Jordan-HT/Capstone/README.md

# Capstone
A capstone (senior) project for my BSEE at OIT
More updates to come
