Jordan-HT/Capstone/Documentation/PDN/Board Power Requirements.xlsx

Sheet: FPGA Requirements
Rail | Voltage (V) | Current (A) | Accuracy (%) | Accuracy (V) | Category | Description | Sequence | Notes
VCCINT | 1.000 | 8.800 | ±3 | 0.97-1.03 | Core | Internal supply voltage | 1
VCCAUX | 1.800 | 1.850 | ±5 | 1.71-1.89 | Core | Auxiliary supply voltage | 2
VCCBRAM | 1.000 | 0.165 | ±3 | 0.97-1.03 | Core | Supply voltage for BRAM | 1
VCCBATT | 1.445 | 1.5e-07 | +30 -20 | 1.00-1.89 | Core | Key memory battery backup supply | - | Connect to GND or VCCAUX for prototype
VMGTAVCC | 1.000 | 1.900 | +8 -3 | 0.97-1.08 | GTX | Analog supply voltage for the GTX transceiver | 1 | Each voltage supply requires the filter circuit described in UG476
VMGTAVTT | 1.200 | 1.000 | ±2.5 | 1.17-1.23 | GTX | Analog supply voltage for the GTX terminations | 2 | Each voltage supply requires the filter circuit described in UG476
VMGTVCCAUX | 1.800 | 0.100 | ±2.5 | 1.75-1.85 | GTX | Auxiliary analog QPLL voltage supply | 2 | Each voltage supply requires the filter circuit described in UG476
VMGTAVTTRCAL | 1.200 | 0.100 | ±2.5 | 1.17-1.23 | GTX | Analog supply voltage for the resistor calibration circuit | 2 | Each voltage supply requires the filter circuit described in UG476
VCCADC | 1.800 | 0.050 | ±5 | 1.71-1.89 | XADC | XADC supply relative to GNDADC | 2
VREFP | 1.250 | 0.010 | N/A | 1.20-1.30 | XADC | Externally supplied reference voltage (+) | 2 | Determines accuracy of the XADC system; make as accurate as possible
IO_XXX[P/N]_XX_VREF_nn | N/A | N/A | N/A | N/A | I/O | Externally supplied reference voltage for [nn] bank | - | Use internal VREF to free up these pins as normal I/O
VCCAUX_IO | 1.800 | 0.500 | ±5 | 1.71-1.89 | I/O | Auxiliary supply voltage for singled ended I/O on HP banks | 2 | Connect to VCCAUX unless fast DDR3 is needed. If so, re-spec to 2.0V
VCCO_32/33/34 | 1.800 | 2.250 | ±5 | 1.71-1.89 | I/O | Supply voltage for HP banks 32, 33, & 34 | 2
VCCO_12/13/15/16 | 1.800 | 1.000 | ±5 | 1.71-1.89 | I/O | Supply voltage for HR banks 12, 13, 15 & 16 | 2
VCCO_14 | 3.300 | 2.650 | ±5 | 3.14-3.47 | I/O | Supply voltage for HR bank 14 | 3 | Chosen as a 3.3V bank for GPIO and FLASH
VCCO_0 | 3.300 | 0.100 | ±5 | 3.14-3.47 | I/O | Supply voltage for bank 0 (configuration bank & JTAG) | 3
VCC_QSFP | 3.300 | 0.650 | ±5 | 3.14-3.47 | SFP | Supply voltage for QSFP+ modules | 3
VCC_FLASH_CORE | 3.300 | 0.200 | ±5 | 3.14-3.47 | MEM | Supply voltage for config memory core | 3 | Over worst-case when using S25FL128SAGMFBR00
VCC_FLASH_IO_(OPT) | 1.800 | 0.100 | ±5 | 1.71-1.89 | MEM | Supply voltage for config memory I/O | 2
VCC_CONN | 3.300 | 2.000 | ±5 | 3.14-3.47 | CONN | Supply voltage for connected devices | 3
VCC_CONN_IO | 1.800 | 1.200 | ±5 | 1.71-1.89 | CONN | Supply voltage for connected devices (Digital I/O) | 2

Sheet: Rail Specs
Rail name | Rail voltage (V) | Voltage accuracy requirement (%) | Rail current requirement (A) | TI Suggested Current (A) | Target max current (A) | Sequence | Notes | Implementation | Total max power (W): | 45.0175
3V3_STBY | 3.300 | ±5 | 0.500 | N/A | 0.650 | 0 | Always on | TPS74801DRCR from input rail (5V0). Set PG as master EN and gate with prog switch (https://www.mouser.com/ProductDetail/Texas-Instruments/TPS74801DRCR?qs=MiEMpo83RV6vgm8Iaojmyg%3D%3D)
3V3 | 3.300 | ±5 | 5.600 | 1.500 + CONN | 6.000 | 3 |  | TPS62870QWRXSRQ1 from input rail (5V0). Use SN74AUP1G58DRLR for EN gate (PWR_FAIL) (https://www.mouser.com/ProductDetail/Texas-Instruments/TPS62870QWRXSRQ1?qs=vvQtp7zwQdOlB9azhvOVww%3D%3D)
1V8 | 1.800 | ±2.5 | 7.050 | 3.200 + CONN | 8.000 | 2 |  | TPS62871QWRXSRQ1 from input rail (5V0) (https://www.mouser.com/ProductDetail/Texas-Instruments/TPS62871QWRXSRQ1?qs=rQFj71Wb1eWRjSwVt%2FOCTA%3D%3D)
1V25_REF | 1.250 | - | 0.010 | N/A | 0.100 | 2 or 3 | High accuracy req | REF35125(QDBVR) from 1V8 (https://www.mouser.com/ProductDetail/Texas-Instruments/REF35125QDBVR?qs=IPgv5n7u5QYKyzLKZBY3kg%3D%3D)
1V2 | 1.200 | ±2.5 | 1.100 | 0.750 | 1.500 | 2 |  | TPS628502DRLR from from input rail (5V0) (https://www.mouser.com/ProductDetail/Texas-Instruments/TPS628502DRLR?qs=Wj%2FVkw3K%252BMAYwjUrVjg5sw%3D%3D)
1V0 | 1.000 | ±3 | 10.865 | 9.500 | 12.000 | 1 |  | TPS62872QWRXSRQ1 from input rail (5V0) (https://www.mouser.com/ProductDetail/Texas-Instruments/TPS62872QWRXSRQ1?qs=rQFj71Wb1eXuKsnQxp828g%3D%3D)
