Jordan-HT/Capstone/Documentation/FPGA/Bank_Plan_Kintex7160T_2FFG676I.png

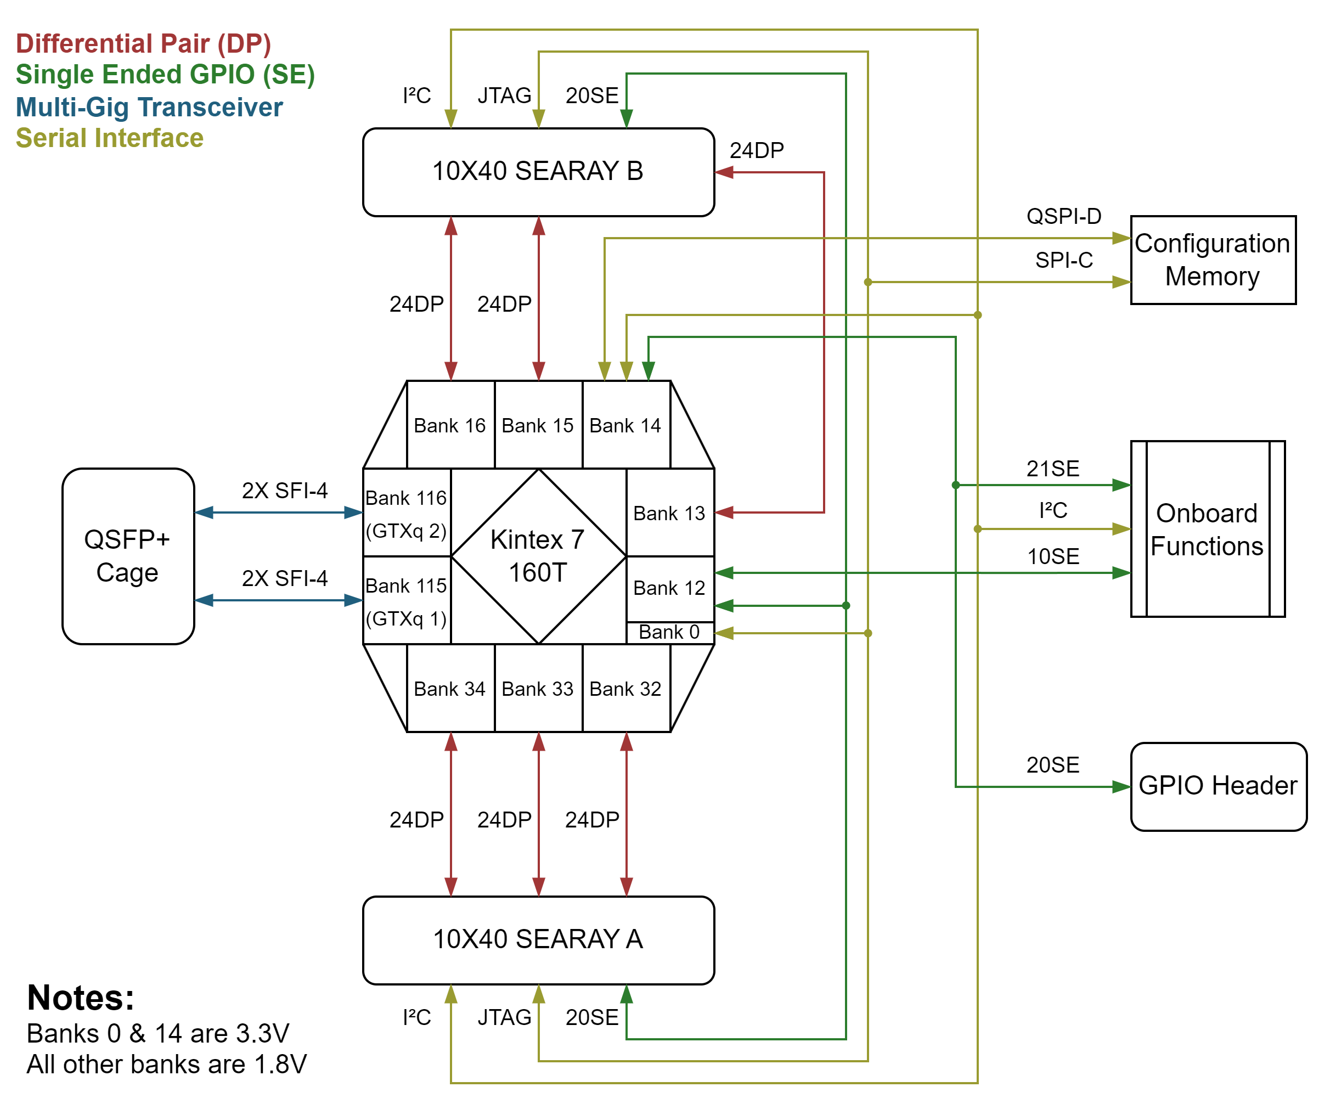
Documentation/FPGA/Bank_Plan_Kintex7160T_2FFG676I.png
