Jordan-HT/Capstone/Documentation/FPGA/Kintex7_160T_FFG676_Banks.png

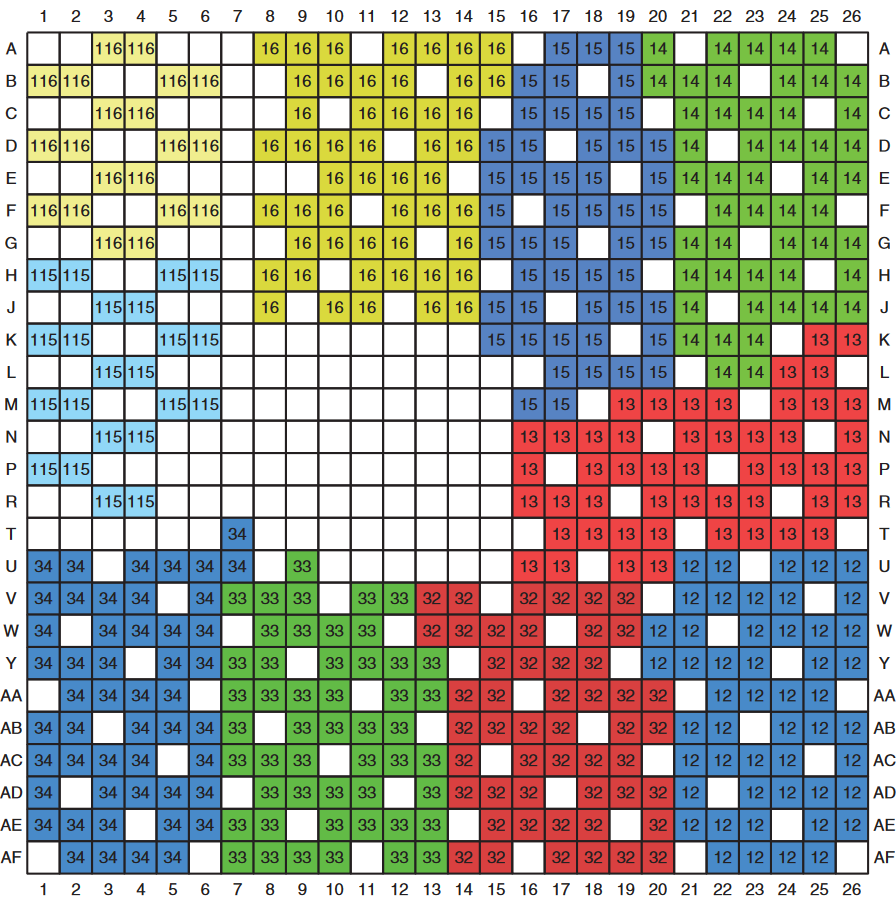
Documentation/FPGA/Kintex7_160T_FFG676_Banks.png
