Jordan-HT/Capstone/Altium/Capstone_Mainboard_B/Project Outputs for Capstone_Mainboard_B/Capstone_Mainboard_B_BOM.xlsx

Comment | Description | Designator | Footprint | Quantity | Manufacturer | Manufacturer Part Number | Manufacturer2 | Manufacturer2 Part Number
MT25QL128 | FLASH - NOR Memory IC 128Mbit SPI (Q)SPI 133 MHz 8-SO In ACA-SPI-004-K01 socket | A1, A2 | LOTES_ACA-SPI-004-K01 | 2 | Micron Technology Inc | MT25QL128ABA1ESE | LOTES | ACA-SPI-004-K01
0.1u | 0.1µF 16V X7R SMD ceramic capacitor in 0402 size | C1, C2, C4, C5, C6, C7, C8, C9, C10, C13, C15, C19, C20, C21, C22, C23, C24, C26, C28, C30, C32, C34, C36, C38, C41, C42, C50, C51, C59, C60, C70, C71, C90, C94, C100, C119, C120, C121, C122, C123, C124 | C_0402_Generic | 41 | Murata Electronics | GRM155R71C104KA88D
1u | 1µF 10V X7R SMD ceramic capacitor in 0402 size | C3, C11, C91, C95, C101 | C_0402_Generic | 5 | Murata Electronics | GRM155Z71A105KE01D
10u | 10µF 10V X5R SMD ceramic capacitor in 0402 size | C12, C16, C40, C43, C49, C52, C58, C61, C79, C85, C87, C88, C92, C93, C97 | C_0402_Generic | 15 | YAGEO | CC0402MRX5R6BB106
4.7u | 4.7µF 10V X5R SMD ceramic capacitor in 0402 size | C14, C69, C72, C78, C102, C103, C104, C110, C111, C112 | C_0402_Generic | 10 | Murata Electronics | GRM155R61A475MEAAJ
330u | 330µF 10V Aluminum polymer capacitor, KEMET EK | C17, C18, C80 | KEMET_EK_Radial | 3 | KEMET | A759EK337M1AAAE018
22u | 22µF 6.3V X5R SMD ceramic capacitor in 0603 size | C25, C27, C29, C31, C33, C35, C37, C39, C84, C86, C96, C98 | C_0603_Generic | 12 | Murata Electronics | GRM188R60J226MEA0D
270u | 270µF 2V 9mOhm SMD tantalum capacitor in EIA-3528-21size | C44, C45 | C_TANT_EIA-3528-21_A | 2 | Panasonic | 2TPSF270M9G
680p | 680pF 50V C0G/NP0 SMD ceramic capacitor in 0402 size | C46 | C_0402_Generic | 1 | Murata Electronics | GCM1555C1H681FA16D
10p | 10pF 50V C0G/NP0 SMD ceramic capacitor in 0402 size | C47, C48, C56, C57, C67, C68, C76, C77, C83 | C_0402_Generic | 9 | Murata Electronics | GRM1555C1H100JA01D
150u | 150µF 6.3V 25mOhm SMD tantalum capacitor in EIA-3528-21size | C53, C54 | C_TANT_EIA-3528-21_B | 2 | Vishay Polytech | T55B157M6R3C0025
2700p | 2700pF 50V X7R SMD ceramic capacitor in 0402 size | C55, C66 | C_0402_Generic | 2 | Murata Electronics | GCM155R71H272KA37D
47u | 47µF 6.3V X5R SMD ceramic capacitor in 0603 size | C62, C63, C64, C65, C73, C74, C89, C99, C113, C114, C115, C116, C117, C118 | C_0603_Generic | 14 | Murata Electronics | GRM188R60J476ME15D
6800p | 6800pF 25V X7R SMD ceramic capacitor in 0402 size | C75, C81, C82 | C_0402_Generic | 3 | Murata Electronics | GRM155R71E682KA01D
100u | 100µF 6.3V X5R SMD ceramic capacitor in 0805 size | C105, C106, C109 | C_0805_Generic | 3 | Murata Electronics | GRM21BR60J107ME15L
330u | 330µF 2.5V 15mOhm SMD tantalum capacitor in EIA-3528-21size | C107, C108 | C_TANT_EIA-3528-21_B | 2 | KEMET | T520B337M2R5ATE015
V30K45 | Schottky Diode 45V 30A FLATPAK, Vishay | D1 | Vishay_FlatPAK_5x6 | 1 | Vishay General Semiconductor | V30K45-M3/H
APB3025SEKCGKC-F01 | LED 1210 Green/Orange dual 2.1Vf 160deg 60/300 mcd@20mA | D2, D3, D4 | KINGBRIGHT_1210_DUAL | 3 | Kingbright | APB3025SEKCGKC-F01
USB4145-03-0230-C | USB 2.0 TYPE-C RECPT VERT XL TABS SMT | J1 | USB4145-03-0230-C | 1 | GCT | USB4145-03-0230-C
796638-3 | 3 Position Terminal Block Header, Male Pins, Shrouded NOTE: Mating wire-to-pin socket is 796635-3 | J2 | TE_796638-3 | 1 | TE Connectivity | 796638-3 | TE Connectivity | 796635-3
PH2-20-UA | THT Header 20 (2x10) position 0.1" | J3 | ADAM_TECH_PH2-20-UA | 1 | Adam Tech | PH2-20-UA
QSFP+ Cage/Conn | Amphenol 38 Position QSFP+ receptacle and cage | J4, J5 | AMPHENOL_U95T151100A | 2 | Amphenol ICC | U95-T151-100A | Amphenol ICC | FS1-Z38-20Z6-60
ASP-134486-01 | 400 Position Connector Array, Female Sockets Surface Mount Gold | J6, J7 | SAMTEC_ASP-134486-01 | 2 | Samtec | ASP-134486-01
TC-XILINX6_6PIN | 6-pin (legless) Xilinx JTAG Tag-Connect site | J8, J9, J10 | TAG-CONNECT_NO-LEGS_6PIN | 3 | NONE | NONE | Tag-Connect | TC2030-IDC-NL
U.FL | U.FL (UMCC) Connector, SMD, 50Ohm | J11, J12 | TE_IPEX | 2 | TE Connectivity | CONUFL001-SMD-T
1u | 1µH Shielded 3.3A 40mOhm 1008 Inductor | L1, L2, L3, L4, L5, L6 | Murata_Ind_1008 | 6 | Murata Electronics | DFE252012F-1R0M=P2
0.15u | Inductor 150nH 3.3mOhm 25.4A AEC-Q200, TDK | L7, L8, L9, L10 | TDK_CLT32 | 4 | EPCOS/TDK | CLT32-17N
M2.5 Mounting Hole | M.2 Mounting hole | MH1, MH2, MH3, MH4, MH5, MH6, MH7, MH8, MH9, MH10 | M2.5_MOUNTING_HOLE | 10 | NONE | NONE
4K7 | 4.7KOhm 1% 1/10W SMD resistor in 0402 size | R1, R2, R3, R37, R38, R39, R40, R41, R42, R43, R44, R45, R46, R47, R48, R49, R50, R51, R52, R53, R54, R55, R56, R57, R58, R59, R60, R61, R111, R117, R118, R122, R123, R124, R125, R126, R134, R135 | R_0402_Generic | 38 | Panasonic | ERJ-2RKF4701X
27R | 27Ohm 1% 1/10W SMD resistor in 0402 size | R4, R5, R127, R128, R129, R130 | R_0402_Generic | 6 | Panasonic | ERJ-2RKF27R0X
1K15 | 1.15KOhm 1% 1/10W SMD resistor in 0402 size | R6, R19, R96, R105, R136, R137, R138, R139 | R_0402_Generic | 8 | Panasonic | ERJ-2RKF1151X
10K | 10KOhm 1% 1/10W SMD resistor in 0402 size | R7, R8, R9, R10, R11, R12, R13, R14, R20, R84, R90, R97, R102, R107, R113 | R_0402_Generic | 15 | Panasonic | ERJ-2RKF1002X
3K57 | 3.57KOhm 1% 1/10W SMD resistor in 0402 size | R15, R104, R109, R114, R115, R116 | R_0402_Generic | 6 | Panasonic | ERJ-2RKF3571X
6K2 | 6.2KOhm 1% 1/10W SMD resistor in 0402 size | R16, R81, R110 | R_0402_Generic | 3 | Panasonic | ERJ-2RKF6201X
5K11 | 5.11KOhm 1% 1/10W SMD resistor in 0402 size | R17, R18, R83 | R_0402_Generic | 3 | Panasonic | ERJ-2RKF5111X
47K | 47KOhm 1% 1/10W SMD resistor in 0402 size | R21, R23, R24, R80, R82, R86, R87, R92, R93, R94, R99, R100, R106 | R_0402_Generic | 13 | Panasonic | ERJ-2RKF4702X
0 | Jumper 0Ohm SMD resistor in 0402 size | R22, R62, R63, R64, R65, R66, R67, R68, R69, R70, R71, R72, R73, R74, R75, R76, R77, R78, R79, R131, R132, R133 | R_0402_Generic | 22 | Panasonic | ERJ-2GE0R00X
1K | 1KOhm 1% 1/10W SMD resistor in 0402 size | R25, R26, R27, R28, R29, R30, R31, R32, R33, R34, R35, R36, R85, R88, R89, R91, R98, R103, R108 | R_0402_Generic | 19 | Panasonic | ERJ-2RKF1001X
261R | 261Ohm 1% 1/10W SMD resistor in 0402 size | R95, R101, R112 | R_0402_Generic | 3 | Panasonic | ERJ-2RKF2610X
49R9 | 49.9Ohm 0.5% 1/16W SMD resistor in 0402 size | R119, R120 | R_0402_Generic | 2 | Panasonic | ERJ-2RKD49R9X
100R | 100Ohm 0.5% 1/16W SMD resistor in 0402 size | R121 | R_0402_Generic | 1 | Panasonic | ERJ-2RHD1000X
KSC353J_LFG | Tactile Switch SPST-NO (MOM) SMD back actuator | SW1 | C&K_KSC_6.20 | 1 | C&K | KSC353J LFG
KSC401J_50SH_LFS | Tactile Switch SPST-NO (MOM) SMD red long actuator | SW2 | C&K_KSC_6.20 | 1 | C&K | KSC401J 50SH LFS
TDA04H0SB1R | Dip Switch SPST 4 Position 25mA 24VDC | SW3 | C&K_TDA_GULL_04POS | 1 | C&K | TDA04H0SB1R
THJP0612AST1 | ThermaWick Thermal Jumper 0612 | TJ1, TJ2 | ThermaWick_0612 | 2 | Vishay Dale | THJP0612AST1
RP2040_RUN Test Point | SMD Test point 3mm circle | TP1 | TP_3MM | 1 | NONE | NONE
3V3AUX Test Point | SMD Test point 3mm circle | TP2 | TP_3MM | 1 | NONE | NONE
SWCLK Test Point | SMD Test point 3mm circle | TP3 | TP_3MM | 1 | NONE | NONE
SWDIO Test Point | SMD Test point 3mm circle | TP4 | TP_3MM | 1 | NONE | NONE
SWDGND Test Point | SMD Test point 3mm circle | TP5 | TP_3MM | 1 | NONE | NONE
EXT I2C GND Test Point | SMD Test point 3mm circle | TP6 | TP_3MM | 1 | NONE | NONE
EXT I2C SDA Test Point | SMD Test point 3mm circle | TP7 | TP_3MM | 1 | NONE | NONE
EXT I2C SCL Test Point | SMD Test point 3mm circle | TP8 | TP_3MM | 1 | NONE | NONE
FPGA B14 L6N/VREF Test Point | SMD Test point 3mm circle | TP9 | TP_3MM | 1 | NONE | NONE
FPGA B14 L7P Test Point | SMD Test point 3mm circle | TP10 | TP_3MM | 1 | NONE | NONE
FPGA nRESET Test Point | SMD Test point 3mm circle | TP11 | TP_3MM | 1 | NONE | NONE
FPGA DOUT Test Point | SMD Test point 3mm circle | TP12 | TP_3MM | 1 | NONE | NONE
RP2040 | ARM Cortex-M0+ - Microcontroller IC 32-Bit Dual-Core 133MHz External Program Memory 56-QFN (7x7) | U1 | RP2040/SC0914 QFN-56 | 1 | Raspberry Pi | SC0914(7)
NSP4201MR6T1G | 4CH 6V Break 12V Clamp TVS Diode USB | U2 | ONSEMI_6-TSOP | 1 | onsemi | NSP4201MR6T1G
PCA9548A | 8-channel I 2 C-bus switch, 24-HVQFN | U3 | HVQFN24_NXP | 1 | NXP | PCA9548ABS,118
M24128-BFMH6TG | EEPROM 128Kbit I2C 1MHz 450 ns | U4 | STM_DFN5 | 1 | STMicroelectronics | M24128-BFMH6TG
TMP1075N | Temperature Sensor Digital, Local -40°C ~ 125°C 12 b SOT-563 | U5, U6, U7 | TI_SOT-563 | 3 | Texas Instruments | TMP1075NDRLR
TPS62873Q | Switching Voltage Regulators Automotive 2.7-V to 6-V input, 15-A, stackable, synchronous buck converter 16-VQFN-FCRLF -40 to 125C | U8, U9, U10, U11 | TPS6287x-Q1 | 4 | Texas Instruments | TPS62873QWRXSRQ1
TPS74801DRCR | LDO 1.5A 10-VSON | U12 | TI_10VSON_DRC0010J_ADDVIA | 1 | Texas Instruments | TPS74801DRCR
AP7176BFN-7 | LDO 0.8-3.12V 3A 10-UFDFN Diodes Incorporated | U13, U14, U15 | DIODES_INC_U-DFN3030-10 | 3 | Diodes Incorporated | AP7176BFN-7
XC7K160T-2 | Kintex-7 FPGA, 400 User I/Os, 8 GTX, 676-Ball BGA, Speed Grade 2, Industrial Grade, Pb-Free | U16 | FFG676_(XC7K160T-2FFG676I) | 1 | AMD/Xilinx | XC7K160T-2FFG676I
DSC1123CI2-156.2500T | MEMS OSC XO 156.2500MHZ LVDS SMD | U17 | Microchip_DSC1123CI2 | 1 | Microchip Technology | DSC1123CI2-156.2500T
DSC1123CI2-200.0000 | MEMS OSC XO 200.0000MHZ LVDS SMD | U18 | Microchip_DSC1123CI2 | 1 | Microchip Technology | DSC1123CI2-200.0000
514CCC000107BAG | I2C Programmable oscillator differential/single-ended 0.1-125 MHz | U19 | Si514_Size-B | 1 | Skyworks Solutions | 514CCC000107BAG
ECS-1612MV-120 | 12 MHz XO (Standard) CMOS Oscillator 1.6V ~ 3.63V Standby (Power Down) 4-SMD, No Lead | X1 | ECS 4-SMD (1.6X1.2) | 1 | ECS Inc | ECS-1612MV-120-CN-TR
