Jordan-HT/Capstone/Documentation/PDN/Kintex-7_Worst_Case_Est.xlsm

Sheet: Summary
 |  |  | Xilinx Power Estimator (XPE) - 2019.1.2 |  |  |  |  |  |  |  |  |  |  |  |  |  |  |  |  |  |  |  |  |  |  |  |  | 1 |  | Pkgs | 1 | CLKROW | CLKCOL | LUT | FF | BRAM | MMCM | PLL | DSP | GT | PCIE |  | 3.3 Pins | Pins | Banks | ThetaJA | ThetaJB
 |  | Spartan®-7, Artix®-7, Kintex®-7, Virtex®-7, Zynq®-7000 |  |  |  |  |  |  |  |  |  |  | Release: 14-Aug-2019 |  |  |  |  |  |  |  |  |  |  |  |  |  |  |  |  | FBG484 | 17 | 5 | 70 | 101400 | 202800 | 325 | 8 | 8 | 600 | 8 | 1 | 0 | 250 | 400 | 17 | 11.7 | 4
 |  |  |  |  |  |  |  |  |  |  |  |  |  |  |  |  |  |  |  |  |  |  |  |  |  |  |  |  |  | FBG676 | 2 | 1 |  | 70016 |  |  |  |  |  | 0
 |  |  |  |  |  |  |  |  |  |  |  |  |  |  |  |  |  |  |  |  |  |  |  |  |  |  |  |  |  | FFG676 |  | 1
Project |  |  |  |  |  |  |  |  |  |  |  |  |  |  |  |  |  |  |  |  |  |  |  |  |  |  |  |  |  | FBV484 |  |  |  |  |  |  |  |  |  | 0
Settings |  |  |  |  | Summary |  |  |  |  |  |  |  |  |  |  |  |  |  |  |  |  |  |  |  |  |  |  |  |  | FBV676
Device |  |  |  |  | Total On-Chip Power |  |  | 28.885 W |  |  | 10.18937876% | Transceiver…… |  | 2.943W |  |  |  |  |  |  |  |  |  |  |  |  |  |  |  | FFV676
Family | Kintex-7 |  |  |  |  |  |  |  |  |  | 54.49917071% | I/O……………… |  | 15.742W
Device | XC7K160T |  |  |  | Junction Temperature |  |  | 99.6 °C |  |  | 31.61437363% | Core Dynamic.. |  | 9.132W
Package | FFG676 |  |  |  | Thermal Margin |  |  | 0.4°C | 0.2W |  | 3.697076908% | Device Static….. |  | 1.068W |  |  |  |  |  |  |  |  |  |  |  |  |  | 10 | 27.92 | 0.11
Speed Grade | -2 |  |  |  | Effective ΘJA |  |  | 2.2 °C/W |  | Power supplied to off-chip devices… |  |  |  | 0.000W |  |  |  |  |  |  |  |  |  |  |  |  |  | 25 | 27.95 | 0.13
Temp Grade | Industrial |  |  |  |  |  |  |  |  |  |  |  |  |  |  |  |  |  |  |  |  |  |  |  |  |  |  | 40 | 27.99 | 0.18
Process | Typical |  |  |  | On-Chip Power |  |  |  |  |  | Power Supply |  |  |  |  |  |  |  |  |  |  |  |  |  |  |  |  | 55 | 28.08 | 0.26
Voltage ID Used | No |  |  |  | Resource |  |  | Power |  |  | Source |  | Voltage | Total (A) | Static | Active |  |  |  |  |  |  |  |  |  |  |  | 70 | 28.24 | 0.42 |  |  |  |  |  | static | 0
Characterization | Production |  |  |  |  |  | (Jump to sheet) | (W) | (%) |  | VCCINT |  | 1.000 | 8.771 | 0.805 | 7.965 |  |  |  |  |  |  |  |  |  |  |  | 85 | 28.50 | 0.68 |  |  |  |  |  |  | 1
 |  |  |  |  | Core Dynamic |  |  | 1.458 | 5.047239053 |  | VCCBRAM |  | 1.000 | 0.162 | 0.049 | 0.113 |  |  |  |  |  |  |  |  |  |  |  | 100 | 28.91 | 1.10 |  |  |  |  |  |  | 1
Environment |  |  |  |  |  |  |  | 3.401 | 11.77471862 |  | VCCAUX |  | 1.800 | 1.831 | 0.056 | 1.775 |  |  |  |  |  |  |  |  |  |  |  |  |  |  |  |  |  |  |  |  | 1
Junction Temperature |  |  | 99.6 °C |  |  |  |  | 1.859 | 6.434258056 |  | VCCAUX_IO |  | 2.060 | 0.000 | 0.000 | 0.000 |  |  |  |  |  |  |  |  |  |  |  | 0.97 | 28.30 |  |  |  |  |  |  |  | 1
Ambient Temp | 35.0 °C |  |  |  |  |  |  | 0.882 | 3.052685526 |  | VCCO 3.3V |  | 3.300 | 2.526 | 0.001 | 2.525 |  |  |  |  |  |  |  |  |  |  |  | 0.985 | 28.59 |  |  |  |  |  |  | 0.001 | 1
Effective ΘJA |  |  | 2.2 °C/W |  |  |  |  | 0.743 | 2.572507508 |  | VCCO 2.5V |  | 2.500 | 0.000 | 0.000 | 0.000 |  |  |  |  |  |  |  |  |  |  |  | 1 | 28.89 |  |  |  |  |  |  | 0 | 1
Airflow | 250 LFM |  |  |  |  |  |  | 0.784 | 2.713092859 |  | VCCO 1.8V |  | 1.800 | 3.130 | 0.001 | 3.129 |  |  |  |  |  |  |  |  |  |  |  | 1.015 | 29.19 |  |  |  |  |  |  | 0.001 | 1
Heat Sink | High Profile |  |  |  |  |  |  | 0.006 | 0.01987201133 |  | VCCO 1.5V |  | 1.500 | 0.000 | 0.000 | 0.000 |  |  |  |  |  |  |  |  |  |  |  | 1.03 | 29.51 |  |  |  |  |  |  | 0 | 1
ΘSA | 2.8 °C/W |  |  |  |  |  |  | 0.000 | 0 |  | VCCO 1.35V |  | 1.300 | 0.000 | 0.000 | 0.000 |  |  |  |  |  |  |  |  |  |  |  |  |  |  |  |  |  |  |  | 0 | 1
Board Selection | Small (4"x4") |  |  |  | I/O |  |  | 15.742 | 54.49917071 |  | VCCO 1.2V |  | 1.200 | 0.000 | 0.000 | 0.000 |  |  |  |  |  |  |  |  |  |  |  |  |  |  |  |  |  |  |  | 0 | 1
# of Board Layers | 8 to 11 |  |  |  | Transceiver |  |  | 2.943 | 10.18937876 |  | MGTVCCAUX |  | 1.800 | 0.042 | 0.001 | 0.041 |  |  |  |  |  |  |  |  |  |  |  |  |  |  |  |  |  |  |  |  | 1
ΘJB | 4.0 °C/W |  |  |  |  |  |  | 0.000 | 0 |  | MGTAVCC |  | 1.000 | 1.866 | 0.061 | 1.805 |  |  |  |  |  |  |  |  |  |  |  |  |  |  |  |  |  |  |  |  | 1
Board Temperature | 25.0 °C |  |  |  |  |  |  | 0.000 | 0 |  | MGTAVTT |  | 1.200 | 0.590 | 0.007 | 0.583 |  |  |  |  |  |  |  |  |  |  |  | Temp | 50 | 85 | 100 |  |  |  |  |  | 1
 |  |  |  |  |  |  |  | 0.000 | 0 |  | - |  | 1.850 | 0.000 | 0.000 | 0.000 |  |  |  |  |  |  |  |  |  |  |  | Typical (1.0V) | 28.05 | 28.50 | 28.9145924 |  |  |  |  | 0 | 1
Implementation |  |  |  |  | Device Static | 1.068 |  | 1.068 | 3.697076908 |  | - |  | 1.100 | 0.000 | 0.000 | 0.000 |  |  |  |  |  |  |  |  |  |  |  | Maximum (1.03V) | 28.75 | 29.53 | 30.19191886 |  |  |  |  | 0 | 1
Optimization | Default |  |  | 1 |  |  |  |  |  |  | - |  | 1.100 | 0.000 | 0.000 | 0.000 |  |  |  |  |  |  |  |  |  |  |  |  |  |  |  |  |  |  |  | 0 | 1
 |  |  |  |  |  |  |  |  |  |  | - |  | 1.500 | 0.000 | 0.000 | 0.000 |  |  |  |  |  |  |  |  |  |  |  |  |  |  |  |  |  |  |  |  | 1
Messages |  |  |  |  |  |  |  |  |  |  | - |  | 1.800 | 0.000 | 0.000 | 0.000 |  |  |  |  |  |  |  |  |  |  |  |  |  |  |  |  |  |  |  |  | 1
 |  |  |  |  |  |  |  |  |  |  | - |  | 1.800 | 0.000 | 0.000 | 0.000 |  |  |  |  |  |  |  |  |  |  |  |  |  |  |  |  |  |  |  |  | 1
 |  |  |  |  |  |  |  |  |  |  | VCCADC |  | 1.800 | 0.021 | 0.020 | 0.001 |  |  |  |  |  |  |  |  |  |  |  |  |  |  |  |  |  |  |  | 0.02 | 1
XILINX Power Advantage (check for updates) (http://www.xilinx.com/products/technology/power/index.htm) |  |  |  | File Support Request (WebCase) (https://www.xilinx.com/support.html) |  |  |  |  |  |  | Xilinx Power Estimator User Guide (http://www.xilinx.com/cgi-bin/docs/rdoc?l=en;v=latest;d=ug440-xilinx-power-estimator.pdf)
© Copyright 1994-2019 Xilinx, Inc. All Rights Reserved |  |  |  | Introduction to XPE (video) (http://www.xilinx.com/training/vivado/using-the-xilinx-power-estimator.htm) |  |  |  | Whitepaper - 7 Steps for Worst Case Power Estimation (http://www.xilinx.com/support/documentation/white_papers/wp353.pdf)
Legend |  | User Entry |  |  | Calculated Value |  | Summary Value |  |  | User Override |  | Warning |  | Error
 |  |  |  |  |  |  |  |  |  |  |  |  |  |  |  |  |  |  | JEDEC | 7.5
 |  |  |  |  | Piccq | Iccauxq | Tj | Iccq |  |  |  |  |  |  |  |  |  |  | BoardType | 1 |  | Airflow | Opt | Leakage | 1.068 | 805.3106852 | Utilization
 |  |  |  | 0.04889450342 | 0 | 0.05610904591 | 99.13452462 | 0.8021941101 | Non-int Leakage | 0.1091 |  |  |  |  |  |  |  |  | BoardLyr | 1 |  | N/A | Default | CLOCK | 1.4579025 | 48.89450342
 |  |  | Temp | 99.13452462 | 0 | 0.0562628304 | 99.24375758 | 0.8051067988 | Scaled ICCQ_D | 0.0428 |  |  |  | Max Adj | Typ Adj |  |  |  | Airflow | 1 |  | 0 | Power Optimization | LOGIC | 3.401144968 | 56.27359558
 |  |  | Initial | 97.39240871 | 0 | 0.05627289126 | 99.25089206 | 0.8052973458 | Non-aux Leakage | 0.1207 |  |  | MMF Factor | 1 | 1 |  |  |  | Heatsink | 4 |  | 250 | Powered Off | BRAM | 1.858545 | 0
 |  |  | Max | 125 | 0 | 0.05627354951 | 99.2513588 | 0.8053098127 | Scaled ICCAUXQ_D | 0.1502 |  |  | MMF Aux | 1 | 1 |  |  |  | Pkg size | 729 |  | 500 | Y44:Y45 | DSP | 0.88177275 | 1
 |  |  |  |  | 0 | 0.05627359258 | 99.25138934 | 0.8053106284 | Iccint_c1 | 2.692687131e-05 |  |  | MMF Bram | 1 | 1 |  |  |  | Air | 228.6236854 |  | 750 |  | PLL | 0.743072616 | 0
 |  |  |  |  | 0 | 0.0562735954 | 99.25139133 | 0.8053106817 | Iccint_c2 | 0.0086 |  |  | VID Factor | 1 |  |  |  |  | ThetaSA | 2.800 |  | X46:X47 |  | MMCM | 0.7836809035 | 1
 |  |  |  |  | 0 | 0.05627359558 | 99.25139146 | 0.8053106852 | Iccintq_d | 0.0399 |  |  | Bali Factor | 1 |  |  |  |  | ThetaCS | 0.100 |  |  |  | PHASER | 0 | 0
 |  |  |  |  |  |  |  |  | Iccintq_des | 0.0428 |  |  | Vccint | 5.97433655e-06 | 2.692687131e-05 | 0.00856550694 | 0.8650776558 | 10.18509974 | ThetaJB | 4.000 |  |  |  | PCIE | 0 | 0
 |  |  |  |  |  |  |  |  | Iccaux_c1 | -4.061474262e-06 |  |  | Vccaux | 3.394515455e-07 | -4.061474262e-06 | 0.001063242872 | -0.008234017716 | 17.64789461 | ThetaJA | 6.698 |  |  |  | IO | 15.74216644 | 0
 |  |  |  |  |  |  |  |  | Iccaux_c2 | 0.0011 |  |  | Vccbram | 2.790738785e-07 | -5.712713873e-06 | 4.518674537e-05 | 0.0292292509 | 0.1271399549 | ThetaJX | 6.899 |  |  |  | GTX | 2.943217194 | 0.7452186936
 |  |  |  |  |  |  |  |  | Iccauxq_d | 0.0182 |  |  |  |  |  |  |  |  | eThetaJA | 2.237 |  |  |  |  | 0 | 61.32305353
 |  |  |  |  |  |  |  |  | Iccoq | 0.0010 |  |  |  |  |  |  |  |  | TJA-Top | 3.210 |  |  |  |  |  | 7.20337527
 |  |  |  |  |  |  |  |  | Iccbram_c1 | -5.712713873e-06 |  |  |  |  |  |  |  |  | TJ | 81.988 |  |  |  |  |  | 0
 |  |  |  |  |  |  |  |  | Iccbram_c2 | 4.518674537e-05 |  |  |  |  |  |  |  |  | eThetaJA | 1.631 |  |  |  |  |  | 0
 |  |  |  |  |  |  |  |  | Iccbramq | 0.0039 | 0.002925 | 19.26616833 |  |  |  |  |  |  | Power | 29.749 |  |  |  |  |  | 0
 |  |  |  |  |  |  |  |  | Process | 1.0000 |  |  |  |  |  |  |  |  | Power2 |  |  |  |  |  |  | 0
 |  |  |  |  |  |  |  |  | I-Grade | 0.8651 |  |  |  |  |  |  |  |  | Temp | 125.000 |  |  |  |  |  | 0
 |  |  |  |  |  |  |  |  | Q-Grade | 10.1851 |  |  |  |  |  |  |  |  | Temp | 83.526 |  |  |  |  |  | 0
 |  |  |  |  |  |  |  |  | I-Grade | -0.0082 |  |  |  |  |  |  |  |  | Temp | 124.54 |  |  |  |  |  | 20
 |  |  |  |  |  |  |  |  | Q-Grade | 17.6479
 |  |  |  |  |  |  |  |  | I-Grade | 0.0292 |  |  |  | PowerUp | Int | Aux | I/O | Aux_io | Bram | Avcc | Avtt | GTVccaux
 |  |  |  |  |  |  |  |  | Q-Grade | 0.1271 |  |  |  | Adder | 0.55 | 0.05 | 0.04 | 0.04 | 0.04 | 0.4 | 0.15 | 0.04
 |  |  |  |  |  |  |  |  | Vcc_c1 | 0.0794 |  |  |  | Min | 0 | 0 | 0 | 0 | 0 | 0 | 0 | 0
 |  |  |  |  |  |  |  |  | Vcc_c2 | 2.5327
 |  |  |  |  |  |  |  |  | VccScale | 0.9994
 |  |  |  |  |  |  |  |  | VccAuxScale | 1
 |  |  |  |  |  |  |  |  | VccBramScale | 0.9994
 |  |  |  |  |  |  |  |  | AVccScale | 0.9994
 |  |  |  |  |  |  |  |  | Max bram | 0.02749303918
 |  |  |  |  |  |  |  |  | Max PS | 0
 |  |  |  |  |  |  |  |  | Max Aux | 0.1032130833
 |  |  |  |  |  |  |  |  | Max Int | 0.806708461
 |  |  |  |  |  |  |  |  | Max Ambient | 35.52017995
 |  |  |  |  |  |  |  |  | AuxSpecialFact | 1
 |  |  |  |  |  |  |  |  | Oly | 0

Sheet: Snapshot
 | Power Comparison Snapshots
Settings
Part
Ambient Temperature
Process
Implementation
Summary
Total On-Chip Power
Junction Temperature
Effective ΘJA
On-Chip Power
Clocking
Logic
I/O
BRAM
DSP
Transceiver
PS
Device Static
Supply Summary
VCCINT
VCCBRAM
VCCAUX
VCCAUX_IO
VCCO 3.3V
VCCO 2.5V
VCCO 1.8V
VCCO 1.5V
VCCO 1.35V
VCCO 1.2V
MGTVCCAUX
MGTAVCC
MGTAVTT
MGTZVCCH
MGTZAVCC
MGTZVCCL
VCCPINT
VCCPAUX
VCCPLL
VCCO_DDR
VCCO_MIO0
VCCO_MIO1
VCCADC

Sheet: Graphs
On-Chip Power over Vccint - (Typical, 99C)
On-Chip Power - (Typical, 1V)
On-Chip Power by Function - (Typical, 1V, 99C)

Sheet: IP_Manager
IP Manager |  |  |  |  |  |  |  |  |  | IP Catalog
 |  |  |  |  |  |  |  |  |  | Block Memory
Device |  |  | On-Chip Summary |  |  |  |  |  |  | Distributed Memory
Part | XC7K160TFFG676-2I |  | Junction Temp |  | 99.6 °C |  |  |  |  | Memory Interface
Process | Typical |  | Static Power |  | 1.068 W |  |  |  |  | Transceiver Interface
Effective ΘJA | 2.2 °C/W |  | Total Power |  | 28.885 W
Implementation | Default
IP Modules |  | Power (W) | Clocking* | Logic | I/O* | BRAM | DSP | Transceiver* | Source | Clock | PLL | MMCM | Logic | I/O | Phaser | BRAM | DSP | PCIE | GTP/X/H | GTZ
System |  | 7.599 | 1.458 | 3.401 |  | 1.859 | 0.882 |  | XPE Generated | B10 |  |  | B12 |  |  | B10 | B8
29

Sheet: Clock
Clock Tree Power |  |  |  |  |  |  |  |  |  |  |  |  | 700 | 32 | 30 | 20
Power |  |  |  | Utilization |  |  |  | Clocking Resources User Guide (http://www.xilinx.com/support/documentation/user_guides/ug472_7Series_Clocking.pdf)
VCCINT | 1.000V | 1.458W |  | Global | 1 | 3.125%
5% of total on-chip power 28.885W |  |  |  | Regional | 0 | 0% |  | XPE User Guide (http://www.xilinx.com/cgi-bin/docs/rdoc?l=en;v=latest;d=ug440-xilinx-power-estimator.pdf)
 |  |  |  | I/O | 0 | 0%
 |  |  |  | Other | 0 | - |  | Introduction to XPE (video) (http://www.xilinx.com/training/vivado/using-the-xilinx-power-estimator.htm)
Name |  |  | Frequency (MHz) | Type | Fanout | Clock Buffer Enable | Slice Clock Enable | Power (W) |  | HROW | LEAF | Local | HROW Utilization | LEAF Utilization | Slices
System |  |  | 500.0 | Global | 204050 | 100% | 50% | 1.458 | 0.465 | 10.675 | 287 | 1159.7625 | 10 | 700 | 25350
 |  |  |  | Global |  | 100% | 50% | 0.000 | 0 | 0 | 0 | 0 | 0 | 0 | 0
 |  |  |  | Global |  | 100% | 50% | 0.000 | 0 | 0 | 0 | 0 | 0 | 0 | 0
 |  |  |  | Global |  | 100% | 50% | 0.000 | 0 | 0 | 0 | 0 | 0 | 0 | 0
 |  |  |  | Global |  | 100% | 50% | 0.000 | 0 | 0 | 0 | 0 | 0 | 0 | 0
 |  |  |  | Global |  | 100% | 50% | 0.000 | 0 | 0 | 0 | 0 | 0 | 0 | 0
 |  |  |  | Global |  | 100% | 50% | 0.000 | 0 | 0 | 0 | 0 | 0 | 0 | 0
 |  |  |  | Global |  | 100% | 50% | 0.000 | 0 | 0 | 0 | 0 | 0 | 0 | 0
 |  |  |  | Global |  | 100% | 50% | 0.000 | 0 | 0 | 0 | 0 | 0 | 0 | 0
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
 |  |  |  | Global |  | 100% | 50% | 0.000 | 0 | 0 | 0 | 0 | 0 | 0 | 0
 |  |  |  | Global |  | 100% | 50% | 0.000 | 0 | 0 | 0 | 0 | 0 | 0 | 0
 |  |  |  | Global |  | 100% | 50% | 0.000 | 0 | 0 | 0 | 0 | 0 | 0 | 0
 |  |  |  | Global |  | 100% | 50% | 0.000 | 0 | 0 | 0 | 0 | 0 | 0 | 0
191

Sheet: Logic
Logic Power
Power |  |  |  | Utilization |  |  |  |  | CLB User Guide (http://www.xilinx.com/support/documentation/user_guides/ug474_7Series_CLB.pdf)
VCCINT | 1.000V | 3.401W |  | Registers |  | 202800 | 100%
12% of total on-chip power 28.885W |  |  |  | LUTs |  | 101400 | 100% |  | XPE User Guide (http://www.xilinx.com/cgi-bin/docs/rdoc?l=en;v=latest;d=ug440-xilinx-power-estimator.pdf)
 |  |  |  | Combinatorial |  | 101400 | 100%
 |  |  |  | Shift Registers |  | 0 | 0% |  | Introduction to XPE (video) (http://www.xilinx.com/training/vivado/using-the-xilinx-power-estimator.htm)
 |  |  |  | Distributed RAMs |  | 0
Name |  |  | Clock (MHz) | LUTs as |  |  | Registers | Toggle Rate | Average Fanout | Signal Rate (Mtr/s) | Power (W) | Routing
 |  |  |  | Logic | Shift Registers | Distributed RAMs
System |  |  | 500.0 | 101400 |  | 0 | 202800 | 12.5% | 3.00 | 62.5 | 3.401 | 0.0003987701
 |  |  |  |  |  |  |  | 12.5% | 3.00 | 0.0 | 0.000 | 0.0003987701
 |  |  |  |  |  |  |  | 12.5% | 3.00 | 0.0 | 0.000 | 0.0003987701
 |  |  |  |  |  |  |  | 12.5% | 3.00 | 0.0 | 0.000 | 0.0003987701
 |  |  |  |  |  |  |  | 12.5% | 3.00 | 0.0 | 0.000 | 0.0003987701
 |  |  |  |  |  |  |  | 12.5% | 3.00 | 0.0 | 0.000 | 0.0003987701
 |  |  |  |  |  |  |  | 12.5% | 3.00 | 0.0 | 0.000 | 0.0003987701
 |  |  |  |  |  |  |  | 12.5% | 3.00 | 0.0 | 0.000 | 0.0003987701
 |  |  |  |  |  |  |  | 12.5% | 3.00 | 0.0 | 0.000 | 0.0003987701
 |  |  |  |  |  |  |  | 12.5% | 3.00 | 0.0 | 0.000 | 0.0003987701
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
 |  |  |  |  |  |  |  | 12.5% | 3.00 | 0.0 | 0.000 | 0.0003987701
 |  |  |  |  |  |  |  | 12.5% | 3.00 | 0.0 | 0.000 | 0.0003987701
 |  |  |  |  |  |  |  | 12.5% | 3.00 | 0.0 | 0.000 | 0.0003987701
 |  |  |  |  |  |  |  | 12.5% | 3.00 | 0.0 | 0.000 | 0.0003987701
 |  |  |  |  |  |  |  | 12.5% | 3.00 | 0.0 | 0.000 | 0.0003987701

Sheet: GTX
GTX Transceiver Power |  |  |  |  |  |  |  |  |  |  |  |  |  |  |  |  |  |  |  |  |  |  |  | TRUE | 1 | 10.3125 |  | CPLL VCO range (MHz) | LC VCO range (MHz) |  |  | Raised Voltage |  |  |  |  |  |  |  |  |  |  |  | AV2:AV17
 |  |  |  |  |  |  |  |  |  |  |  |  |  |  |  |  |  |  |  |  |  |  |  |  |  |  |  | 1.2 | 5.93 | 9.8 |  | 0 |  |  |  |  |  |  |  |  |  |  | PCIe |  | 250 | 269
Active Current |  |  |  | Power |  |  |  |  | 2.943W |  | Utilization |  |  |  |  |  |  | Transceivers User Guide (http://www.xilinx.com/support/documentation/user_guides/ug476_7Series_Transceivers.pdf) |  |  |  |  |  |  | Iccq | 9.6 |  | 3.3 | 8 | 12.5 |  |  |  |  |  |  |  |  |  |  |  |  |  |  | 300 | 336
Source |  | Active |  |  |  |  |  |  |  |  | GTX Channels |  | 8 | 100% |  |  |  |  |  |  |  |  |  |  |  |  |  |  |  |  |  |  |  |  |  |  |  |  |  |  |  |  |  |  | 350 | 407
VCCINT | 1.000V | 0.364A |  | Source | Power |  | PCIe | PCS | PMA |  | PCIe Blocks |  | 0 | 0% |  |  |  | XPE User Guide (http://www.xilinx.com/cgi-bin/docs/rdoc?l=en;v=latest;d=ug440-xilinx-power-estimator.pdf) |  |  |  |  |  |  |  |  |  |  |  |  |  |  |  |  |  |  |  |  |  |  |  |  |  |  | 400 | 474
MGTVCCAUX | 1.800V | 0.041A |  | VCCINT | 0.364W |  | 0.000W | 0.364W | 2.579W |  |  |  |  |  |  |  |  |  |  |  |  |  |  |  |  |  |  |  |  |  |  |  |  |  |  |  |  |  |  |  |  |  |  |  | 450 | 543
MGTAVCC | 1.000V | 1.805A |  | MGTVCCAUX | 0.075W |  |  |  |  |  | Power Planes |  | 1 |  |  |  |  | Introduction to XPE (video) (http://www.xilinx.com/training/vivado/using-the-xilinx-power-estimator.htm) |  |  |  |  |  |  |  |  |  |  |  |  |  |  |  |  |  |  |  |  |  |  |  |  |  |  | 500 | 609
MGTAVTT | 1.200V | 0.583A |  | MGTAVCC | 1.805W |  |  |  |  |  |  |  |  |  |  |  |  |  |  |  |  |  |  |  |  |  |  |  |  |  |  |  |  |  |  |  |  |  |  |  |  |  |  |  | 550 | 677
 |  |  |  | MGTAVTT | 0.699W | 10% of total on-chip power 28.885W |  |  |  |  | BSCAN |  |  |  |  |  |  |  |  |  |  |  |  |  |  |  |  |  |  |  |  |  |  |  |  |  |  |  |  |  |  |  |  |  | 600 | 741
 |  |  |  |  |  |  |  |  |  |  |  |  |  |  |  |  |  |  |  |  |  |  |  |  |  |  |  |  |  |  |  |  |  |  |  |  |  |  |  |  |  |  |  |  | 650 | 807
 |  |  |  |  |  |  |  | RX |  |  |  | TX |  |  |  |  |  |  |  |  |  |  |  |  |  |  |  |  |  |  |  |  |  |  |  |  |  |  |  |  |  |  |  |  | 700 | 866
Name |  |  | GTX Channels | Operational Mode | EyeScan | Power Mode | Channels Sharing QPLL | Clock Source | Data Rate (Gb/s) | Data Path | Data Mode | Clock Source | Data Rate (Gb/s) | Data Path | Data Mode | O/P (mV) | OOB Used | Hard PCIe | VCCINT Power (W) | MGTVCCAUX Power (W) | MGTAVCC Power (W) | MGTAVTT Power (W) |  | Operate Mode | Quads | RX VCO LC (MHz) | TX VCO LC (MHz) | RX VCO CPLL (MHz) | TX VCO CPLL (MHz) | RX USERCLK | TX USERCLK | RX Power Mode | TX Voltage Swing Current | AVTT Current (CPLL) | AVTT Current (LC) | AVCC Current (RX) | AVCC Current (TX) | AVCC Current (CPLL) | AVCC Current (LC) | AVCC CLK | AVTT CLK |  |  | PCIe | 750 | 924
 |  |  | 2 | Transceiver | Off | DFE | 4 | QPLL | 10.1350 | 64 | 64b/66b | QPLL | 10.1350 | 64 | 64b/66b | 543 | No |  | 0.091 | 0.019 | 0.451 | 0.175 |  | 3 | 1 | 10135 | 10135 | 5067.5 | 5067.5 | 316.71875 | 316.71875 | 1 | 10.035 | 0 | 7.588257645 | 123.2014 | 60.28599167 | 0 | 16.52049587 | 25.6 | 1.55 | 10.135 | 10.135 | 0 | 800 | 973
 |  |  | 2 | Transceiver | Off | DFE | 4 | QPLL | 10.1350 | 64 | 64b/66b | QPLL | 10.1350 | 64 | 64b/66b | 543 | No |  | 0.091 | 0.019 | 0.451 | 0.175 |  | 3 | 1 | 10135 | 10135 | 5067.5 | 5067.5 | 316.71875 | 316.71875 | 1 | 10.035 | 0 | 7.588257645 | 123.2014 | 60.28599167 | 0 | 16.52049587 | 25.6 | 1.55 | 10.135 | 10.135 | 0 | 850 | 1018
 |  |  | 2 | Transceiver | Off | DFE | 4 | QPLL | 10.1350 | 64 | 64b/66b | QPLL | 10.1350 | 64 | 64b/66b | 543 | No |  | 0.091 | 0.019 | 0.451 | 0.175 |  | 3 | 1 | 10135 | 10135 | 5067.5 | 5067.5 | 316.71875 | 316.71875 | 1 | 10.035 | 0 | 7.588257645 | 123.2014 | 60.28599167 | 0 | 16.52049587 | 25.6 | 1.55 | 10.135 | 10.135 | 0 | 900 | 1056
 |  |  | 2 | Transceiver | Off | DFE | 4 | QPLL | 10.1350 | 64 | 64b/66b | QPLL | 10.1350 | 64 | 64b/66b | 543 | No |  | 0.091 | 0.019 | 0.451 | 0.175 |  | 3 | 1 | 10135 | 10135 | 5067.5 | 5067.5 | 316.71875 | 316.71875 | 1 | 10.035 | 0 | 7.588257645 | 123.2014 | 60.28599167 | 0 | 16.52049587 | 25.6 | 1.55 | 10.135 | 10.135 | 0 | 950 | 1092
 |  |  |  | Transceiver | Off | Low Power | 4 | QPLL | 5.0000 | 32 | 8b/10b | QPLL | 5.0000 | 32 | 8b/10b | 269 | No |  | 0.000 | 0.000 | 0.000 | 0.000 |  | 3 | 0 | 10000 | 10000 | 2500 | 2500 | 125 | 125 | 0 | 5.575 | 0 | 7.579332025 | 53.875 | 43.53733333 | 0 | 16.46694215 | 25.6 | 1.55 | 10 | 10 | 0 | 1000 | 1119
 |  |  |  | Transceiver | Off | Low Power | 4 | QPLL | 5.0000 | 32 | 8b/10b | QPLL | 5.0000 | 32 | 8b/10b | 269 | No |  | 0.000 | 0.000 | 0.000 | 0.000 |  | 3 | 0 | 10000 | 10000 | 2500 | 2500 | 125 | 125 | 0 | 5.575 | 0 | 7.579332025 | 53.875 | 43.53733333 | 0 | 16.46694215 | 25.6 | 1.55 | 10 | 10 | 0
 |  |  |  | Transceiver | Off | Low Power | 4 | QPLL | 5.0000 | 32 | 8b/10b | QPLL | 5.0000 | 32 | 8b/10b | 269 | No |  | 0.000 | 0.000 | 0.000 | 0.000 |  | 3 | 0 | 10000 | 10000 | 2500 | 2500 | 125 | 125 | 0 | 5.575 | 0 | 7.579332025 | 53.875 | 43.53733333 | 0 | 16.46694215 | 25.6 | 1.55 | 10 | 10 | 0
 |  |  |  | Transceiver | Off | Low Power | 4 | QPLL | 5.0000 | 32 | 8b/10b | QPLL | 5.0000 | 32 | 8b/10b | 269 | No |  | 0.000 | 0.000 | 0.000 | 0.000 |  | 3 | 0 | 10000 | 10000 | 2500 | 2500 | 125 | 125 | 0 | 5.575 | 0 | 7.579332025 | 53.875 | 43.53733333 | 0 | 16.46694215 | 25.6 | 1.55 | 10 | 10 | 0
 |  |  |  | Transceiver | Off | Low Power | 4 | QPLL | 5.0000 | 32 | 8b/10b | QPLL | 5.0000 | 32 | 8b/10b | 269 | No |  | 0.000 | 0.000 | 0.000 | 0.000 |  | 3 | 0 | 10000 | 10000 | 2500 | 2500 | 125 | 125 | 0 | 5.575 | 0 | 7.579332025 | 53.875 | 43.53733333 | 0 | 16.46694215 | 25.6 | 1.55 | 10 | 10 | 0
 |  |  |  | Transceiver | Off | Low Power | 4 | QPLL | 5.0000 | 32 | 8b/10b | QPLL | 5.0000 | 32 | 8b/10b | 269 | No |  | 0.000 | 0.000 | 0.000 | 0.000 |  | 3 | 0 | 10000 | 10000 | 2500 | 2500 | 125 | 125 | 0 | 5.575 | 0 | 7.579332025 | 53.875 | 43.53733333 | 0 | 16.46694215 | 25.6 | 1.55 | 10 | 10 | 0
 |  |  |  | Transceiver | Off | Low Power | 4 | QPLL | 5.0000 | 32 | 8b/10b | QPLL | 5.0000 | 32 | 8b/10b | 269 | No |  | 0.000 | 0.000 | 0.000 | 0.000 |  | 3 | 0 | 10000 | 10000 | 2500 | 2500 | 125 | 125 | 0 | 5.575 | 0 | 7.579332025 | 53.875 | 43.53733333 | 0 | 16.46694215 | 25.6 | 1.55 | 10 | 10 | 0
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
88
 |  |  |  |  |  |  |  |  |  |  |  |  |  |  |  |  |  |  |  |  |  |  |  |  | VCO MIN | 1.6
 |  |  |  |  |  |  |  |  |  |  |  |  |  |  |  |  |  |  |  |  |  |  |  |  | VCO MAX | 3.3
 |  |  |  |  |  |  |  |  |  |  |  |  | 0
 |  |  |  |  |  |  |  |  |  |  |  |  | 1
 |  |  |  |  |  |  |  |  |  |  |  |  | 2
 |  |  |  |  |  |  |  |  |  |  |  |  | 3
 |  |  |  |  |  |  |  |  |  |  | Power Planes | 1 | 4
 |  |  |  |  |  |  |  |  |  |  | Used Quad | 2 | 5 |  |  |  |  | FactorCol | 1
 |  |  |  |  |  |  |  |  |  |  | Used Pl | 1 | 6
 |  |  |  |  |  |  |  |  |  |  | Avg Quad | 2 | O111:O112
 |  |  |  |  |  |  |  |  |  |  | Quads |  | 2 | MMF |  | x^4 | x^3 | x^2 | x | c
 |  |  |  |  |  |  |  |  |  |  | AVCCQ | 0.002563933923 | 0.06132305353 | 1.595 |  | 7.55266329e-08 | 5.467265515e-06 | 0.0004180628965 | 0.02142175782 | 0.3702050912 | 0.215 | 4.8939 | 1
 |  |  |  |  |  |  |  |  |  |  | AVTTQ | 0.005066830505 | 0.00720337527 | 1 |  | 1.018212675e-08 | -1.672192001e-08 | 4.392168573e-06 | 0.0008287392698 | 2.499111411 | 2.0991 | -1.5161 | 1.00282
 |  |  |  |  |  |  |  |  |  |  | AUXQ | 1.335917016e-05 | 0.0007452186936 | 1 |  | 6.486095011e-09 | -2.849264878e-07 | -3.2614894e-06 | 0.0006093395067 | -0.004597126203
 |  |  |  |  |  |  |  |  |  |  |  |  | 0.0685264288 | 0.0713084975
 |  |  |  |  |  |  |  |  |  |  | BSCAN_AVTT | 0.35
 |  |  |  |  |  |  |  |  |  |  | BSCAN_AVCC | 0.151
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
