Jordan-HT/Capstone/Documentation/PCB/Material/JLC122551H-2116_Stackup_Plus_Spacings.png

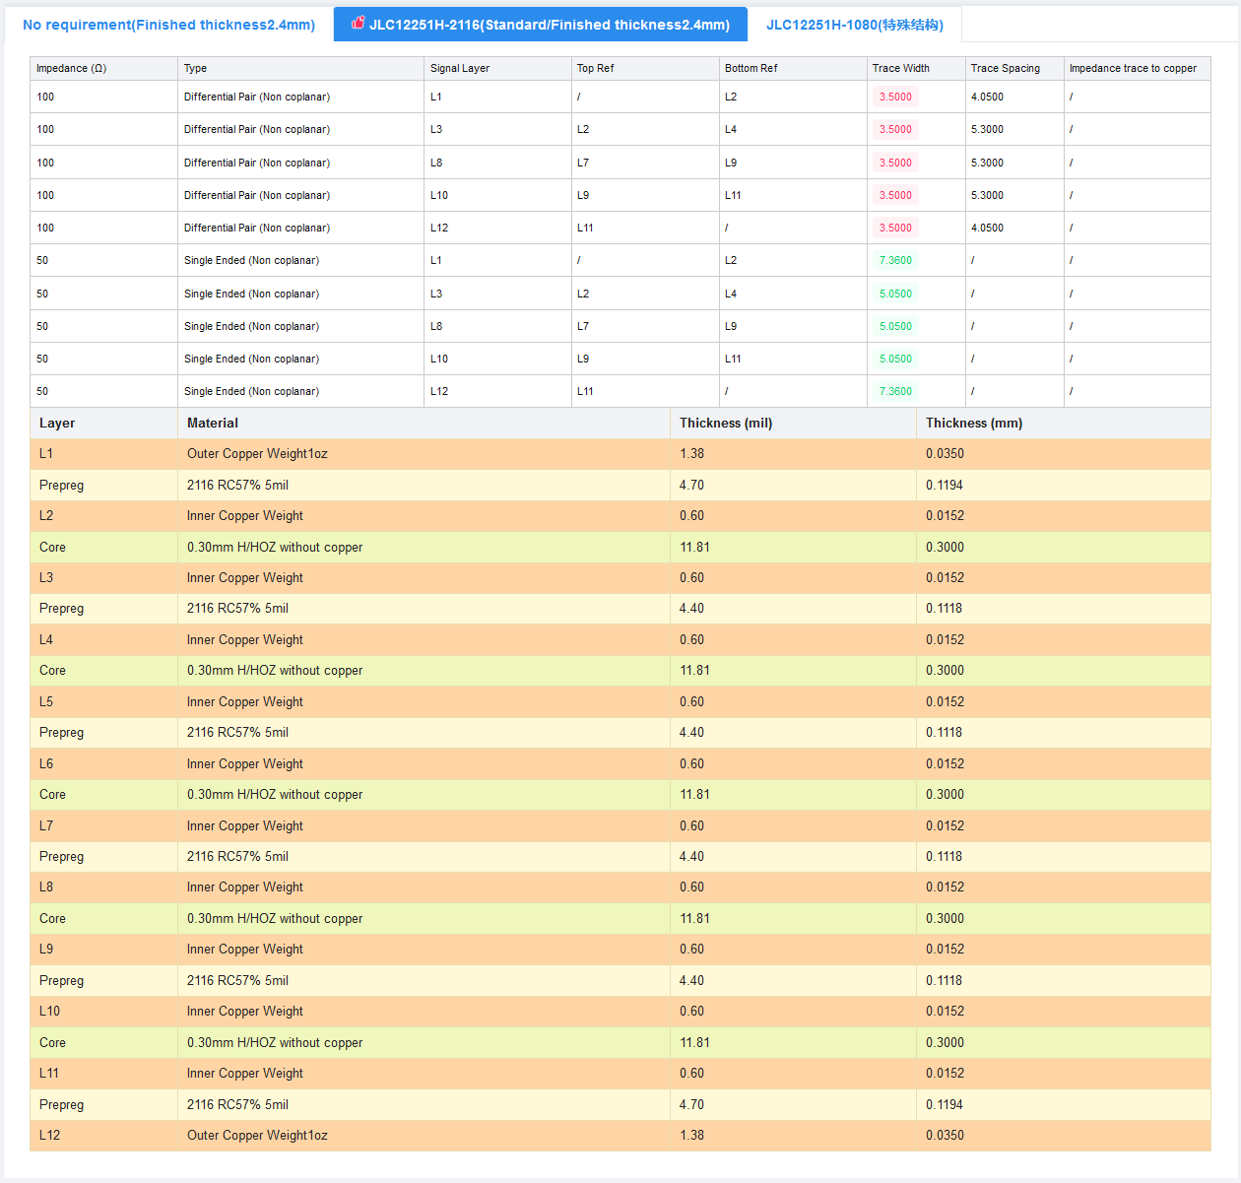
Documentation/PCB/Material/JLC122551H-2116_Stackup_Plus_Spacings.png
