Jordan-HT/Capstone/KiCad/Original_3D_Models/LOTES_ACA-SPI-006-K01_Outline.step

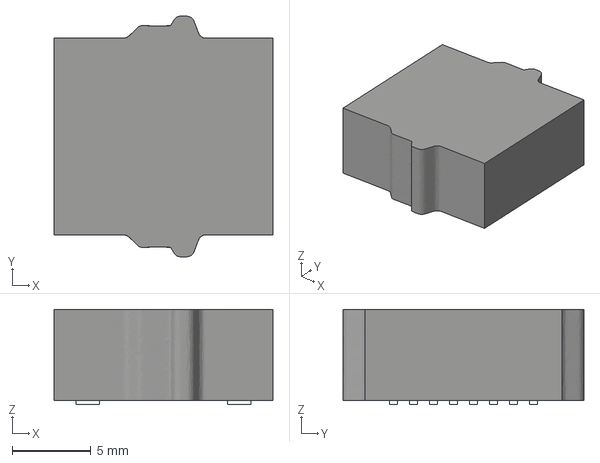
[picture p4: CAD file, 2023-12-19]
KiCad/Original_3D_Models/LOTES_ACA-SPI-006-K01_Outline.step
13.9 x 15.3 x 6.05 mm
