Jordan-HT/Capstone/KiCad/Part Imports/904-27-2-23-2-B-0/904-27-2-23-X-B-0.STEP

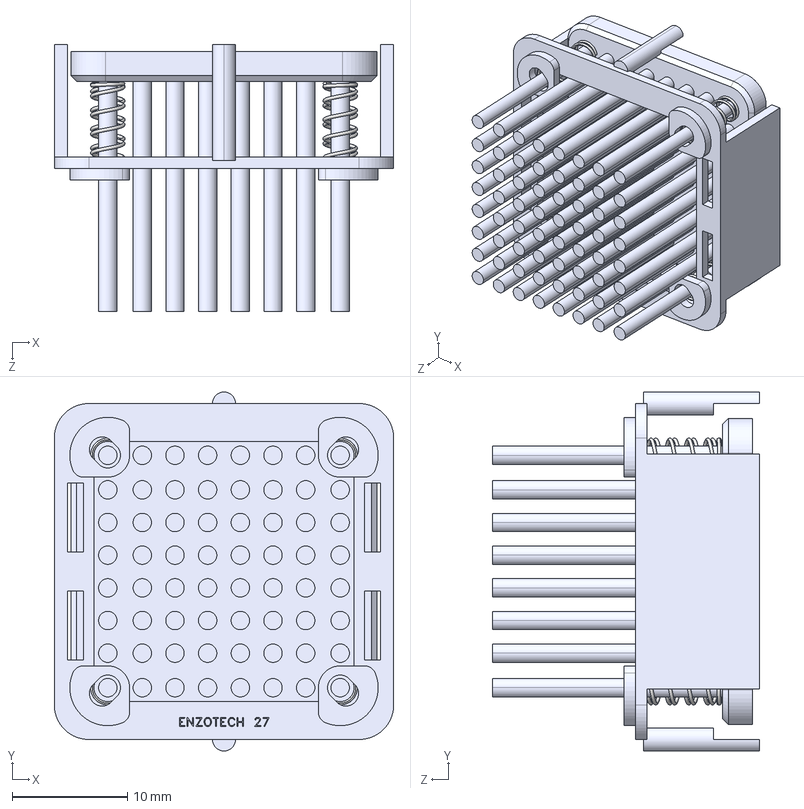
[picture p5: CAD file, 2023-12-28]
KiCad/Part Imports/904-27-2-23-2-B-0/904-27-2-23-X-B-0.STEP
29.5 x 31.2 x 23.2 mm
HS270_ROUND
9xx_spring x 4
27-no lip
