Jordan-HT/Capstone/KiCad/Part Imports/ACM1513-551-2PL-TLHF/acm1513.step

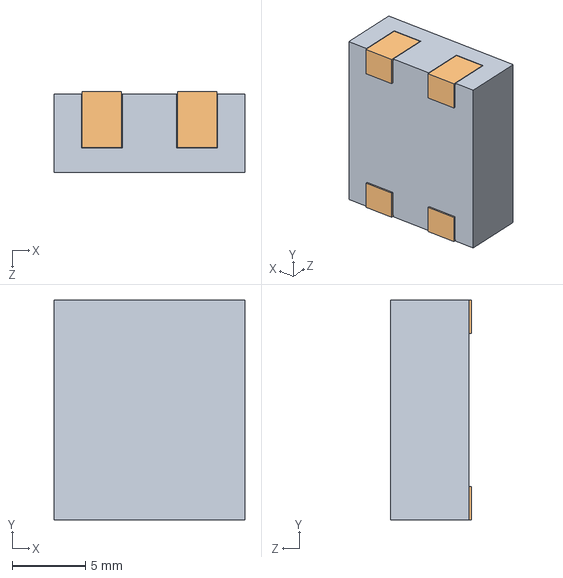
[picture p6: CAD file, 2023-12-19]
KiCad/Part Imports/ACM1513-551-2PL-TLHF/acm1513.step
13.0 x 15.0 x 5.50 mm
ACM1513 コアblock(typ size)
ACM1513 端子block(typ size) x 4
