Jordan-HT/Capstone/KiCad/Part Imports/AOTA-B252010SR47MT/AOTA-B252010SR47MT.stp

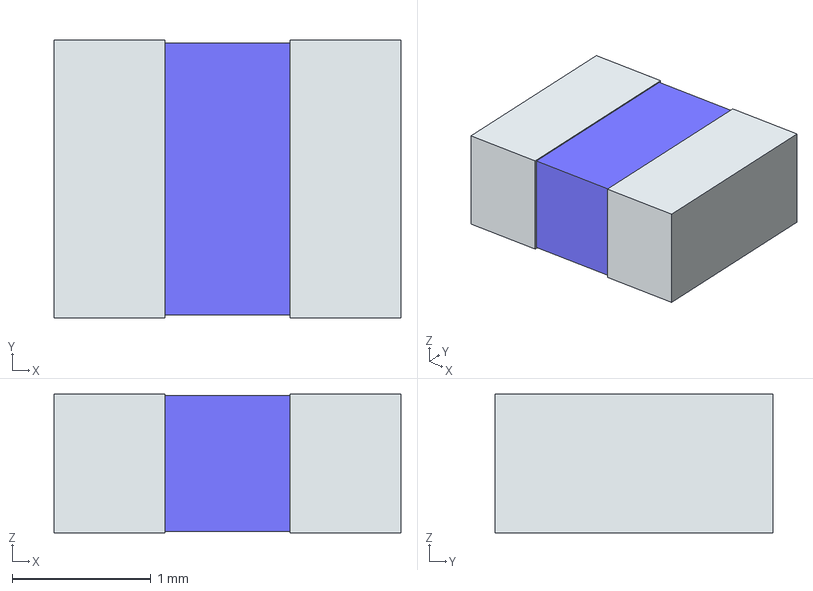
[picture p7: CAD file, 2023-12-19]
KiCad/Part Imports/AOTA-B252010SR47MT/AOTA-B252010SR47MT.stp
2.50 x 2.00 x 1.00 mm
term1
term2
