Jordan-HT/Capstone/KiCad/Part Imports/CLT32-R15/CLT32-R15.stp

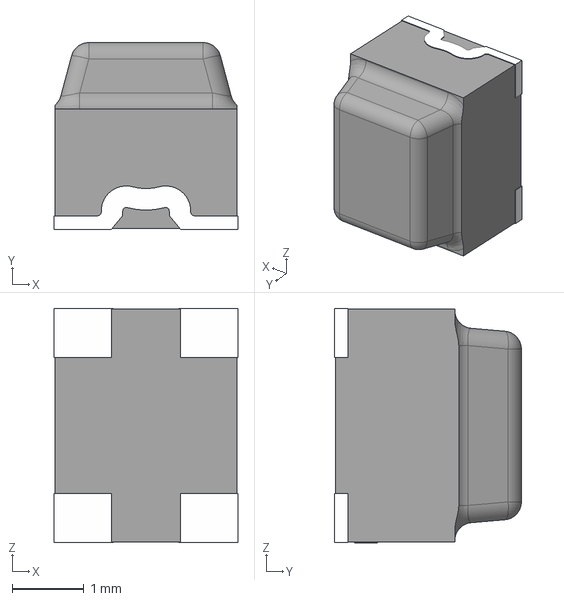
[picture p8: CAD file, 2023-12-19]
KiCad/Part Imports/CLT32-R15/CLT32-R15.stp
2.57 x 2.61 x 3.27 mm
