Jordan-HT/Capstone/KiCad/Part Imports/DS04-254-2-02BK-SMT/CUI_DEVICES_DS04-254-2-02BK-SMT.step

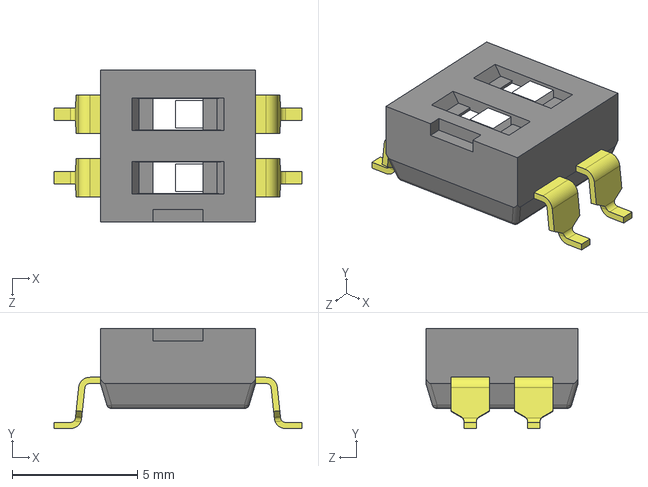
[picture p9: CAD file, 2023-12-19]
KiCad/Part Imports/DS04-254-2-02BK-SMT/CUI_DEVICES_DS04-254-2-02BK-SMT.step
9.90 x 4.00 x 6.08 mm
