Jordan-HT/Capstone/KiCad/Part Imports/DSC1123C/VDFN6_3P2X2P5_MCH.step

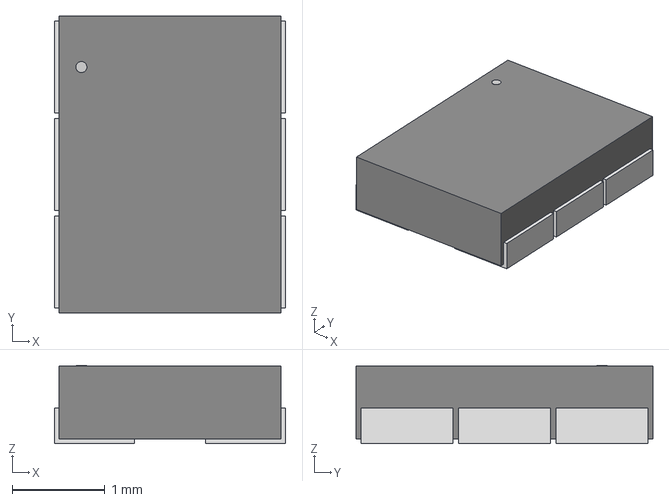
[picture p10: CAD file, 2023-12-28]
KiCad/Part Imports/DSC1123C/VDFN6_3P2X2P5_MCH.step
2.49 x 3.20 x 0.841 mm
