Jordan-HT/Capstone/KiCad/Part Imports/PCA9546ARGV/RGV0016A.stp

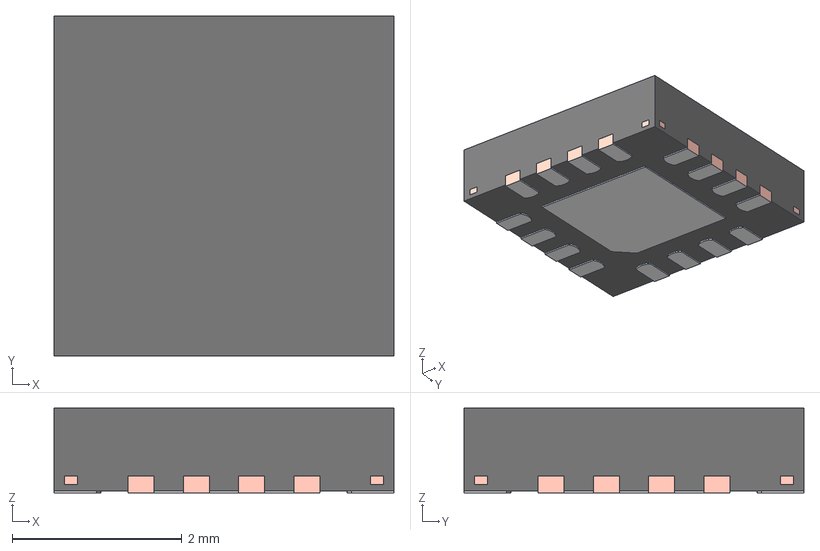
[picture p11: CAD file, 2023-12-28]
KiCad/Part Imports/PCA9546ARGV/RGV0016A.stp
4.00 x 4.00 x 1.00 mm
FRAME
PIN1_AREA
