Jordan-HT/Capstone/KiCad/Part Imports/PCA9548ABS,118/PCA9548ABS,118.stp

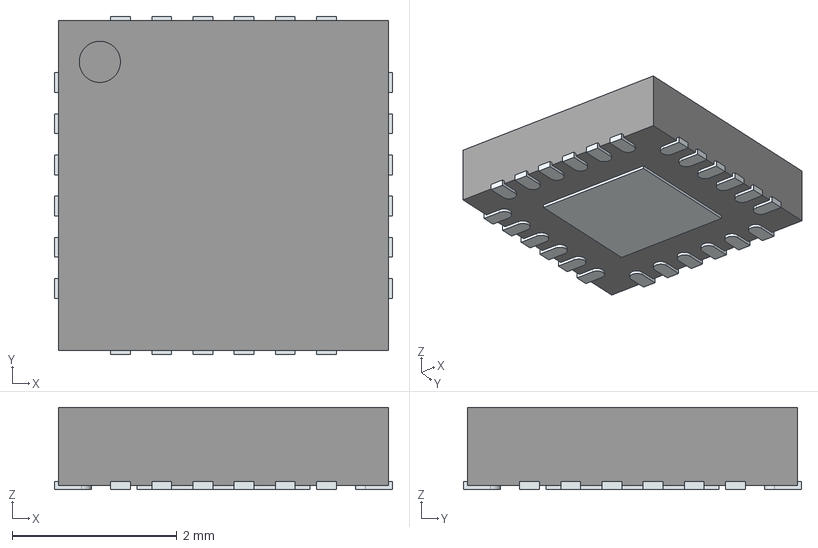
[picture p12: CAD file, 2023-12-28]
KiCad/Part Imports/PCA9548ABS,118/PCA9548ABS,118.stp
4.10 x 4.10 x 1.00 mm
ThermalPin
PinsArrayLR
PinsArrayTB
