Jordan-HT/Capstone/KiCad/Part Imports/PJ-082BH/PJ-082BH.stp

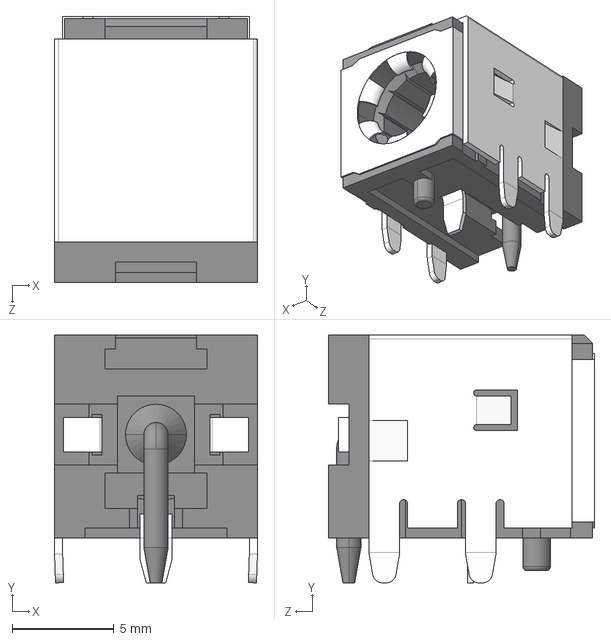
[picture p13: CAD file, 2023-12-19]
KiCad/Part Imports/PJ-082BH/PJ-082BH.stp
10.0 x 12.2 x 13.1 mm
