Jordan-HT/Capstone/KiCad/Part Imports/SN74AUP1G58DRLR/SN74AUP1G58DRLR.stp

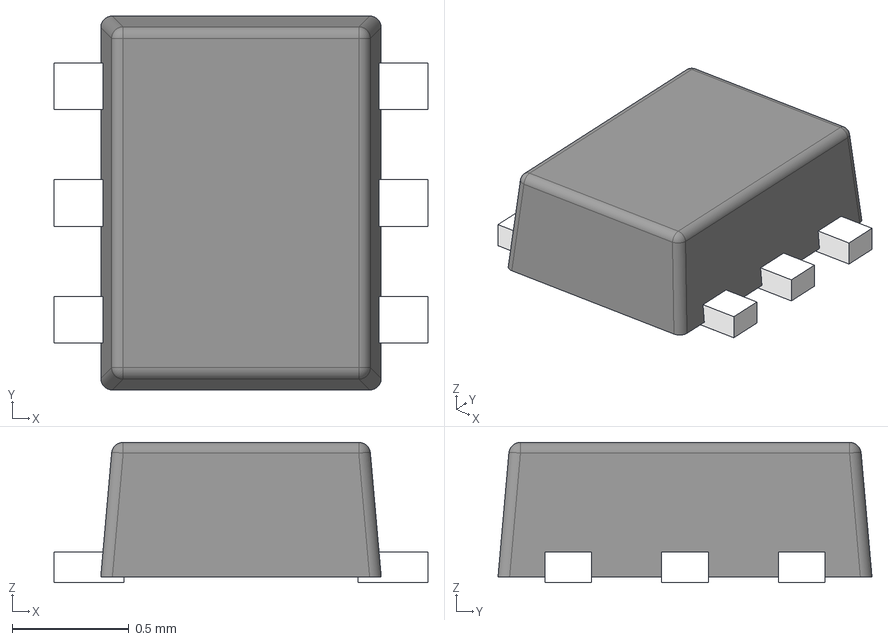
[picture p14: CAD file, 2023-12-19]
KiCad/Part Imports/SN74AUP1G58DRLR/SN74AUP1G58DRLR.stp
1.60 x 1.60 x 0.6 mm
FRAME-DRL0006A
BODY-SOT
PIN1-ID
