Jordan-HT/Capstone/KiCad/Part Imports/SN74LVC1G08DRLR/SN74LVC1G08DRLR.stp

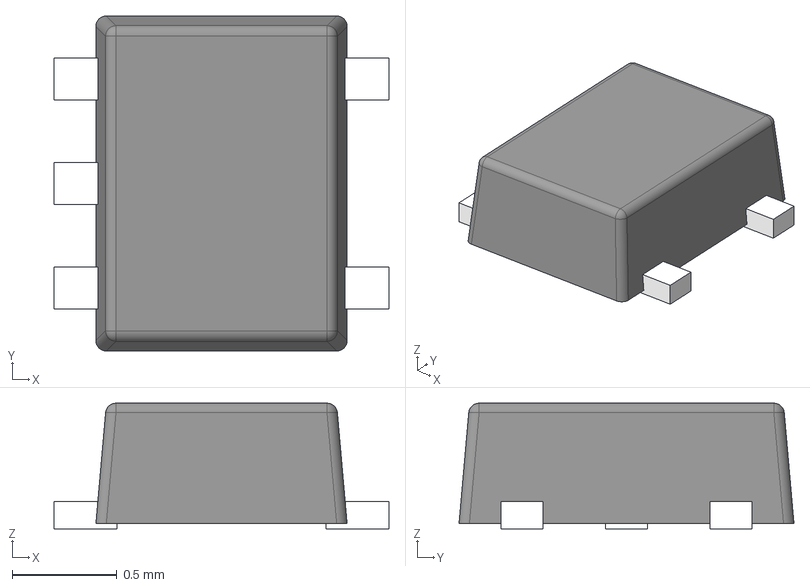
[picture p15: CAD file, 2023-12-19]
KiCad/Part Imports/SN74LVC1G08DRLR/SN74LVC1G08DRLR.stp
1.60 x 1.60 x 0.6 mm
FRAME-DRL0005A
BODY-SOT
PIN1-ID
