Jordan-HT/Capstone/KiCad/Part Imports/TPS62870QWRXSRQ1/RXS0016A.stp

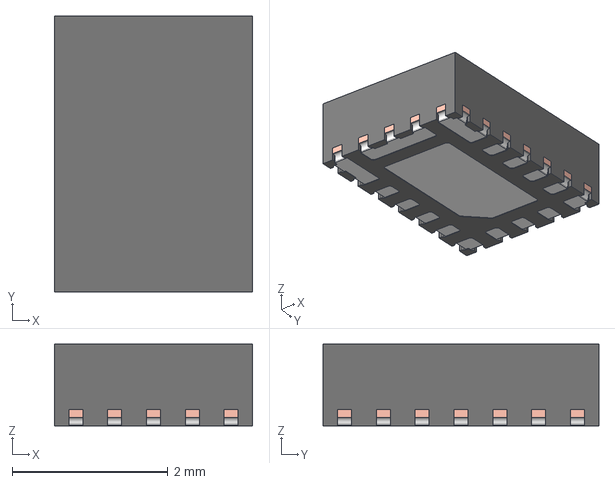
[picture p16: CAD file, 2023-12-19]
KiCad/Part Imports/TPS62870QWRXSRQ1/RXS0016A.stp
2.55 x 3.55 x 1.05 mm
MOLD
FRAME
