Jordan-HT/Capstone/KiCad/Part Imports/U95_T151_100A/U95T151100A.step

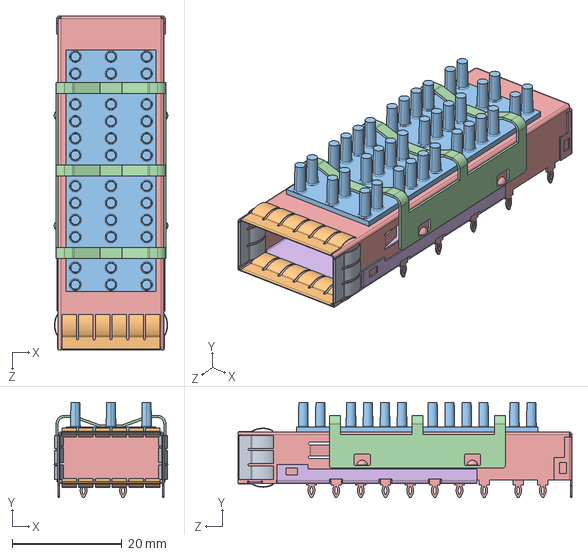
[picture p17: CAD file, 2023-12-24]
KiCad/Part Imports/U95_T151_100A/U95T151100A.step
20.8 x 17.4 x 60.9 mm
