Jordan-HT/Capstone/KiCad/Original_3D_Models/LOTES_ACA-SPI-004-K01_Outline.step

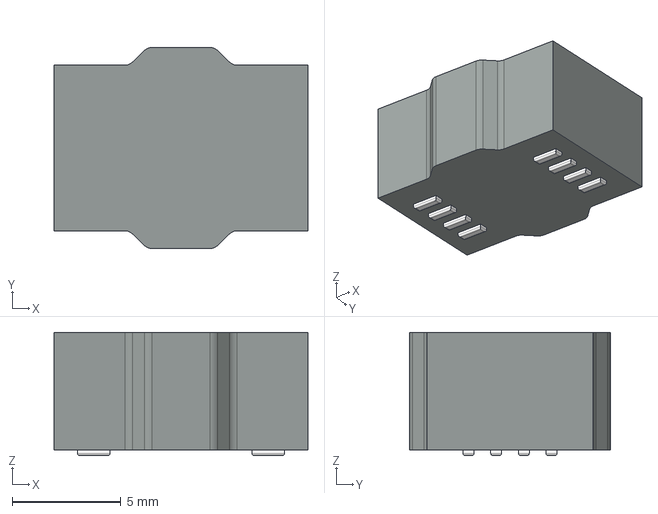
[picture p18: CAD file, 2023-12-19]
KiCad/Original_3D_Models/LOTES_ACA-SPI-004-K01_Outline.step
11.7 x 9.23 x 5.65 mm
