Jordan-HT/Capstone/KiCad/Part Imports/U95_T151_100A/M-FS1-Z38-X0Z6-60-REVT1.STEP

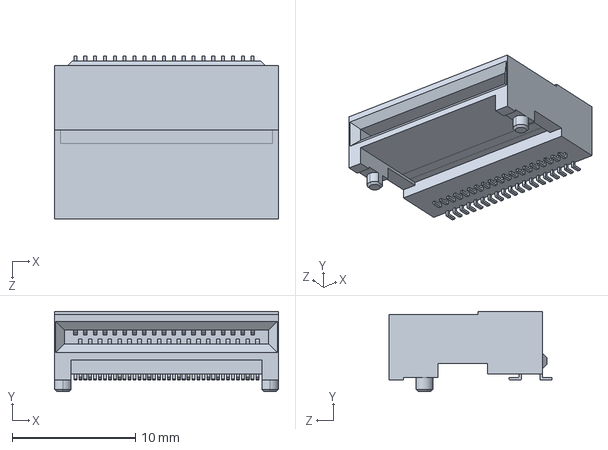
[picture p19: CAD file, 2023-12-24]
KiCad/Part Imports/U95_T151_100A/M-FS1-Z38-X0Z6-60-REVT1.STEP
18.2 x 6.54 x 13.3 mm
