Jordan-HT/Capstone/KiCad/Part Imports/01550900DR/01550900DR.stp

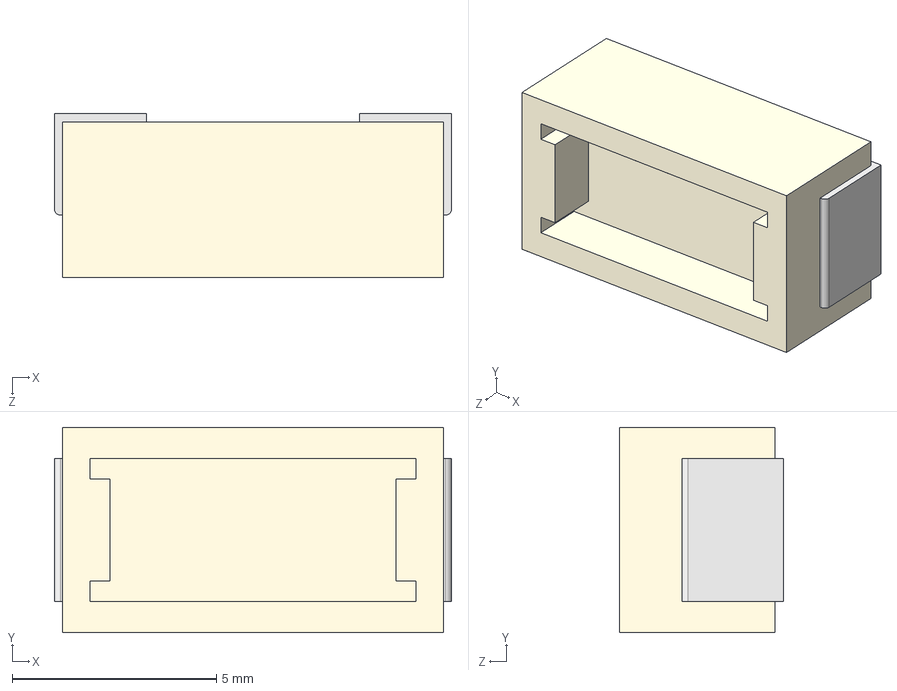
[picture p20: CAD file, 2023-12-19]
KiCad/Part Imports/01550900DR/01550900DR.stp
9.73 x 5.03 x 4.01 mm
