Jordan-HT/Capstone/KiCad/Part Imports/0878321420/878321420.stp

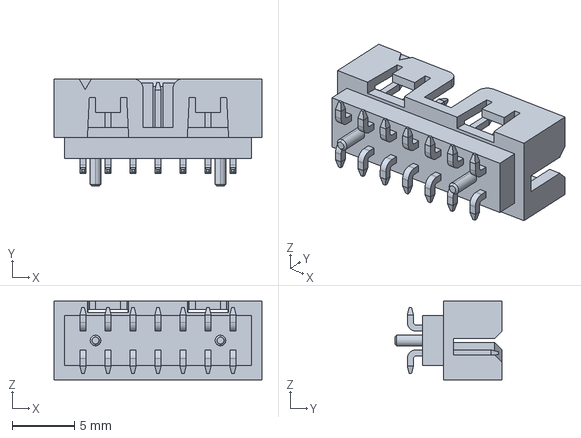
[picture p21: CAD file, 2023-12-28]
KiCad/Part Imports/0878321420/878321420.stp
16.6 x 8.60 x 6.30 mm
