Jordan-HT/Capstone/(list of files, cad)

Other CAD files:
KiCad (OLD)/Part Imports/01550900DR/0452007.MRL.stp
KiCad (OLD)/Part Imports/1935161/1935161.step
KiCad (OLD)/Part Imports/ECS_1612MV_120_CN_TR/ECS-1612MV-120-CN-TR.step
KiCad (OLD)/Part Imports/REF35125QDBVR/REF35125QDBVR.stp
KiCad (OLD)/Part Imports/SC0914_7_/AltiumDesigner/QFN56_7X7_RPI.step
KiCad (OLD)/Part Imports/SC0914_7_/QFN56_7X7_RPI.step
KiCad (OLD)/Part Imports/TMP1075NDRLR/AltiumDesigner/SOT5X3-6_DRL_TEX.step
KiCad (OLD)/Part Imports/TPS628502DRLR/TPS628502DRLR.stp
KiCad (OLD)/Part Imports/TPS74801DRCR/TPS74801DRCR.stp
KiCad/Part Imports/01550900DR/0452007.MRL.stp
KiCad/Part Imports/1935161/1935161.step
KiCad/Part Imports/REF35125QDBVR/REF35125QDBVR.stp
KiCad/Part Imports/TPS628502DRLR/TPS628502DRLR.stp
KiCad/Part Imports/TPS74801DRCR/TPS74801DRCR.stp
