Jordan-HT/Capstone/Misc/FFG676 Footprint Modification/Result.txt

  (pad "A1" smd circle (at -12.5 -12.5) (size 0.53 0.53) (layers "F.Cu" "F.Paste" "F.Mask") (die_length 0.0) (tstamp 2ec909b2-3b6b-4188-b176-8ae982523c82))
  (pad "A2" smd circle (at -11.5 -12.5) (size 0.53 0.53) (layers "F.Cu" "F.Paste" "F.Mask") (die_length 0.0) (tstamp b83fe412-54ee-42d4-a6e1-e731dfe482e7))
  (pad "A3" smd circle (at -10.5 -12.5) (size 0.53 0.53) (layers "F.Cu" "F.Paste" "F.Mask") (die_length 14.74356634) (tstamp a53b739d-04c5-4ba1-936e-1c22884ff16d))
  (pad "A4" smd circle (at -9.5 -12.5) (size 0.53 0.53) (layers "F.Cu" "F.Paste" "F.Mask") (die_length 14.69383099) (tstamp e0e50a03-b7c4-413e-b8c7-9503afbbba9c))
  (pad "A5" smd circle (at -8.5 -12.5) (size 0.53 0.53) (layers "F.Cu" "F.Paste" "F.Mask") (die_length 0.0) (tstamp 162d494a-9cbc-4760-aba8-efabe92e6290))
  (pad "A6" smd circle (at -7.5 -12.5) (size 0.53 0.53) (layers "F.Cu" "F.Paste" "F.Mask") (die_length 0.0) (tstamp 2bf794bf-2169-451c-9e2c-87fc49699390))
  (pad "A7" smd circle (at -6.5 -12.5) (size 0.53 0.53) (layers "F.Cu" "F.Paste" "F.Mask") (die_length 0.0) (tstamp 18bd72e8-35ca-4c53-80e2-b71645fb3319))
  (pad "A8" smd circle (at -5.5 -12.5) (size 0.53 0.53) (layers "F.Cu" "F.Paste" "F.Mask") (die_length 20.77310336) (tstamp 4eed5812-5626-4b96-a54b-84136bc7f899))
  (pad "A9" smd circle (at -4.5 -12.5) (size 0.53 0.53) (layers "F.Cu" "F.Paste" "F.Mask") (die_length 20.2660157) (tstamp 40c441d5-d19d-47c2-bac0-c76846cecd42))
  (pad "A10" smd circle (at -3.5 -12.5) (size 0.53 0.53) (layers "F.Cu" "F.Paste" "F.Mask") (die_length 21.45023423) (tstamp 679ddefe-d243-4279-99ae-a386cb04def3))
  (pad "A11" smd circle (at -2.5 -12.5) (size 0.53 0.53) (layers "F.Cu" "F.Paste" "F.Mask") (die_length 0.0) (tstamp f805c893-a257-482c-b777-90636bf90880))
  (pad "A12" smd circle (at -1.5 -12.5) (size 0.53 0.53) (layers "F.Cu" "F.Paste" "F.Mask") (die_length 25.58937154) (tstamp af8cd8fa-c89d-469e-b39f-dbef5d86723c))
  (pad "A13" smd circle (at -0.5 -12.5) (size 0.53 0.53) (layers "F.Cu" "F.Paste" "F.Mask") (die_length 25.11574497) (tstamp a6f25097-5f26-4d26-81e2-5115f77bc436))
  (pad "A14" smd circle (at 0.5 -12.5) (size 0.53 0.53) (layers "F.Cu" "F.Paste" "F.Mask") (die_length 20.39651396) (tstamp b3865266-42e6-41b9-8ed3-408878eec05c))
  (pad "A15" smd circle (at 1.5 -12.5) (size 0.53 0.53) (layers "F.Cu" "F.Paste" "F.Mask") (die_length 19.99193892) (tstamp b4d76283-9ad7-4589-8773-6f7a626f2cdc))
  (pad "A16" smd circle (at 2.5 -12.5) (size 0.53 0.53) (layers "F.Cu" "F.Paste" "F.Mask") (die_length 0.0) (tstamp 2291a7c3-f3e2-4a7a-9f5c-970db5fcee87))
  (pad "A17" smd circle (at 3.5 -12.5) (size 0.53 0.53) (layers "F.Cu" "F.Paste" "F.Mask") (die_length 19.34887753) (tstamp e0bdbe3c-5783-41d2-bbca-8cfecef4f567))
  (pad "A18" smd circle (at 4.5 -12.5) (size 0.53 0.53) (layers "F.Cu" "F.Paste" "F.Mask") (die_length 20.93584596) (tstamp 06eb6661-a929-4347-8796-987c12d2cc1e))
  (pad "A19" smd circle (at 5.5 -12.5) (size 0.53 0.53) (layers "F.Cu" "F.Paste" "F.Mask") (die_length 20.32578938) (tstamp a285adb3-e8d2-4bf1-a81c-15079a7a9827))
  (pad "A20" smd circle (at 6.5 -12.5) (size 0.53 0.53) (layers "F.Cu" "F.Paste" "F.Mask") (die_length 23.47341364) (tstamp c0121180-23f0-4e50-8f5e-57385585b9f0))
  (pad "A21" smd circle (at 7.5 -12.5) (size 0.53 0.53) (layers "F.Cu" "F.Paste" "F.Mask") (die_length 0.0) (tstamp c63ab9f8-f0c8-4c7d-9620-2a2ab4ad4581))
  (pad "A22" smd circle (at 8.5 -12.5) (size 0.53 0.53) (layers "F.Cu" "F.Paste" "F.Mask") (die_length 25.51651761) (tstamp 382a2dab-b27d-40f9-8ad7-6f25fbadc5b2))
  (pad "A23" smd circle (at 9.5 -12.5) (size 0.53 0.53) (layers "F.Cu" "F.Paste" "F.Mask") (die_length 26.74621281) (tstamp 5cd63ddb-360e-4de6-9862-2ec305c3a072))
  (pad "A24" smd circle (at 10.5 -12.5) (size 0.53 0.53) (layers "F.Cu" "F.Paste" "F.Mask") (die_length 28.64984486) (tstamp ba00a6eb-81aa-46da-b10b-a39ae7cc4da8))
  (pad "A25" smd circle (at 11.5 -12.5) (size 0.53 0.53) (layers "F.Cu" "F.Paste" "F.Mask") (die_length 29.26765833) (tstamp 21adb6aa-6e0f-44b2-91a4-fc0317c5d53b))
  (pad "A26" smd circle (at 12.5 -12.5) (size 0.53 0.53) (layers "F.Cu" "F.Paste" "F.Mask") (die_length 0.0) (tstamp b500dd2e-c905-421e-95aa-2beb93ed5021))
  (pad "AA1" smd circle (at -12.5 7.5) (size 0.53 0.53) (layers "F.Cu" "F.Paste" "F.Mask") (die_length 0.0) (tstamp dde98c24-aee5-4624-98a5-12173a49cd6b))
  (pad "AA2" smd circle (at -11.5 7.5) (size 0.53 0.53) (layers "F.Cu" "F.Paste" "F.Mask") (die_length 20.32259536) (tstamp 49405b05-6188-4fa1-89d4-2e607d1673c8))
  (pad "AA3" smd circle (at -10.5 7.5) (size 0.53 0.53) (layers "F.Cu" "F.Paste" "F.Mask") (die_length 20.93751901) (tstamp 7e40f5a4-463c-4e39-a78f-b1d59719e007))
  (pad "AA4" smd circle (at -9.5 7.5) (size 0.53 0.53) (layers "F.Cu" "F.Paste" "F.Mask") (die_length 19.11906066) (tstamp 7ff7ad0b-cb55-49a4-94a9-330709ef8dda))
  (pad "AA5" smd circle (at -8.5 7.5) (size 0.53 0.53) (layers "F.Cu" "F.Paste" "F.Mask") (die_length 19.3573949) (tstamp 69d22385-338c-40c7-a108-efa736430ef4))
  (pad "AA6" smd circle (at -7.5 7.5) (size 0.53 0.53) (layers "F.Cu" "F.Paste" "F.Mask") (die_length 0.0) (tstamp 1a4fa1d0-1e0a-4b4a-bdc2-b8a809a1d1b9))
  (pad "AA7" smd circle (at -6.5 7.5) (size 0.53 0.53) (layers "F.Cu" "F.Paste" "F.Mask") (die_length 17.44996046) (tstamp 3fa6f62f-68ac-4aa4-929a-6732c9799652))
  (pad "AA8" smd circle (at -5.5 7.5) (size 0.53 0.53) (layers "F.Cu" "F.Paste" "F.Mask") (die_length 17.16493277) (tstamp e68f677a-6903-47fa-8e6c-d551b44d2314))
  (pad "AA9" smd circle (at -4.5 7.5) (size 0.53 0.53) (layers "F.Cu" "F.Paste" "F.Mask") (die_length 17.45634848) (tstamp 902b433e-b4f4-41ab-ba08-ba9e3dff6f3e))
  (pad "AA10" smd circle (at -3.5 7.5) (size 0.53 0.53) (layers "F.Cu" "F.Paste" "F.Mask") (die_length 23.01606133) (tstamp a7d0eb24-90c0-4654-8d2e-c0bbdd0cb2ae))
  (pad "AA11" smd circle (at -2.5 7.5) (size 0.53 0.53) (layers "F.Cu" "F.Paste" "F.Mask") (die_length 0.0) (tstamp a85039d3-e7aa-43e6-8499-435c0588ada7))
  (pad "AA12" smd circle (at -1.5 7.5) (size 0.53 0.53) (layers "F.Cu" "F.Paste" "F.Mask") (die_length 22.73088155) (tstamp dfc8f4ef-4b1b-434e-8827-b7c94f73a7c5))
  (pad "AA13" smd circle (at -0.5 7.5) (size 0.53 0.53) (layers "F.Cu" "F.Paste" "F.Mask") (die_length 22.71384681) (tstamp 84e0e528-d057-43cb-9617-cf94188b7a37))
  (pad "AA14" smd circle (at 0.5 7.5) (size 0.53 0.53) (layers "F.Cu" "F.Paste" "F.Mask") (die_length 15.45552716) (tstamp 0357a569-f253-4604-9312-4d953f77b10f))
  (pad "AA15" smd circle (at 1.5 7.5) (size 0.53 0.53) (layers "F.Cu" "F.Paste" "F.Mask") (die_length 15.3691367) (tstamp f4ec11d7-e1df-4232-b51a-9982298ee08f))
  (pad "AA16" smd circle (at 2.5 7.5) (size 0.53 0.53) (layers "F.Cu" "F.Paste" "F.Mask") (die_length 0.0) (tstamp e1ab4abf-39e3-4449-9f36-cc348301276d))
  (pad "AA17" smd circle (at 3.5 7.5) (size 0.53 0.53) (layers "F.Cu" "F.Paste" "F.Mask") (die_length 16.79959847) (tstamp 312a3e19-b227-4302-82f1-cf5af520e0f6))
  (pad "AA18" smd circle (at 4.5 7.5) (size 0.53 0.53) (layers "F.Cu" "F.Paste" "F.Mask") (die_length 16.78149906) (tstamp 88b8fbea-e61c-4610-8f9b-ccc48b05b251))
  (pad "AA19" smd circle (at 5.5 7.5) (size 0.53 0.53) (layers "F.Cu" "F.Paste" "F.Mask") (die_length 19.41960212) (tstamp c8096848-a19a-44db-a914-e28811e641b5))
  (pad "AA20" smd circle (at 6.5 7.5) (size 0.53 0.53) (layers "F.Cu" "F.Paste" "F.Mask") (die_length 21.4662043) (tstamp a70a802f-b269-4bd7-a3c5-078488ecf797))
  (pad "AA21" smd circle (at 7.5 7.5) (size 0.53 0.53) (layers "F.Cu" "F.Paste" "F.Mask") (die_length 0.0) (tstamp 15b083b9-23fc-4c92-8f68-6ce488b14019))
  (pad "AA22" smd circle (at 8.5 7.5) (size 0.53 0.53) (layers "F.Cu" "F.Paste" "F.Mask") (die_length 12.15497049) (tstamp b6c681a3-8aba-4d42-89d3-386fc3bf4c07))
  (pad "AA23" smd circle (at 9.5 7.5) (size 0.53 0.53) (layers "F.Cu" "F.Paste" "F.Mask") (die_length 17.2894993) (tstamp ce3168c0-d992-479e-8e9f-0a52a8940d9c))
  (pad "AA24" smd circle (at 10.5 7.5) (size 0.53 0.53) (layers "F.Cu" "F.Paste" "F.Mask") (die_length 14.91155625) (tstamp 073f8901-14b6-40b5-bedf-339221232362))
  (pad "AA25" smd circle (at 11.5 7.5) (size 0.53 0.53) (layers "F.Cu" "F.Paste" "F.Mask") (die_length 17.07823812) (tstamp ce0f8f0a-abdf-439c-9875-f266bc6cb9d0))
  (pad "AA26" smd circle (at 12.5 7.5) (size 0.53 0.53) (layers "F.Cu" "F.Paste" "F.Mask") (die_length 0.0) (tstamp e7aed12a-f0dc-410a-8338-312b254e0771))
  (pad "AB1" smd circle (at -12.5 8.5) (size 0.53 0.53) (layers "F.Cu" "F.Paste" "F.Mask") (die_length 23.32922674) (tstamp 13fbd975-9d6e-4bcf-9d3f-596cd40e8d5d))
  (pad "AB2" smd circle (at -11.5 8.5) (size 0.53 0.53) (layers "F.Cu" "F.Paste" "F.Mask") (die_length 22.75795461) (tstamp c27c3bec-e46c-4b60-a3da-a8289d5f393a))
  (pad "AB3" smd circle (at -10.5 8.5) (size 0.53 0.53) (layers "F.Cu" "F.Paste" "F.Mask") (die_length 0.0) (tstamp 4c850946-31fc-4656-b2b3-45cbd8f0bc05))
  (pad "AB4" smd circle (at -9.5 8.5) (size 0.53 0.53) (layers "F.Cu" "F.Paste" "F.Mask") (die_length 19.58508244) (tstamp 5dab4999-d73f-4767-98bf-2b591d464a79))
  (pad "AB5" smd circle (at -8.5 8.5) (size 0.53 0.53) (layers "F.Cu" "F.Paste" "F.Mask") (die_length 19.39100809) (tstamp d57a4f85-fe34-4c25-9a59-9f57bc63ea61))
  (pad "AB6" smd circle (at -7.5 8.5) (size 0.53 0.53) (layers "F.Cu" "F.Paste" "F.Mask") (die_length 18.592961) (tstamp 9bb8e747-842a-4dce-a43a-8331970101fd))
  (pad "AB7" smd circle (at -6.5 8.5) (size 0.53 0.53) (layers "F.Cu" "F.Paste" "F.Mask") (die_length 15.71500274) (tstamp f8a2d120-dc4a-415c-be53-b08429ba0914))
  (pad "AB8" smd circle (at -5.5 8.5) (size 0.53 0.53) (layers "F.Cu" "F.Paste" "F.Mask") (die_length 0.0) (tstamp 5cdce8cb-f63e-4762-bb9f-8177c02497c3))
  (pad "AB9" smd circle (at -4.5 8.5) (size 0.53 0.53) (layers "F.Cu" "F.Paste" "F.Mask") (die_length 17.44387662) (tstamp 47f57d4a-5a88-44ae-8adc-adfea413363c))
  (pad "AB10" smd circle (at -3.5 8.5) (size 0.53 0.53) (layers "F.Cu" "F.Paste" "F.Mask") (die_length 22.74350551) (tstamp 6c3461a4-3841-4716-840d-ef9e95f9ea50))
  (pad "AB11" smd circle (at -2.5 8.5) (size 0.53 0.53) (layers "F.Cu" "F.Paste" "F.Mask") (die_length 22.64160127) (tstamp f7802fa3-e56f-4010-846e-6ce64250c3a9))
  (pad "AB12" smd circle (at -1.5 8.5) (size 0.53 0.53) (layers "F.Cu" "F.Paste" "F.Mask") (die_length 24.37701527) (tstamp 25605122-9c62-4805-b221-71fbdf3ab764))
  (pad "AB13" smd circle (at -0.5 8.5) (size 0.53 0.53) (layers "F.Cu" "F.Paste" "F.Mask") (die_length 0.0) (tstamp 6bc6c485-c31b-466b-aeee-868482690299))
  (pad "AB14" smd circle (at 0.5 8.5) (size 0.53 0.53) (layers "F.Cu" "F.Paste" "F.Mask") (die_length 16.86956257) (tstamp 9a6975c9-ca49-4c19-ba2e-d8b864d538a3))
  (pad "AB15" smd circle (at 1.5 8.5) (size 0.53 0.53) (layers "F.Cu" "F.Paste" "F.Mask") (die_length 19.10871814) (tstamp 128268e7-e4cb-4e35-b232-272c3dd49d78))
  (pad "AB16" smd circle (at 2.5 8.5) (size 0.53 0.53) (layers "F.Cu" "F.Paste" "F.Mask") (die_length 22.28554481) (tstamp e597ee1a-d33d-476a-b3cd-9206e427cd2b))
  (pad "AB17" smd circle (at 3.5 8.5) (size 0.53 0.53) (layers "F.Cu" "F.Paste" "F.Mask") (die_length 18.40223277) (tstamp 22809ed4-22a5-4631-8896-8f12b07b3b6f))
  (pad "AB18" smd circle (at 4.5 8.5) (size 0.53 0.53) (layers "F.Cu" "F.Paste" "F.Mask") (die_length 0.0) (tstamp 11291f18-ad24-4aa0-98e3-c213e39333eb))
  (pad "AB19" smd circle (at 5.5 8.5) (size 0.53 0.53) (layers "F.Cu" "F.Paste" "F.Mask") (die_length 21.13676462) (tstamp 5a1bb1f1-27b3-4dc5-bd76-34b2f95f5480))
  (pad "AB20" smd circle (at 6.5 8.5) (size 0.53 0.53) (layers "F.Cu" "F.Paste" "F.Mask") (die_length 22.73605281) (tstamp 4edd0284-b23f-4232-8a67-855a02dad384))
  (pad "AB21" smd circle (at 7.5 8.5) (size 0.53 0.53) (layers "F.Cu" "F.Paste" "F.Mask") (die_length 12.3448622) (tstamp f86903ae-b6cf-4da5-b322-7eed8324bd76))
  (pad "AB22" smd circle (at 8.5 8.5) (size 0.53 0.53) (layers "F.Cu" "F.Paste" "F.Mask") (die_length 12.83263369) (tstamp 65b2362d-bf81-433a-a5a7-c51d1e479bb6))
  (pad "AB23" smd circle (at 9.5 8.5) (size 0.53 0.53) (layers "F.Cu" "F.Paste" "F.Mask") (die_length 0.0) (tstamp 326ca3f6-c43b-46c8-80d9-deb2c147d6de))
  (pad "AB24" smd circle (at 10.5 8.5) (size 0.53 0.53) (layers "F.Cu" "F.Paste" "F.Mask") (die_length 17.78700493) (tstamp a80e90b1-cc75-40fc-83af-ab462342bdc8))
  (pad "AB25" smd circle (at 11.5 8.5) (size 0.53 0.53) (layers "F.Cu" "F.Paste" "F.Mask") (die_length 18.35249741) (tstamp 1d317911-2495-414c-a97e-b7c863373c29))
  (pad "AB26" smd circle (at 12.5 8.5) (size 0.53 0.53) (layers "F.Cu" "F.Paste" "F.Mask") (die_length 19.4979315) (tstamp e395287e-a210-471d-bc01-4b3269e7a41d))
  (pad "AC1" smd circle (at -12.5 9.5) (size 0.53 0.53) (layers "F.Cu" "F.Paste" "F.Mask") (die_length 23.81121859) (tstamp 6724778b-1580-4f44-bb22-1311dcb8ca81))
  (pad "AC2" smd circle (at -11.5 9.5) (size 0.53 0.53) (layers "F.Cu" "F.Paste" "F.Mask") (die_length 23.00404575) (tstamp 05165840-c52d-4196-8a2b-a8113b9169d8))
  (pad "AC3" smd circle (at -10.5 9.5) (size 0.53 0.53) (layers "F.Cu" "F.Paste" "F.Mask") (die_length 22.09131837) (tstamp dcdebda5-d6b7-4943-8cf7-72a9c57b0f8e))
  (pad "AC4" smd circle (at -9.5 9.5) (size 0.53 0.53) (layers "F.Cu" "F.Paste" "F.Mask") (die_length 21.51320192) (tstamp 023c474f-a6b5-4059-a27e-dda07efe34f0))
  (pad "AC5" smd circle (at -8.5 9.5) (size 0.53 0.53) (layers "F.Cu" "F.Paste" "F.Mask") (die_length 0.0) (tstamp 87feef7e-4554-4781-8281-cddfce3a2283))
  (pad "AC6" smd circle (at -7.5 9.5) (size 0.53 0.53) (layers "F.Cu" "F.Paste" "F.Mask") (die_length 19.44165602) (tstamp 3ed9d28e-f48b-4fcd-ab0d-5a475e961374))
  (pad "AC7" smd circle (at -6.5 9.5) (size 0.53 0.53) (layers "F.Cu" "F.Paste" "F.Mask") (die_length 18.0799416) (tstamp 066db69a-ba8f-43df-bc0e-662f880fb231))
  (pad "AC8" smd circle (at -5.5 9.5) (size 0.53 0.53) (layers "F.Cu" "F.Paste" "F.Mask") (die_length 19.34203322) (tstamp 999d5be7-a748-4089-9263-f973f01d9b4a))
  (pad "AC9" smd circle (at -4.5 9.5) (size 0.53 0.53) (layers "F.Cu" "F.Paste" "F.Mask") (die_length 19.52561295) (tstamp 2cf90fc4-a607-4b57-b284-e122cc1f0b06))
  (pad "AC10" smd circle (at -3.5 9.5) (size 0.53 0.53) (layers "F.Cu" "F.Paste" "F.Mask") (die_length 0.0) (tstamp ffeed9c8-cf63-4ad2-9d55-197c1eade1a8))
  (pad "AC11" smd circle (at -2.5 9.5) (size 0.53 0.53) (layers "F.Cu" "F.Paste" "F.Mask") (die_length 22.88830078) (tstamp 47089dbb-59cd-4733-8c62-371d8737aa25))
  (pad "AC12" smd circle (at -1.5 9.5) (size 0.53 0.53) (layers "F.Cu" "F.Paste" "F.Mask") (die_length 24.41306199) (tstamp 64a29a7a-90dd-4b4d-80be-c2e65b9af298))
  (pad "AC13" smd circle (at -0.5 9.5) (size 0.53 0.53) (layers "F.Cu" "F.Paste" "F.Mask") (die_length 29.65611121) (tstamp c42be99a-6041-4487-8d82-3c659036e9f1))
  (pad "AC14" smd circle (at 0.5 9.5) (size 0.53 0.53) (layers "F.Cu" "F.Paste" "F.Mask") (die_length 17.34212448) (tstamp 5e5a1e0c-8d04-4173-847f-9004a15e43b9))
  (pad "AC15" smd circle (at 1.5 9.5) (size 0.53 0.53) (layers "F.Cu" "F.Paste" "F.Mask") (die_length 0.0) (tstamp fab4dd94-c2e4-4db5-aa01-1056ba729095))
  (pad "AC16" smd circle (at 2.5 9.5) (size 0.53 0.53) (layers "F.Cu" "F.Paste" "F.Mask") (die_length 21.77860924) (tstamp a16b6475-14e1-4d3e-8a3a-f3ef8463efff))
  (pad "AC17" smd circle (at 3.5 9.5) (size 0.53 0.53) (layers "F.Cu" "F.Paste" "F.Mask") (die_length 18.61501491) (tstamp 657375d3-c229-46b3-aa77-a2c26c6c8008))
  (pad "AC18" smd circle (at 4.5 9.5) (size 0.53 0.53) (layers "F.Cu" "F.Paste" "F.Mask") (die_length 22.12979863) (tstamp 086bf96a-2f32-41eb-ad17-c132d2e3c0f0))
  (pad "AC19" smd circle (at 5.5 9.5) (size 0.53 0.53) (layers "F.Cu" "F.Paste" "F.Mask") (die_length 22.8545355) (tstamp d4c15884-bac8-4b40-85d0-513128685601))
  (pad "AC20" smd circle (at 6.5 9.5) (size 0.53 0.53) (layers "F.Cu" "F.Paste" "F.Mask") (die_length 0.0) (tstamp 6318e387-d61a-4bd7-b87e-c1ecc107cfd3))
  (pad "AC21" smd circle (at 7.5 9.5) (size 0.53 0.53) (layers "F.Cu" "F.Paste" "F.Mask") (die_length 12.02333151) (tstamp 5d245cb7-c70d-44f8-acb1-c37def85b88e))
  (pad "AC22" smd circle (at 8.5 9.5) (size 0.53 0.53) (layers "F.Cu" "F.Paste" "F.Mask") (die_length 13.35584352) (tstamp 604d82f6-f74d-4148-a5cc-d970ea6c3ce0))
  (pad "AC23" smd circle (at 9.5 9.5) (size 0.53 0.53) (layers "F.Cu" "F.Paste" "F.Mask") (die_length 15.0036503) (tstamp bc462134-9c06-4e35-8909-5661f9a02009))
  (pad "AC24" smd circle (at 10.5 9.5) (size 0.53 0.53) (layers "F.Cu" "F.Paste" "F.Mask") (die_length 15.5095212) (tstamp c6dd9ae2-cda3-466c-8bfb-e2ec56676427))
  (pad "AC25" smd circle (at 11.5 9.5) (size 0.53 0.53) (layers "F.Cu" "F.Paste" "F.Mask") (die_length 0.0) (tstamp 80f5a94b-0992-4999-82ba-800a19d17e77))
  (pad "AC26" smd circle (at 12.5 9.5) (size 0.53 0.53) (layers "F.Cu" "F.Paste" "F.Mask") (die_length 19.96121555) (tstamp e1c0d5fc-8dbe-4716-98d1-9257ade39f1b))
  (pad "AD1" smd circle (at -12.5 10.5) (size 0.53 0.53) (layers "F.Cu" "F.Paste" "F.Mask") (die_length 25.04638924) (tstamp c4871cdf-4121-4643-8b20-216076011f37))
  (pad "AD2" smd circle (at -11.5 10.5) (size 0.53 0.53) (layers "F.Cu" "F.Paste" "F.Mask") (die_length 0.0) (tstamp aeba33f9-08c0-4092-bc66-235815947365))
  (pad "AD3" smd circle (at -10.5 10.5) (size 0.53 0.53) (layers "F.Cu" "F.Paste" "F.Mask") (die_length 19.80364422) (tstamp 333c5e9e-5384-4059-8e15-0219611f634e))
  (pad "AD4" smd circle (at -9.5 10.5) (size 0.53 0.53) (layers "F.Cu" "F.Paste" "F.Mask") (die_length 20.99668431) (tstamp 956498c9-570f-43b5-b417-654fa7f652ea))
  (pad "AD5" smd circle (at -8.5 10.5) (size 0.53 0.53) (layers "F.Cu" "F.Paste" "F.Mask") (die_length 20.15209588) (tstamp 2a005b6e-e0f1-4a2d-a3e2-5be19f19b086))
  (pad "AD6" smd circle (at -7.5 10.5) (size 0.53 0.53) (layers "F.Cu" "F.Paste" "F.Mask") (die_length 20.55910446) (tstamp 7b9df02e-ab84-4079-87b1-355ae6484096))
  (pad "AD7" smd circle (at -6.5 10.5) (size 0.53 0.53) (layers "F.Cu" "F.Paste" "F.Mask") (die_length 0.0) (tstamp cbcee090-db89-4276-b97c-1e1254dc168a))
  (pad "AD8" smd circle (at -5.5 10.5) (size 0.53 0.53) (layers "F.Cu" "F.Paste" "F.Mask") (die_length 20.16837014) (tstamp c90c811a-2a9e-41b6-9c45-9f26a4fb827d))
  (pad "AD9" smd circle (at -4.5 10.5) (size 0.53 0.53) (layers "F.Cu" "F.Paste" "F.Mask") (die_length 19.35633023) (tstamp 3c1754ab-093d-4aaf-a6d1-2bc85ebe65c6))
  (pad "AD10" smd circle (at -3.5 10.5) (size 0.53 0.53) (layers "F.Cu" "F.Paste" "F.Mask") (die_length 19.07784267) (tstamp f19bb83d-d933-44f5-8476-8c38467961ac))
  (pad "AD11" smd circle (at -2.5 10.5) (size 0.53 0.53) (layers "F.Cu" "F.Paste" "F.Mask") (die_length 21.39502342) (tstamp 794054ba-e3a1-41a9-a6e7-ad751a50dcaf))
  (pad "AD12" smd circle (at -1.5 10.5) (size 0.53 0.53) (layers "F.Cu" "F.Paste" "F.Mask") (die_length 0.0) (tstamp f182f950-519a-4f54-8bc2-b86b9d95f706))
  (pad "AD13" smd circle (at -0.5 10.5) (size 0.53 0.53) (layers "F.Cu" "F.Paste" "F.Mask") (die_length 27.88343372) (tstamp c406a38d-b497-43c4-9088-7c982dfa50ae))
  (pad "AD14" smd circle (at 0.5 10.5) (size 0.53 0.53) (layers "F.Cu" "F.Paste" "F.Mask") (die_length 19.5899495) (tstamp 398887aa-be18-4f45-8b5e-976bcefc03a2))
  (pad "AD15" smd circle (at 1.5 10.5) (size 0.53 0.53) (layers "F.Cu" "F.Paste" "F.Mask") (die_length 23.42808907) (tstamp ecc84dde-2755-4f38-a80c-6714c16a4db2))
  (pad "AD16" smd circle (at 2.5 10.5) (size 0.53 0.53) (layers "F.Cu" "F.Paste" "F.Mask") (die_length 22.94853075) (tstamp 73dd0da1-9001-42b4-a35d-daed88f8a739))
  (pad "AD17" smd circle (at 3.5 10.5) (size 0.53 0.53) (layers "F.Cu" "F.Paste" "F.Mask") (die_length 0.0) (tstamp 9bfd358d-4dde-45dc-a3df-87b394a34b1a))
  (pad "AD18" smd circle (at 4.5 10.5) (size 0.53 0.53) (layers "F.Cu" "F.Paste" "F.Mask") (die_length 21.65206546) (tstamp efdf0629-6d9a-40ee-a893-b030e670db97))
  (pad "AD19" smd circle (at 5.5 10.5) (size 0.53 0.53) (layers "F.Cu" "F.Paste" "F.Mask") (die_length 20.38100018) (tstamp 723c64f5-ab38-47b9-859f-73a6843eed4b))
  (pad "AD20" smd circle (at 6.5 10.5) (size 0.53 0.53) (layers "F.Cu" "F.Paste" "F.Mask") (die_length 23.64421731) (tstamp 36f749da-60c6-401e-a637-234c2058a348))
  (pad "AD21" smd circle (at 7.5 10.5) (size 0.53 0.53) (layers "F.Cu" "F.Paste" "F.Mask") (die_length 14.48378658) (tstamp 0201ca82-2efa-45fa-b98f-4c55f8c32552))
  (pad "AD22" smd circle (at 8.5 10.5) (size 0.53 0.53) (layers "F.Cu" "F.Paste" "F.Mask") (die_length 0.0) (tstamp df5dea35-0a79-400c-805e-9cdf2eb75869))
  (pad "AD23" smd circle (at 9.5 10.5) (size 0.53 0.53) (layers "F.Cu" "F.Paste" "F.Mask") (die_length 15.57066375) (tstamp 7442bfcc-9dfb-4fc4-8158-ee5063d22073))
  (pad "AD24" smd circle (at 10.5 10.5) (size 0.53 0.53) (layers "F.Cu" "F.Paste" "F.Mask") (die_length 16.3699276) (tstamp dbe97a2e-79b6-4c3d-ab4d-5c396fe1d4c1))
  (pad "AD25" smd circle (at 11.5 10.5) (size 0.53 0.53) (layers "F.Cu" "F.Paste" "F.Mask") (die_length 18.11766137) (tstamp b205e3e0-62b5-4a1b-941c-7ff526be5459))
  (pad "AD26" smd circle (at 12.5 10.5) (size 0.53 0.53) (layers "F.Cu" "F.Paste" "F.Mask") (die_length 19.34735657) (tstamp 314cab80-9e71-46ce-9992-5facccf5b814))
  (pad "AE1" smd circle (at -12.5 11.5) (size 0.53 0.53) (layers "F.Cu" "F.Paste" "F.Mask") (die_length 24.86402628) (tstamp 1ca8bf7c-7e6c-4597-8cb3-2b03c4a96e7e))
  (pad "AE2" smd circle (at -11.5 11.5) (size 0.53 0.53) (layers "F.Cu" "F.Paste" "F.Mask") (die_length 26.1781347) (tstamp fb2395c8-0b91-4e0e-a13c-1154fcf533ac))
  (pad "AE3" smd circle (at -10.5 11.5) (size 0.53 0.53) (layers "F.Cu" "F.Paste" "F.Mask") (die_length 25.67043864) (tstamp 588100e0-9e0d-4e10-b6bc-9a4e16d5b875))
  (pad "AE4" smd circle (at -9.5 11.5) (size 0.53 0.53) (layers "F.Cu" "F.Paste" "F.Mask") (die_length 0.0) (tstamp 847104f4-e9a6-404d-b6e9-7a676fee92ab))
  (pad "AE5" smd circle (at -8.5 11.5) (size 0.53 0.53) (layers "F.Cu" "F.Paste" "F.Mask") (die_length 21.37783659) (tstamp 7faa7fb3-2e1b-4ab8-92cf-343da962c680))
  (pad "AE6" smd circle (at -7.5 11.5) (size 0.53 0.53) (layers "F.Cu" "F.Paste" "F.Mask") (die_length 21.35715155) (tstamp 5e23a052-8163-4ac3-aba7-61e5a1172c83))
  (pad "AE7" smd circle (at -6.5 11.5) (size 0.53 0.53) (layers "F.Cu" "F.Paste" "F.Mask") (die_length 20.36883251) (tstamp 4cce58de-d2c8-4a09-b469-331e35383d6c))
  (pad "AE8" smd circle (at -5.5 11.5) (size 0.53 0.53) (layers "F.Cu" "F.Paste" "F.Mask") (die_length 20.67028655) (tstamp 4c9f820a-a83d-4322-a88a-fd627331a8f0))
  (pad "AE9" smd circle (at -4.5 11.5) (size 0.53 0.53) (layers "F.Cu" "F.Paste" "F.Mask") (die_length 0.0) (tstamp 1b234ffb-def6-41b5-8796-7ea44a586aee))
  (pad "AE10" smd circle (at -3.5 11.5) (size 0.53 0.53) (layers "F.Cu" "F.Paste" "F.Mask") (die_length 18.98247855) (tstamp 46951325-148b-4193-a65e-543d0852d63d))
  (pad "AE11" smd circle (at -2.5 11.5) (size 0.53 0.53) (layers "F.Cu" "F.Paste" "F.Mask") (die_length 18.29880757) (tstamp ed309e44-8c07-476e-8fef-6877a85ec56b))
  (pad "AE12" smd circle (at -1.5 11.5) (size 0.53 0.53) (layers "F.Cu" "F.Paste" "F.Mask") (die_length 23.96072884) (tstamp 34dae89f-c50d-46e3-8170-770b90f5590c))
  (pad "AE13" smd circle (at -0.5 11.5) (size 0.53 0.53) (layers "F.Cu" "F.Paste" "F.Mask") (die_length 24.79178074) (tstamp 3f68acda-faa9-48dc-9d76-99724abf3909))
  (pad "AE14" smd circle (at 0.5 11.5) (size 0.53 0.53) (layers "F.Cu" "F.Paste" "F.Mask") (die_length 0.0) (tstamp c2b6f378-d37a-48fb-9c8c-f817b066e279))
  (pad "AE15" smd circle (at 1.5 11.5) (size 0.53 0.53) (layers "F.Cu" "F.Paste" "F.Mask") (die_length 23.34534891) (tstamp 71691afa-0e28-441f-ad98-dfc9ae66c50a))
  (pad "AE16" smd circle (at 2.5 11.5) (size 0.53 0.53) (layers "F.Cu" "F.Paste" "F.Mask") (die_length 21.25722455) (tstamp bfe0fa34-c164-4916-998e-a274d464a5bd))
  (pad "AE17" smd circle (at 3.5 11.5) (size 0.53 0.53) (layers "F.Cu" "F.Paste" "F.Mask") (die_length 30.15970068) (tstamp 6360ba3e-a446-4686-a748-52b0e6c8c475))
  (pad "AE18" smd circle (at 4.5 11.5) (size 0.53 0.53) (layers "F.Cu" "F.Paste" "F.Mask") (die_length 27.53665511) (tstamp 74bf3384-ca44-41a7-8944-0a16b0e48301))
  (pad "AE19" smd circle (at 5.5 11.5) (size 0.53 0.53) (layers "F.Cu" "F.Paste" "F.Mask") (die_length 0.0) (tstamp 2adf59a2-65c4-472b-beff-51130944970b))
  (pad "AE20" smd circle (at 6.5 11.5) (size 0.53 0.53) (layers "F.Cu" "F.Paste" "F.Mask") (die_length 23.11401107) (tstamp e2a3d022-63c7-4bf8-ae9c-692d8044de95))
  (pad "AE21" smd circle (at 7.5 11.5) (size 0.53 0.53) (layers "F.Cu" "F.Paste" "F.Mask") (die_length 14.61344832) (tstamp 4756f586-dd5d-4606-be56-d8458c7ffd12))
  (pad "AE22" smd circle (at 8.5 11.5) (size 0.53 0.53) (layers "F.Cu" "F.Paste" "F.Mask") (die_length 15.4356026) (tstamp 1f9f4c43-c557-47ff-848a-74809f42595a))
  (pad "AE23" smd circle (at 9.5 11.5) (size 0.53 0.53) (layers "F.Cu" "F.Paste" "F.Mask") (die_length 19.29123319) (tstamp 944eee34-98d6-4643-aba4-8083a62dbbe4))
  (pad "AE24" smd circle (at 10.5 11.5) (size 0.53 0.53) (layers "F.Cu" "F.Paste" "F.Mask") (die_length 0.0) (tstamp aea7e762-37a9-49e9-b919-f09054f213b0))
  (pad "AE25" smd circle (at 11.5 11.5) (size 0.53 0.53) (layers "F.Cu" "F.Paste" "F.Mask") (die_length 17.91096307) (tstamp ec3d7913-26ac-4833-8138-f382a8b7f9db))
  (pad "AE26" smd circle (at 12.5 11.5) (size 0.53 0.53) (layers "F.Cu" "F.Paste" "F.Mask") (die_length 19.64759384) (tstamp ab53068d-ed8e-497e-8332-5aee9ce2949d))
  (pad "AF1" smd circle (at -12.5 12.5) (size 0.53 0.53) (layers "F.Cu" "F.Paste" "F.Mask") (die_length 0.0) (tstamp 9801e1b2-9640-4dbb-9a34-ed7d631afd62))
  (pad "AF2" smd circle (at -11.5 12.5) (size 0.53 0.53) (layers "F.Cu" "F.Paste" "F.Mask") (die_length 25.96520046) (tstamp fc6d88de-20e0-4759-a3ae-2c988020b764))
  (pad "AF3" smd circle (at -10.5 12.5) (size 0.53 0.53) (layers "F.Cu" "F.Paste" "F.Mask") (die_length 25.02159762) (tstamp c4c79629-1501-4e8b-a8d2-a447bf1b4411))
  (pad "AF4" smd circle (at -9.5 12.5) (size 0.53 0.53) (layers "F.Cu" "F.Paste" "F.Mask") (die_length 22.67171625) (tstamp 6dbdca6b-6eea-4862-84a4-13707c5118a7))
  (pad "AF5" smd circle (at -8.5 12.5) (size 0.53 0.53) (layers "F.Cu" "F.Paste" "F.Mask") (die_length 22.73042526) (tstamp b32e48f7-ce46-4f0f-84bf-6694d369f791))
  (pad "AF6" smd circle (at -7.5 12.5) (size 0.53 0.53) (layers "F.Cu" "F.Paste" "F.Mask") (die_length 0.0) (tstamp c5285e9b-a10f-427d-be54-0eb3b785c5d3))
  (pad "AF7" smd circle (at -6.5 12.5) (size 0.53 0.53) (layers "F.Cu" "F.Paste" "F.Mask") (die_length 21.6914583) (tstamp add954c6-6666-4813-956f-b238bd85a1b8))
  (pad "AF8" smd circle (at -5.5 12.5) (size 0.53 0.53) (layers "F.Cu" "F.Paste" "F.Mask") (die_length 21.2812557) (tstamp 2d270d06-f120-409b-a1b4-b0dba0fe8b4c))
  (pad "AF9" smd circle (at -4.5 12.5) (size 0.53 0.53) (layers "F.Cu" "F.Paste" "F.Mask") (die_length 19.69824177) (tstamp ab21ffc6-014c-47e1-977d-98f5214acd3d))
  (pad "AF10" smd circle (at -3.5 12.5) (size 0.53 0.53) (layers "F.Cu" "F.Paste" "F.Mask") (die_length 19.19602117) (tstamp d0066825-22d4-48c6-9547-11d466e77de3))
  (pad "AF11" smd circle (at -2.5 12.5) (size 0.53 0.53) (layers "F.Cu" "F.Paste" "F.Mask") (die_length 0.0) (tstamp fdfeec86-cb42-4e5c-9a21-0541570e14ac))
  (pad "AF12" smd circle (at -1.5 12.5) (size 0.53 0.53) (layers "F.Cu" "F.Paste" "F.Mask") (die_length 23.55432865) (tstamp 585085f6-8da5-4392-8acf-f359a5cc8253))
  (pad "AF13" smd circle (at -0.5 12.5) (size 0.53 0.53) (layers "F.Cu" "F.Paste" "F.Mask") (die_length 23.89198151) (tstamp dbbd5b32-67e1-4a18-82f5-372fa419e5f2))
  (pad "AF14" smd circle (at 0.5 12.5) (size 0.53 0.53) (layers "F.Cu" "F.Paste" "F.Mask") (die_length 23.40208067) (tstamp 50a9884d-f81c-4e7b-bd1c-cc9082d1454f))
  (pad "AF15" smd circle (at 1.5 12.5) (size 0.53 0.53) (layers "F.Cu" "F.Paste" "F.Mask") (die_length 23.54003164) (tstamp dbd47369-46b5-451a-8fa8-ea97ff68329d))
  (pad "AF16" smd circle (at 2.5 12.5) (size 0.53 0.53) (layers "F.Cu" "F.Paste" "F.Mask") (die_length 0.0) (tstamp 0d03ea19-9c3c-45b3-87fd-2d8a0ef073b1))
  (pad "AF17" smd circle (at 3.5 12.5) (size 0.53 0.53) (layers "F.Cu" "F.Paste" "F.Mask") (die_length 28.99023544) (tstamp c9672af4-fd37-4ec5-918b-7068a535d603))
  (pad "AF18" smd circle (at 4.5 12.5) (size 0.53 0.53) (layers "F.Cu" "F.Paste" "F.Mask") (die_length 27.1048549) (tstamp e1029456-a5ca-4811-b23a-4b652669cd8c))
  (pad "AF19" smd circle (at 5.5 12.5) (size 0.53 0.53) (layers "F.Cu" "F.Paste" "F.Mask") (die_length 24.32073979) (tstamp 7e0575c7-08bb-415d-b40d-ec0c68ef9d4d))
  (pad "AF20" smd circle (at 6.5 12.5) (size 0.53 0.53) (layers "F.Cu" "F.Paste" "F.Mask") (die_length 23.65045325) (tstamp 4cf4e6c3-d681-4a06-9509-40476d378b38))
  (pad "AF21" smd circle (at 7.5 12.5) (size 0.53 0.53) (layers "F.Cu" "F.Paste" "F.Mask") (die_length 0.0) (tstamp 5ee0b168-6350-4836-a449-77472f7188f2))
  (pad "AF22" smd circle (at 8.5 12.5) (size 0.53 0.53) (layers "F.Cu" "F.Paste" "F.Mask") (die_length 15.65675002) (tstamp e5d9c566-64e3-4080-8dcd-a4a34b01d076))
  (pad "AF23" smd circle (at 9.5 12.5) (size 0.53 0.53) (layers "F.Cu" "F.Paste" "F.Mask") (die_length 17.80890673) (tstamp 00131ca8-8d2b-4e08-97d9-e51f6c0b07f5))
  (pad "AF24" smd circle (at 10.5 12.5) (size 0.53 0.53) (layers "F.Cu" "F.Paste" "F.Mask") (die_length 20.29019894) (tstamp 1e636845-c3d5-4b3d-89a9-2243bfb0d0b3))
  (pad "AF25" smd circle (at 11.5 12.5) (size 0.53 0.53) (layers "F.Cu" "F.Paste" "F.Mask") (die_length 20.91014175) (tstamp 2dddef82-9c51-42e3-8c3f-2073b122030b))
  (pad "AF26" smd circle (at 12.5 12.5) (size 0.53 0.53) (layers "F.Cu" "F.Paste" "F.Mask") (die_length 0.0) (tstamp 837e38b2-ec26-435c-92d0-9338cecf761f))
  (pad "B1" smd circle (at -12.5 -11.5) (size 0.53 0.53) (layers "F.Cu" "F.Paste" "F.Mask") (die_length 16.14604247) (tstamp 9526d2ea-b92b-4560-a703-e5b63da3211f))
  (pad "B2" smd circle (at -11.5 -11.5) (size 0.53 0.53) (layers "F.Cu" "F.Paste" "F.Mask") (die_length 16.15760175) (tstamp 62f2ca8e-3c68-45a6-996c-e1272adce388))
  (pad "B3" smd circle (at -10.5 -11.5) (size 0.53 0.53) (layers "F.Cu" "F.Paste" "F.Mask") (die_length 0.0) (tstamp b20bbbef-970b-412b-810c-70f14e09dce8))
  (pad "B4" smd circle (at -9.5 -11.5) (size 0.53 0.53) (layers "F.Cu" "F.Paste" "F.Mask") (die_length 0.0) (tstamp 7b418c77-cdb1-4ba2-9c0d-8a62e6b10ff3))
  (pad "B5" smd circle (at -8.5 -11.5) (size 0.53 0.53) (layers "F.Cu" "F.Paste" "F.Mask") (die_length 13.99008335) (tstamp fa0eaedb-65f4-4230-9818-ca6b76fa374e))
  (pad "B6" smd circle (at -7.5 -11.5) (size 0.53 0.53) (layers "F.Cu" "F.Paste" "F.Mask") (die_length 13.9660522) (tstamp 289e3d93-ec0d-4e82-ab2e-1772e9d9f39b))
  (pad "B7" smd circle (at -6.5 -11.5) (size 0.53 0.53) (layers "F.Cu" "F.Paste" "F.Mask") (die_length 0.0) (tstamp f2bb24c7-33d6-4ba3-868b-26e5d7fffe4b))
  (pad "B8" smd circle (at -5.5 -11.5) (size 0.53 0.53) (layers "F.Cu" "F.Paste" "F.Mask") (die_length 0.0) (tstamp 715ec43b-383a-4b90-ac46-f26b383d1d28))
  (pad "B9" smd circle (at -4.5 -11.5) (size 0.53 0.53) (layers "F.Cu" "F.Paste" "F.Mask") (die_length 22.60464197) (tstamp d6168a4f-78a0-41c1-ac1d-23ab1fad1aec))
  (pad "B10" smd circle (at -3.5 -11.5) (size 0.53 0.53) (layers "F.Cu" "F.Paste" "F.Mask") (die_length 19.482874) (tstamp 19d911db-d25e-48ca-8ff1-539b04a2baa4))
  (pad "B11" smd circle (at -2.5 -11.5) (size 0.53 0.53) (layers "F.Cu" "F.Paste" "F.Mask") (die_length 19.64744175) (tstamp 4258cf0a-7ed9-4699-a137-d4895b4955eb))
  (pad "B12" smd circle (at -1.5 -11.5) (size 0.53 0.53) (layers "F.Cu" "F.Paste" "F.Mask") (die_length 21.01052503) (tstamp c434ae76-f5fb-4cb8-a05c-e60462cb86f9))
  (pad "B13" smd circle (at -0.5 -11.5) (size 0.53 0.53) (layers "F.Cu" "F.Paste" "F.Mask") (die_length 0.0) (tstamp c2ca89a8-c037-443d-af55-33f9f76f0ede))
  (pad "B14" smd circle (at 0.5 -11.5) (size 0.53 0.53) (layers "F.Cu" "F.Paste" "F.Mask") (die_length 20.28974265) (tstamp d31152f3-9f46-46a1-b5d3-c25d2a76e466))
  (pad "B15" smd circle (at 1.5 -11.5) (size 0.53 0.53) (layers "F.Cu" "F.Paste" "F.Mask") (die_length 19.19815051) (tstamp 50bbd8cc-9a7e-434b-a13c-b910d49bcfac))
  (pad "B16" smd circle (at 2.5 -11.5) (size 0.53 0.53) (layers "F.Cu" "F.Paste" "F.Mask") (die_length 17.46091136) (tstamp 67d56802-9bc2-487a-a8d4-ef01356894a2))
  (pad "B17" smd circle (at 3.5 -11.5) (size 0.53 0.53) (layers "F.Cu" "F.Paste" "F.Mask") (die_length 18.94658393) (tstamp 03dccc72-68e0-48fd-8040-e68939d2b112))
  (pad "B18" smd circle (at 4.5 -11.5) (size 0.53 0.53) (layers "F.Cu" "F.Paste" "F.Mask") (die_length 0.0) (tstamp 873fe6e6-0078-497a-841d-5f91ec26fc74))
  (pad "B19" smd circle (at 5.5 -11.5) (size 0.53 0.53) (layers "F.Cu" "F.Paste" "F.Mask") (die_length 19.52439618) (tstamp 748e62f5-b55e-457e-b4d6-3e4da1d65afa))
  (pad "B20" smd circle (at 6.5 -11.5) (size 0.53 0.53) (layers "F.Cu" "F.Paste" "F.Mask") (die_length 21.84583561) (tstamp 98a325d2-b8ff-4bd8-a716-27dee752d097))
  (pad "B21" smd circle (at 7.5 -11.5) (size 0.53 0.53) (layers "F.Cu" "F.Paste" "F.Mask") (die_length 22.36569934) (tstamp 114427b4-a89c-4a1a-9f7d-0fb7239f2ec5))
  (pad "B22" smd circle (at 8.5 -11.5) (size 0.53 0.53) (layers "F.Cu" "F.Paste" "F.Mask") (die_length 25.97310945) (tstamp 47de2532-4eea-4ad8-bff2-88c01ed4fbab))
  (pad "B23" smd circle (at 9.5 -11.5) (size 0.53 0.53) (layers "F.Cu" "F.Paste" "F.Mask") (die_length 0.0) (tstamp 55bf0870-7822-4912-9072-abe44cf5af97))
  (pad "B24" smd circle (at 10.5 -11.5) (size 0.53 0.53) (layers "F.Cu" "F.Paste" "F.Mask") (die_length 27.64951025) (tstamp 95f1ff45-be4f-47ef-9359-ca1d8d5b9a82))
  (pad "B25" smd circle (at 11.5 -11.5) (size 0.53 0.53) (layers "F.Cu" "F.Paste" "F.Mask") (die_length 29.52667762) (tstamp 4bab5727-55f1-4659-a45c-6133ed4da50a))
  (pad "B26" smd circle (at 12.5 -11.5) (size 0.53 0.53) (layers "F.Cu" "F.Paste" "F.Mask") (die_length 29.92091014) (tstamp 20975597-8453-4255-8e6c-876b04e35451))
  (pad "C1" smd circle (at -12.5 -10.5) (size 0.53 0.53) (layers "F.Cu" "F.Paste" "F.Mask") (die_length 0.0) (tstamp 02c8dc0c-4f30-4570-addd-5753d01c0a6b))
  (pad "C2" smd circle (at -11.5 -10.5) (size 0.53 0.53) (layers "F.Cu" "F.Paste" "F.Mask") (die_length 0.0) (tstamp aac2d164-01b7-46b2-8d71-7035f06a8888))
  (pad "C3" smd circle (at -10.5 -10.5) (size 0.53 0.53) (layers "F.Cu" "F.Paste" "F.Mask") (die_length 14.88615623) (tstamp 1529c2d6-3d4b-4f21-8ea4-87126f782141))
  (pad "C4" smd circle (at -9.5 -10.5) (size 0.53 0.53) (layers "F.Cu" "F.Paste" "F.Mask") (die_length 14.83687717) (tstamp a3dd4803-24e4-40a1-be83-f2ba960733b8))
  (pad "C5" smd circle (at -8.5 -10.5) (size 0.53 0.53) (layers "F.Cu" "F.Paste" "F.Mask") (die_length 0.0) (tstamp 67f79ae3-a08d-4aa7-8869-5a8214074c5a))
  (pad "C6" smd circle (at -7.5 -10.5) (size 0.53 0.53) (layers "F.Cu" "F.Paste" "F.Mask") (die_length 0.0) (tstamp 2f298104-67dc-4d86-b7e7-c7c99c72e861))
  (pad "C7" smd circle (at -6.5 -10.5) (size 0.53 0.53) (layers "F.Cu" "F.Paste" "F.Mask") (die_length 0.0) (tstamp 80cb5752-be7e-44d4-b485-8ab6b7e42a7c))
  (pad "C8" smd circle (at -5.5 -10.5) (size 0.53 0.53) (layers "F.Cu" "F.Paste" "F.Mask") (die_length 23.60817059) (tstamp 2ab9ffb3-857b-457f-9abb-3ed55ee5f499))
  (pad "C9" smd circle (at -4.5 -10.5) (size 0.53 0.53) (layers "F.Cu" "F.Paste" "F.Mask") (die_length 20.77660157) (tstamp 6baa3c25-441e-4d8b-896f-f63d365abff1))
  (pad "C10" smd circle (at -3.5 -10.5) (size 0.53 0.53) (layers "F.Cu" "F.Paste" "F.Mask") (die_length 0.0) (tstamp 711e4cdd-b80a-4c92-9f9b-1f5d4c8b439a))
  (pad "C11" smd circle (at -2.5 -10.5) (size 0.53 0.53) (layers "F.Cu" "F.Paste" "F.Mask") (die_length 20.20624201) (tstamp e85954ed-31d6-42b5-82a7-80e113c18c1f))
  (pad "C12" smd circle (at -1.5 -10.5) (size 0.53 0.53) (layers "F.Cu" "F.Paste" "F.Mask") (die_length 20.63484821) (tstamp 0b28aed6-5fef-44ad-88ab-9e2873c4fa66))
  (pad "C13" smd circle (at -0.5 -10.5) (size 0.53 0.53) (layers "F.Cu" "F.Paste" "F.Mask") (die_length 18.63524366) (tstamp c81cd220-6fe7-4ccc-8f5e-fd1e0a493799))
  (pad "C14" smd circle (at 0.5 -10.5) (size 0.53 0.53) (layers "F.Cu" "F.Paste" "F.Mask") (die_length 18.4895358) (tstamp d04e2be4-7ae7-4fdf-978a-0d738ca9186b))
  (pad "C15" smd circle (at 1.5 -10.5) (size 0.53 0.53) (layers "F.Cu" "F.Paste" "F.Mask") (die_length 0.0) (tstamp 48af6c27-9b39-4803-a0a6-0e7714308533))
  (pad "C16" smd circle (at 2.5 -10.5) (size 0.53 0.53) (layers "F.Cu" "F.Paste" "F.Mask") (die_length 15.96094178) (tstamp c7aa9081-82a5-477f-886b-3bc16c8de52a))
  (pad "C17" smd circle (at 3.5 -10.5) (size 0.53 0.53) (layers "F.Cu" "F.Paste" "F.Mask") (die_length 16.95914705) (tstamp 63becf74-63d0-47d8-a6ec-b89e7f5cb78c))
  (pad "C18" smd circle (at 4.5 -10.5) (size 0.53 0.53) (layers "F.Cu" "F.Paste" "F.Mask") (die_length 18.56482326) (tstamp a181cd97-f83f-4d1d-9a8f-6fea415d6c2b))
  (pad "C19" smd circle (at 5.5 -10.5) (size 0.53 0.53) (layers "F.Cu" "F.Paste" "F.Mask") (die_length 17.4628886) (tstamp 78426e5e-3d8f-450e-ad74-aa27d290e77c))
  (pad "C20" smd circle (at 6.5 -10.5) (size 0.53 0.53) (layers "F.Cu" "F.Paste" "F.Mask") (die_length 0.0) (tstamp 798d2170-b9ca-4ef5-9f94-f0cd131371ec))
  (pad "C21" smd circle (at 7.5 -10.5) (size 0.53 0.53) (layers "F.Cu" "F.Paste" "F.Mask") (die_length 20.65416439) (tstamp f6f8081f-36f8-4ec0-bf85-4f1a6dbe7d19))
  (pad "C22" smd circle (at 8.5 -10.5) (size 0.53 0.53) (layers "F.Cu" "F.Paste" "F.Mask") (die_length 21.24155868) (tstamp 4e2c7429-35af-4071-969d-5febbecb50cb))
  (pad "C23" smd circle (at 9.5 -10.5) (size 0.53 0.53) (layers "F.Cu" "F.Paste" "F.Mask") (die_length 24.56378901) (tstamp 08b338d7-605b-46b5-8557-6423e789c66f))
  (pad "C24" smd circle (at 10.5 -10.5) (size 0.53 0.53) (layers "F.Cu" "F.Paste" "F.Mask") (die_length 24.49853988) (tstamp 85425c9d-e31f-4df3-b021-19eab29cf935))
  (pad "C25" smd circle (at 11.5 -10.5) (size 0.53 0.53) (layers "F.Cu" "F.Paste" "F.Mask") (die_length 0.0) (tstamp 546c75d9-730b-46d6-af99-b8199eb3a63b))
  (pad "C26" smd circle (at 12.5 -10.5) (size 0.53 0.53) (layers "F.Cu" "F.Paste" "F.Mask") (die_length 25.66678834) (tstamp 3d949846-b58f-4d24-b8f7-ee5d96ed3995))
  (pad "D1" smd circle (at -12.5 -9.5) (size 0.53 0.53) (layers "F.Cu" "F.Paste" "F.Mask") (die_length 15.50876072) (tstamp 6ae2d8d8-399d-4877-8baf-d120fbdee2c6))
  (pad "D2" smd circle (at -11.5 -9.5) (size 0.53 0.53) (layers "F.Cu" "F.Paste" "F.Mask") (die_length 15.5169739) (tstamp af954494-bd93-48b8-9279-78adfb0f83e1))
  (pad "D3" smd circle (at -10.5 -9.5) (size 0.53 0.53) (layers "F.Cu" "F.Paste" "F.Mask") (die_length 0.0) (tstamp 4e0c2329-88af-40f5-a705-833eb2323c7d))
  (pad "D4" smd circle (at -9.5 -9.5) (size 0.53 0.53) (layers "F.Cu" "F.Paste" "F.Mask") (die_length 0.0) (tstamp 9055928f-c81e-49ff-862e-24eaafcaad25))
  (pad "D5" smd circle (at -8.5 -9.5) (size 0.53 0.53) (layers "F.Cu" "F.Paste" "F.Mask") (die_length 13.84239825) (tstamp fccbf503-14fd-4c2b-8a56-7907718cc39b))
  (pad "D6" smd circle (at -7.5 -9.5) (size 0.53 0.53) (layers "F.Cu" "F.Paste" "F.Mask") (die_length 14.02810732) (tstamp 2cec884b-5cb1-4f94-be74-4eb4033afc29))
  (pad "D7" smd circle (at -6.5 -9.5) (size 0.53 0.53) (layers "F.Cu" "F.Paste" "F.Mask") (die_length 0.0) (tstamp 2d586ab2-347f-4239-8bff-787d4ead8579))
  (pad "D8" smd circle (at -5.5 -9.5) (size 0.53 0.53) (layers "F.Cu" "F.Paste" "F.Mask") (die_length 20.91896331) (tstamp ba7efd70-1339-49b5-b6a3-7a9f18f764b5))
  (pad "D9" smd circle (at -4.5 -9.5) (size 0.53 0.53) (layers "F.Cu" "F.Paste" "F.Mask") (die_length 19.57641297) (tstamp 161c7885-2df8-4911-a13b-2bfa1106a3fe))
  (pad "D10" smd circle (at -3.5 -9.5) (size 0.53 0.53) (layers "F.Cu" "F.Paste" "F.Mask") (die_length 19.81079272) (tstamp 8a060051-24a8-4c09-b6c5-8add0a25cb80))
  (pad "D11" smd circle (at -2.5 -9.5) (size 0.53 0.53) (layers "F.Cu" "F.Paste" "F.Mask") (die_length 16.68537446) (tstamp 97655c0a-4f17-42bd-b45f-2f0cc015a706))
  (pad "D12" smd circle (at -1.5 -9.5) (size 0.53 0.53) (layers "F.Cu" "F.Paste" "F.Mask") (die_length 0.0) (tstamp b95fa1c8-bbee-442e-a9e7-038473b8439a))
  (pad "D13" smd circle (at -0.5 -9.5) (size 0.53 0.53) (layers "F.Cu" "F.Paste" "F.Mask") (die_length 16.95062968) (tstamp fa613bba-1b56-410c-bfb9-93f7159894ef))
  (pad "D14" smd circle (at 0.5 -9.5) (size 0.53 0.53) (layers "F.Cu" "F.Paste" "F.Mask") (die_length 16.90621768) (tstamp bd2bba5e-742d-4d8a-8036-6f68f9eb4fa2))
  (pad "D15" smd circle (at 1.5 -9.5) (size 0.53 0.53) (layers "F.Cu" "F.Paste" "F.Mask") (die_length 18.97928454) (tstamp 8ab6c6d5-8a05-49b9-a632-083ac5a9d5e8))
  (pad "D16" smd circle (at 2.5 -9.5) (size 0.53 0.53) (layers "F.Cu" "F.Paste" "F.Mask") (die_length 19.49945245) (tstamp bb59d9f9-931a-4eeb-87d5-45c8a9b8b856))
  (pad "D17" smd circle (at 3.5 -9.5) (size 0.53 0.53) (layers "F.Cu" "F.Paste" "F.Mask") (die_length 0.0) (tstamp 7d158e10-6de5-4033-afb4-d52b03daf134))
  (pad "D18" smd circle (at 4.5 -9.5) (size 0.53 0.53) (layers "F.Cu" "F.Paste" "F.Mask") (die_length 18.29926386) (tstamp 64cde957-5ee9-48fe-a84a-885edbe12759))
  (pad "D19" smd circle (at 5.5 -9.5) (size 0.53 0.53) (layers "F.Cu" "F.Paste" "F.Mask") (die_length 18.29272373) (tstamp a58b759d-686d-4029-86aa-62c32a3c0d20))
  (pad "D20" smd circle (at 6.5 -9.5) (size 0.53 0.53) (layers "F.Cu" "F.Paste" "F.Mask") (die_length 18.00678348) (tstamp fc04c89d-7716-4588-949c-6438af13b8d3))
  (pad "D21" smd circle (at 7.5 -9.5) (size 0.53 0.53) (layers "F.Cu" "F.Paste" "F.Mask") (die_length 21.10756221) (tstamp fe7df9b1-4491-47b1-9910-ae03aef2a48d))
  (pad "D22" smd circle (at 8.5 -9.5) (size 0.53 0.53) (layers "F.Cu" "F.Paste" "F.Mask") (die_length 0.0) (tstamp 2ffad991-8daf-43ef-b4dc-f7889053de77))
  (pad "D23" smd circle (at 9.5 -9.5) (size 0.53 0.53) (layers "F.Cu" "F.Paste" "F.Mask") (die_length 20.61872604) (tstamp 371f062e-78d8-42eb-879d-b60e0b48f35c))
  (pad "D24" smd circle (at 10.5 -9.5) (size 0.53 0.53) (layers "F.Cu" "F.Paste" "F.Mask") (die_length 21.11577538) (tstamp 22685396-e60d-4b0c-982e-112390eda76e))
  (pad "D25" smd circle (at 11.5 -9.5) (size 0.53 0.53) (layers "F.Cu" "F.Paste" "F.Mask") (die_length 21.94408955) (tstamp c86fc13e-3217-4b17-beec-b1426f193e8d))
  (pad "D26" smd circle (at 12.5 -9.5) (size 0.53 0.53) (layers "F.Cu" "F.Paste" "F.Mask") (die_length 26.57966782) (tstamp 2d9395c6-711a-4a2d-9fed-0ce6132e43f7))
  (pad "E1" smd circle (at -12.5 -8.5) (size 0.53 0.53) (layers "F.Cu" "F.Paste" "F.Mask") (die_length 0.0) (tstamp 254f3bdc-402c-4ee4-8dc2-7e4ca8cc06ed))
  (pad "E2" smd circle (at -11.5 -8.5) (size 0.53 0.53) (layers "F.Cu" "F.Paste" "F.Mask") (die_length 0.0) (tstamp 67a888dd-0b91-4a70-b385-a570acff09c4))
  (pad "E3" smd circle (at -10.5 -8.5) (size 0.53 0.53) (layers "F.Cu" "F.Paste" "F.Mask") (die_length 13.784906) (tstamp ab05d283-5db6-499e-99e5-b98e34ed6eea))
  (pad "E4" smd circle (at -9.5 -8.5) (size 0.53 0.53) (layers "F.Cu" "F.Paste" "F.Mask") (die_length 13.76733893) (tstamp 01274004-e449-42e0-9772-6563918c745a))
  (pad "E5" smd circle (at -8.5 -8.5) (size 0.53 0.53) (layers "F.Cu" "F.Paste" "F.Mask") (die_length 0.0) (tstamp 06c1a28e-a8b3-4076-98b2-3ca907873832))
  (pad "E6" smd circle (at -7.5 -8.5) (size 0.53 0.53) (layers "F.Cu" "F.Paste" "F.Mask") (die_length 0.0) (tstamp d069831b-3816-4c44-bc11-8d39f8f555b3))
  (pad "E7" smd circle (at -6.5 -8.5) (size 0.53 0.53) (layers "F.Cu" "F.Paste" "F.Mask") (die_length 0.0) (tstamp f50301cb-2727-45f1-9533-dae10e1812f0))
  (pad "E8" smd circle (at -5.5 -8.5) (size 0.53 0.53) (layers "F.Cu" "F.Paste" "F.Mask") (die_length 0.0) (tstamp d19a9bc5-7f13-4f4a-8174-23919fb196d7))
  (pad "E9" smd circle (at -4.5 -8.5) (size 0.53 0.53) (layers "F.Cu" "F.Paste" "F.Mask") (die_length 0.0) (tstamp 6fdb1989-265c-40a6-aaa1-e0207760a264))
  (pad "E10" smd circle (at -3.5 -8.5) (size 0.53 0.53) (layers "F.Cu" "F.Paste" "F.Mask") (die_length 20.01870779) (tstamp 476724f2-029d-4fa0-88cc-2a5b22eb6172))
  (pad "E11" smd circle (at -2.5 -8.5) (size 0.53 0.53) (layers "F.Cu" "F.Paste" "F.Mask") (die_length 16.20064489) (tstamp 4c11e01b-0d85-4dfb-9a2a-2e18d7a73fb9))
  (pad "E12" smd circle (at -1.5 -8.5) (size 0.53 0.53) (layers "F.Cu" "F.Paste" "F.Mask") (die_length 15.37324329) (tstamp 580d71fd-46b5-49ed-b264-7f70acb29908))
  (pad "E13" smd circle (at -0.5 -8.5) (size 0.53 0.53) (layers "F.Cu" "F.Paste" "F.Mask") (die_length 13.90019468) (tstamp ea2ead7b-e4d0-498a-9b7a-54370e5dd53f))
  (pad "E14" smd circle (at 0.5 -8.5) (size 0.53 0.53) (layers "F.Cu" "F.Paste" "F.Mask") (die_length 0.0) (tstamp 57f02bab-f605-4dfe-8122-b96575abb3d3))
  (pad "E15" smd circle (at 1.5 -8.5) (size 0.53 0.53) (layers "F.Cu" "F.Paste" "F.Mask") (die_length 19.60561538) (tstamp 9c033be2-a470-4cbc-bf62-ef2ba04e3931))
  (pad "E16" smd circle (at 2.5 -8.5) (size 0.53 0.53) (layers "F.Cu" "F.Paste" "F.Mask") (die_length 20.09688508) (tstamp 8b83d843-7f34-4dd6-b59f-aa7c298afae6))
  (pad "E17" smd circle (at 3.5 -8.5) (size 0.53 0.53) (layers "F.Cu" "F.Paste" "F.Mask") (die_length 15.02136947) (tstamp 718f9700-841e-40a4-96ab-f8d5959add34))
  (pad "E18" smd circle (at 4.5 -8.5) (size 0.53 0.53) (layers "F.Cu" "F.Paste" "F.Mask") (die_length 17.67399769) (tstamp 4a66c1f4-8201-4080-bc70-eff935440e78))
  (pad "E19" smd circle (at 5.5 -8.5) (size 0.53 0.53) (layers "F.Cu" "F.Paste" "F.Mask") (die_length 0.0) (tstamp b638ae86-83e1-4460-be30-ab14e12e20b2))
  (pad "E20" smd circle (at 6.5 -8.5) (size 0.53 0.53) (layers "F.Cu" "F.Paste" "F.Mask") (die_length 15.34419298) (tstamp a85f760e-58cd-4755-b880-cc19b90bd4dc))
  (pad "E21" smd circle (at 7.5 -8.5) (size 0.53 0.53) (layers "F.Cu" "F.Paste" "F.Mask") (die_length 21.51198516) (tstamp 2b877ae9-c145-4aa7-afdb-bd748e2c110d))
  (pad "E22" smd circle (at 8.5 -8.5) (size 0.53 0.53) (layers "F.Cu" "F.Paste" "F.Mask") (die_length 20.88413336) (tstamp f4d899a0-e6f5-40d4-8f50-b2c0aae3378d))
  (pad "E23" smd circle (at 9.5 -8.5) (size 0.53 0.53) (layers "F.Cu" "F.Paste" "F.Mask") (die_length 19.21427268) (tstamp 7c6fd4a3-8b24-4f81-a30a-26d184933cf8))
  (pad "E24" smd circle (at 10.5 -8.5) (size 0.53 0.53) (layers "F.Cu" "F.Paste" "F.Mask") (die_length 0.0) (tstamp b4de0482-0e6f-45e1-bb27-be1d5b019fdd))
  (pad "E25" smd circle (at 11.5 -8.5) (size 0.53 0.53) (layers "F.Cu" "F.Paste" "F.Mask") (die_length 21.37890126) (tstamp a03f3e99-fb31-4081-bb15-54dc2c14f92f))
  (pad "E26" smd circle (at 12.5 -8.5) (size 0.53 0.53) (layers "F.Cu" "F.Paste" "F.Mask") (die_length 21.77693618) (tstamp f25315de-97af-40a2-bb52-926eb11a2392))
  (pad "F1" smd circle (at -12.5 -7.5) (size 0.53 0.53) (layers "F.Cu" "F.Paste" "F.Mask") (die_length 14.91345744) (tstamp 35917e51-2891-45c3-bf69-98515d375640))
  (pad "F2" smd circle (at -11.5 -7.5) (size 0.53 0.53) (layers "F.Cu" "F.Paste" "F.Mask") (die_length 14.86189694) (tstamp 243b58b1-c837-44b9-b623-a6c32d600bd5))
  (pad "F3" smd circle (at -10.5 -7.5) (size 0.53 0.53) (layers "F.Cu" "F.Paste" "F.Mask") (die_length 0.0) (tstamp d13774b7-f83a-4ef3-980a-281f32a881b8))
  (pad "F4" smd circle (at -9.5 -7.5) (size 0.53 0.53) (layers "F.Cu" "F.Paste" "F.Mask") (die_length 0.0) (tstamp d54cd781-428a-4906-b00b-3f15263d97d1))
  (pad "F5" smd circle (at -8.5 -7.5) (size 0.53 0.53) (layers "F.Cu" "F.Paste" "F.Mask") (die_length 14.22317029) (tstamp f06bd27a-eff2-4a5a-bd65-7fff25d8d230))
  (pad "F6" smd circle (at -7.5 -7.5) (size 0.53 0.53) (layers "F.Cu" "F.Paste" "F.Mask") (die_length 13.96597615) (tstamp 82ddff4d-b50a-4ede-b782-85881fa22158))
  (pad "F7" smd circle (at -6.5 -7.5) (size 0.53 0.53) (layers "F.Cu" "F.Paste" "F.Mask") (die_length 0.0) (tstamp b2d103bd-a2bd-4ebf-82fb-bdbd715effdd))
  (pad "F8" smd circle (at -5.5 -7.5) (size 0.53 0.53) (layers "F.Cu" "F.Paste" "F.Mask") (die_length 22.32448135) (tstamp c3dd3116-3066-4d80-9100-5b045225be8f))
  (pad "F9" smd circle (at -4.5 -7.5) (size 0.53 0.53) (layers "F.Cu" "F.Paste" "F.Mask") (die_length 23.58718136) (tstamp 3adbff29-4015-42c6-bcb4-a9f35b08ce58))
  (pad "F10" smd circle (at -3.5 -7.5) (size 0.53 0.53) (layers "F.Cu" "F.Paste" "F.Mask") (die_length 16.82591105) (tstamp ade930c9-0d11-4689-acaa-e93d6ab735d3))
  (pad "F11" smd circle (at -2.5 -7.5) (size 0.53 0.53) (layers "F.Cu" "F.Paste" "F.Mask") (die_length 0.0) (tstamp 3e6c425b-4566-4c1b-b1b6-2957ee20d996))
  (pad "F12" smd circle (at -1.5 -7.5) (size 0.53 0.53) (layers "F.Cu" "F.Paste" "F.Mask") (die_length 13.80756829) (tstamp d199cbfa-1090-40c1-b65b-35bcb361e5ce))
  (pad "F13" smd circle (at -0.5 -7.5) (size 0.53 0.53) (layers "F.Cu" "F.Paste" "F.Mask") (die_length 15.66313804) (tstamp d5082a80-25a3-48ce-81b0-59ccde9f6957))
  (pad "F14" smd circle (at 0.5 -7.5) (size 0.53 0.53) (layers "F.Cu" "F.Paste" "F.Mask") (die_length 15.5502829) (tstamp 3193d6ea-9ff4-4d23-aa14-13d51aa0827f))
  (pad "F15" smd circle (at 1.5 -7.5) (size 0.53 0.53) (layers "F.Cu" "F.Paste" "F.Mask") (die_length 19.3056823) (tstamp 871a0194-2d78-4500-a892-7ee4dc5f48cd))
  (pad "F16" smd circle (at 2.5 -7.5) (size 0.53 0.53) (layers "F.Cu" "F.Paste" "F.Mask") (die_length 0.0) (tstamp 422c437f-ee53-4cf9-8cd4-fca444d64ad2))
  (pad "F17" smd circle (at 3.5 -7.5) (size 0.53 0.53) (layers "F.Cu" "F.Paste" "F.Mask") (die_length 14.62873395) (tstamp 69dc4639-0547-435c-a59b-81c293c6345f))
  (pad "F18" smd circle (at 4.5 -7.5) (size 0.53 0.53) (layers "F.Cu" "F.Paste" "F.Mask") (die_length 13.32512016) (tstamp 2cebce81-a3d9-40e8-a75c-add45a193780))
  (pad "F19" smd circle (at 5.5 -7.5) (size 0.53 0.53) (layers "F.Cu" "F.Paste" "F.Mask") (die_length 15.12334976) (tstamp 582f2eb0-60e2-49ba-a913-3b2604f3b569))
  (pad "F20" smd circle (at 6.5 -7.5) (size 0.53 0.53) (layers "F.Cu" "F.Paste" "F.Mask") (die_length 13.15849912) (tstamp 1adfb97e-bc30-48e0-ae7a-58695ce99376))
  (pad "F21" smd circle (at 7.5 -7.5) (size 0.53 0.53) (layers "F.Cu" "F.Paste" "F.Mask") (die_length 0.0) (tstamp 9c0adc48-0807-457e-a791-075d842a2771))
  (pad "F22" smd circle (at 8.5 -7.5) (size 0.53 0.53) (layers "F.Cu" "F.Paste" "F.Mask") (die_length 18.80087607) (tstamp 425df5af-658e-4d6f-8360-31e543513ee7))
  (pad "F23" smd circle (at 9.5 -7.5) (size 0.53 0.53) (layers "F.Cu" "F.Paste" "F.Mask") (die_length 18.15659792) (tstamp 436b367c-4e55-4d73-9a45-ba6c9265385e))
  (pad "F24" smd circle (at 10.5 -7.5) (size 0.53 0.53) (layers "F.Cu" "F.Paste" "F.Mask") (die_length 20.147533) (tstamp 2387b74c-b326-41b1-aea5-07025585bebd))
  (pad "F25" smd circle (at 11.5 -7.5) (size 0.53 0.53) (layers "F.Cu" "F.Paste" "F.Mask") (die_length 20.90192858) (tstamp 97fa2b69-84d1-4f28-85cc-82d7edcd2b7e))
  (pad "F26" smd circle (at 12.5 -7.5) (size 0.53 0.53) (layers "F.Cu" "F.Paste" "F.Mask") (die_length 0.0) (tstamp 1d1737d8-b5ba-44e8-8f74-407516a643db))
  (pad "G1" smd circle (at -12.5 -6.5) (size 0.53 0.53) (layers "F.Cu" "F.Paste" "F.Mask") (die_length 0.0) (tstamp aca06fb3-1d09-4303-bfb7-5ed0c1b4f923))
  (pad "G2" smd circle (at -11.5 -6.5) (size 0.53 0.53) (layers "F.Cu" "F.Paste" "F.Mask") (die_length 0.0) (tstamp 3edc492c-a115-42a1-9d4a-d55919ea4cd6))
  (pad "G3" smd circle (at -10.5 -6.5) (size 0.53 0.53) (layers "F.Cu" "F.Paste" "F.Mask") (die_length 12.83567561) (tstamp b659fb90-163a-42ab-9f61-7202846bb4c7))
  (pad "G4" smd circle (at -9.5 -6.5) (size 0.53 0.53) (layers "F.Cu" "F.Paste" "F.Mask") (die_length 12.85020077) (tstamp b284f478-c5bf-4103-b4ba-766c06b515f0))
  (pad "G5" smd circle (at -8.5 -6.5) (size 0.53 0.53) (layers "F.Cu" "F.Paste" "F.Mask") (die_length 0.0) (tstamp 3104a76d-4fd1-4814-8e06-d432e007b288))
  (pad "G6" smd circle (at -7.5 -6.5) (size 0.53 0.53) (layers "F.Cu" "F.Paste" "F.Mask") (die_length 0.0) (tstamp 3855f988-f9c9-47e6-ae3f-c45f2f6187a7))
  (pad "G7" smd circle (at -6.5 -6.5) (size 0.53 0.53) (layers "F.Cu" "F.Paste" "F.Mask") (die_length 20.67393685) (tstamp 2d2851be-9526-4715-a67d-32b6e1d06f80))
  (pad "G8" smd circle (at -5.5 -6.5) (size 0.53 0.53) (layers "F.Cu" "F.Paste" "F.Mask") (die_length 0.0) (tstamp da5f84ff-e154-47c5-8ac1-bf0ec2714bf8))
  (pad "G9" smd circle (at -4.5 -6.5) (size 0.53 0.53) (layers "F.Cu" "F.Paste" "F.Mask") (die_length 15.8086938) (tstamp c928f91f-bca7-4c80-b751-05e7d2bb51f0))
  (pad "G10" smd circle (at -3.5 -6.5) (size 0.53 0.53) (layers "F.Cu" "F.Paste" "F.Mask") (die_length 15.73355844) (tstamp faef9f2e-9932-4b47-81bf-589692ffb857))
  (pad "G11" smd circle (at -2.5 -6.5) (size 0.53 0.53) (layers "F.Cu" "F.Paste" "F.Mask") (die_length 16.79762122) (tstamp 4efe18bd-f69f-4499-87ef-7b892f465929))
  (pad "G12" smd circle (at -1.5 -6.5) (size 0.53 0.53) (layers "F.Cu" "F.Paste" "F.Mask") (die_length 13.84825394) (tstamp ad61b57a-e0c8-4680-a0ff-0ee9735ed05e))
  (pad "G13" smd circle (at -0.5 -6.5) (size 0.53 0.53) (layers "F.Cu" "F.Paste" "F.Mask") (die_length 0.0) (tstamp ddf0d76b-4a34-411f-9e57-3ab164175c75))
  (pad "G14" smd circle (at 0.5 -6.5) (size 0.53 0.53) (layers "F.Cu" "F.Paste" "F.Mask") (die_length 15.81127943) (tstamp 1abb56b8-1c4c-4237-854f-f8681da7b32c))
  (pad "G15" smd circle (at 1.5 -6.5) (size 0.53 0.53) (layers "F.Cu" "F.Paste" "F.Mask") (die_length 19.02369654) (tstamp 5a3a0081-6ef7-4ded-93e3-75032d94f30e))
  (pad "G16" smd circle (at 2.5 -6.5) (size 0.53 0.53) (layers "F.Cu" "F.Paste" "F.Mask") (die_length 14.15046846) (tstamp dfc5afd5-6ce3-4371-b192-3b935847eff7))
  (pad "G17" smd circle (at 3.5 -6.5) (size 0.53 0.53) (layers "F.Cu" "F.Paste" "F.Mask") (die_length 13.74117844) (tstamp d3dfee1e-4085-42db-bec4-92ed9226f36b))
  (pad "G18" smd circle (at 4.5 -6.5) (size 0.53 0.53) (layers "F.Cu" "F.Paste" "F.Mask") (die_length 0.0) (tstamp 39862905-569d-458e-af9b-34f90a6bcf55))
  (pad "G19" smd circle (at 5.5 -6.5) (size 0.53 0.53) (layers "F.Cu" "F.Paste" "F.Mask") (die_length 13.35995011) (tstamp 9f14f0a5-9333-4f69-bfd6-62b59c64958a))
  (pad "G20" smd circle (at 6.5 -6.5) (size 0.53 0.53) (layers "F.Cu" "F.Paste" "F.Mask") (die_length 13.31903632) (tstamp db26da09-e1cf-40ef-95f9-1b6d48eb235c))
  (pad "G21" smd circle (at 7.5 -6.5) (size 0.53 0.53) (layers "F.Cu" "F.Paste" "F.Mask") (die_length 18.5893107) (tstamp 92352f4d-339f-48fd-b11f-53cc76206dce))
  (pad "G22" smd circle (at 8.5 -6.5) (size 0.53 0.53) (layers "F.Cu" "F.Paste" "F.Mask") (die_length 17.97180142) (tstamp 4557b0e6-b48f-463f-9cd8-482bf1aa0b14))
  (pad "G23" smd circle (at 9.5 -6.5) (size 0.53 0.53) (layers "F.Cu" "F.Paste" "F.Mask") (die_length 0.0) (tstamp 3f365165-6f44-449f-9faf-da1b1c1ca3b3))
  (pad "G24" smd circle (at 10.5 -6.5) (size 0.53 0.53) (layers "F.Cu" "F.Paste" "F.Mask") (die_length 19.61778305) (tstamp 854e33b5-e1f9-44bb-93e1-03b5f09e2bd5))
  (pad "G25" smd circle (at 11.5 -6.5) (size 0.53 0.53) (layers "F.Cu" "F.Paste" "F.Mask") (die_length 20.34571394) (tstamp f5af65fb-c604-4c72-8c45-e3c5636a5e48))
  (pad "G26" smd circle (at 12.5 -6.5) (size 0.53 0.53) (layers "F.Cu" "F.Paste" "F.Mask") (die_length 20.84215489) (tstamp efbfcddb-743f-4dd2-bffc-7f97763cf5fe))
  (pad "H1" smd circle (at -12.5 -5.5) (size 0.53 0.53) (layers "F.Cu" "F.Paste" "F.Mask") (die_length 14.07221512) (tstamp d9f01962-4f2e-48e6-b51b-a252ee6d3dda))
  (pad "H2" smd circle (at -11.5 -5.5) (size 0.53 0.53) (layers "F.Cu" "F.Paste" "F.Mask") (die_length 14.0380696) (tstamp 37369318-efcc-46e0-ae7b-b3b58c6f5c72))
  (pad "H3" smd circle (at -10.5 -5.5) (size 0.53 0.53) (layers "F.Cu" "F.Paste" "F.Mask") (die_length 0.0) (tstamp 119504cc-3c30-4bf4-b975-e599d63ad6a5))
  (pad "H4" smd circle (at -9.5 -5.5) (size 0.53 0.53) (layers "F.Cu" "F.Paste" "F.Mask") (die_length 0.0) (tstamp cc699c55-2654-4c84-b1ad-c57668725cb9))
  (pad "H5" smd circle (at -8.5 -5.5) (size 0.53 0.53) (layers "F.Cu" "F.Paste" "F.Mask") (die_length 11.73815173) (tstamp e0129107-e9aa-48bc-9359-796a9da934f4))
  (pad "H6" smd circle (at -7.5 -5.5) (size 0.53 0.53) (layers "F.Cu" "F.Paste" "F.Mask") (die_length 11.67700919) (tstamp 050d0a4b-7ac7-42e8-ae5e-97da427ab413))
  (pad "H7" smd circle (at -6.5 -5.5) (size 0.53 0.53) (layers "F.Cu" "F.Paste" "F.Mask") (die_length 0.0) (tstamp 1a1b68d3-07af-4b45-aa6d-4619231dbe3d))
  (pad "H8" smd circle (at -5.5 -5.5) (size 0.53 0.53) (layers "F.Cu" "F.Paste" "F.Mask") (die_length 22.47155807) (tstamp d6bb81e9-6bc3-4045-97ab-4d3a1f1397c0))
  (pad "H9" smd circle (at -4.5 -5.5) (size 0.53 0.53) (layers "F.Cu" "F.Paste" "F.Mask") (die_length 22.72571029) (tstamp 774edd26-c618-48c6-aab4-b11e5700d20b))
  (pad "H10" smd circle (at -3.5 -5.5) (size 0.53 0.53) (layers "F.Cu" "F.Paste" "F.Mask") (die_length 0.0) (tstamp 2f07b654-41c2-4a1f-b302-fa38ce6a2e54))
  (pad "H11" smd circle (at -2.5 -5.5) (size 0.53 0.53) (layers "F.Cu" "F.Paste" "F.Mask") (die_length 16.3294701) (tstamp 9cc761c6-6ae6-4ae5-a879-e257648a8767))
  (pad "H12" smd circle (at -1.5 -5.5) (size 0.53 0.53) (layers "F.Cu" "F.Paste" "F.Mask") (die_length 15.94497171) (tstamp a7650bf3-ff51-4f28-96bf-43644efae2fc))
  (pad "H13" smd circle (at -0.5 -5.5) (size 0.53 0.53) (layers "F.Cu" "F.Paste" "F.Mask") (die_length 17.57604794) (tstamp f490fa7e-7433-4f69-a0c2-b9828b571293))
  (pad "H14" smd circle (at 0.5 -5.5) (size 0.53 0.53) (layers "F.Cu" "F.Paste" "F.Mask") (die_length 15.77766624) (tstamp 1bd8c5bd-8ede-4915-9169-c211df8b3736))
  (pad "H15" smd circle (at 1.5 -5.5) (size 0.53 0.53) (layers "F.Cu" "F.Paste" "F.Mask") (die_length 0.0) (tstamp db454701-2a27-4efd-9e88-0c7c669ffc1d))
  (pad "H16" smd circle (at 2.5 -5.5) (size 0.53 0.53) (layers "F.Cu" "F.Paste" "F.Mask") (die_length 15.69249255) (tstamp c116b7f4-9c6a-4a5c-91fa-20ba13efa110))
  (pad "H17" smd circle (at 3.5 -5.5) (size 0.53 0.53) (layers "F.Cu" "F.Paste" "F.Mask") (die_length 13.16108475) (tstamp 945ef836-d5aa-4dda-a8bc-a00349f4031d))
  (pad "H18" smd circle (at 4.5 -5.5) (size 0.53 0.53) (layers "F.Cu" "F.Paste" "F.Mask") (die_length 13.07796435) (tstamp 93c76346-d88c-4fc8-b1d1-714b8d785953))
  (pad "H19" smd circle (at 5.5 -5.5) (size 0.53 0.53) (layers "F.Cu" "F.Paste" "F.Mask") (die_length 13.23804526) (tstamp 4213122a-a5e6-4f33-9f3e-df37aa5db062))
  (pad "H20" smd circle (at 6.5 -5.5) (size 0.53 0.53) (layers "F.Cu" "F.Paste" "F.Mask") (die_length 0.0) (tstamp 2f11e4e4-69b5-43cb-be09-e4ea411e5920))
  (pad "H21" smd circle (at 7.5 -5.5) (size 0.53 0.53) (layers "F.Cu" "F.Paste" "F.Mask") (die_length 17.82746243) (tstamp 0325e620-c687-49cb-916b-e84fb4fb8a90))
  (pad "H22" smd circle (at 8.5 -5.5) (size 0.53 0.53) (layers "F.Cu" "F.Paste" "F.Mask") (die_length 20.54860984) (tstamp a0cf13d3-bdd6-4867-92cb-d423b71228a3))
  (pad "H23" smd circle (at 9.5 -5.5) (size 0.53 0.53) (layers "F.Cu" "F.Paste" "F.Mask") (die_length 19.30446554) (tstamp 41617ca4-967c-49e6-8aca-394820ca1906))
  (pad "H24" smd circle (at 10.5 -5.5) (size 0.53 0.53) (layers "F.Cu" "F.Paste" "F.Mask") (die_length 18.59204843) (tstamp e2ae61e6-8efd-43d5-b0b9-3216880dcfe7))
  (pad "H25" smd circle (at 11.5 -5.5) (size 0.53 0.53) (layers "F.Cu" "F.Paste" "F.Mask") (die_length 0.0) (tstamp 7b3bbe35-b7ff-452b-82da-45356327ecba))
  (pad "H26" smd circle (at 12.5 -5.5) (size 0.53 0.53) (layers "F.Cu" "F.Paste" "F.Mask") (die_length 20.65416439) (tstamp e3057808-9e3f-4d6c-8f16-a9bc66972bf1))
  (pad "J1" smd circle (at -12.5 -4.5) (size 0.53 0.53) (layers "F.Cu" "F.Paste" "F.Mask") (die_length 0.0) (tstamp 53370181-7805-4b07-9a6b-7f126b298e00))
  (pad "J2" smd circle (at -11.5 -4.5) (size 0.53 0.53) (layers "F.Cu" "F.Paste" "F.Mask") (die_length 0.0) (tstamp 6a625c18-9381-4b41-b366-1a13819b7522))
  (pad "J3" smd circle (at -10.5 -4.5) (size 0.53 0.53) (layers "F.Cu" "F.Paste" "F.Mask") (die_length 12.1508639) (tstamp 58d1639e-5b85-4a73-b037-6502a3193efb))
  (pad "J4" smd circle (at -9.5 -4.5) (size 0.53 0.53) (layers "F.Cu" "F.Paste" "F.Mask") (die_length 12.1511681) (tstamp 999d19f0-20f3-4173-9b05-c49ce4eff7f0))
  (pad "J5" smd circle (at -8.5 -4.5) (size 0.53 0.53) (layers "F.Cu" "F.Paste" "F.Mask") (die_length 0.0) (tstamp 9ff4a0fe-5c2e-42d8-a816-9369ef367c3d))
  (pad "J6" smd circle (at -7.5 -4.5) (size 0.53 0.53) (layers "F.Cu" "F.Paste" "F.Mask") (die_length 0.0) (tstamp eeb646e3-f419-4c47-b96b-f13879bf5adf))
  (pad "J7" smd circle (at -6.5 -4.5) (size 0.53 0.53) (layers "F.Cu" "F.Paste" "F.Mask") (die_length 18.86186652) (tstamp 0f9c3956-5208-47d7-8924-517a6e20165c))
  (pad "J8" smd circle (at -5.5 -4.5) (size 0.53 0.53) (layers "F.Cu" "F.Paste" "F.Mask") (die_length 16.9167123) (tstamp ff582ae9-bff7-4d06-b378-2eaccda34387))
  (pad "J9" smd circle (at -4.5 -4.5) (size 0.53 0.53) (layers "F.Cu" "F.Paste" "F.Mask") (die_length 0.0) (tstamp d1ccb2e0-dba5-4027-92d2-d126994d433b))
  (pad "J10" smd circle (at -3.5 -4.5) (size 0.53 0.53) (layers "F.Cu" "F.Paste" "F.Mask") (die_length 15.93523757) (tstamp ab28727d-4437-4aeb-8f44-935d6fa9f9dc))
  (pad "J11" smd circle (at -2.5 -4.5) (size 0.53 0.53) (layers "F.Cu" "F.Paste" "F.Mask") (die_length 15.62374521) (tstamp 48c359cf-db29-469a-89c5-da1d8469b423))
  (pad "J12" smd circle (at -1.5 -4.5) (size 0.53 0.53) (layers "F.Cu" "F.Paste" "F.Mask") (die_length 0.0) (tstamp c8a26bff-d27f-4cda-bced-818b534f5860))
  (pad "J13" smd circle (at -0.5 -4.5) (size 0.53 0.53) (layers "F.Cu" "F.Paste" "F.Mask") (die_length 17.49802275) (tstamp b7c37311-aa08-4fe9-b799-1340361997b0))
  (pad "J14" smd circle (at 0.5 -4.5) (size 0.53 0.53) (layers "F.Cu" "F.Paste" "F.Mask") (die_length 15.15962463) (tstamp 8b9a3d85-57b0-4e59-8e97-b5642154f2ca))
  (pad "J15" smd circle (at 1.5 -4.5) (size 0.53 0.53) (layers "F.Cu" "F.Paste" "F.Mask") (die_length 14.97863053) (tstamp 117a09e6-af51-422d-bfb5-c226d14c0514))
  (pad "J16" smd circle (at 2.5 -4.5) (size 0.53 0.53) (layers "F.Cu" "F.Paste" "F.Mask") (die_length 14.81832147) (tstamp e4bf37cf-b930-4d84-b604-b12d1b2ce90f))
  (pad "J17" smd circle (at 3.5 -4.5) (size 0.53 0.53) (layers "F.Cu" "F.Paste" "F.Mask") (die_length 0.0) (tstamp 2f05343d-51d2-4808-9742-c2d638cbc2cb))
  (pad "J18" smd circle (at 4.5 -4.5) (size 0.53 0.53) (layers "F.Cu" "F.Paste" "F.Mask") (die_length 12.80890673) (tstamp 41623774-bd12-42db-9f40-8616f4060ed2))
  (pad "J19" smd circle (at 5.5 -4.5) (size 0.53 0.53) (layers "F.Cu" "F.Paste" "F.Mask") (die_length 12.65605037) (tstamp 87a22e24-2118-460a-843c-023dc761b369))
  (pad "J20" smd circle (at 6.5 -4.5) (size 0.53 0.53) (layers "F.Cu" "F.Paste" "F.Mask") (die_length 10.34244388) (tstamp 00c64b21-62ee-45db-9ee0-075e072183d9))
  (pad "J21" smd circle (at 7.5 -4.5) (size 0.53 0.53) (layers "F.Cu" "F.Paste" "F.Mask") (die_length 20.66648415) (tstamp 1ebee301-68df-42d0-b583-3fa7e3cb0891))
  (pad "J22" smd circle (at 8.5 -4.5) (size 0.53 0.53) (layers "F.Cu" "F.Paste" "F.Mask") (die_length 0.0) (tstamp bb6d90be-bb54-4563-9133-29ae4532734a))
  (pad "J23" smd circle (at 9.5 -4.5) (size 0.53 0.53) (layers "F.Cu" "F.Paste" "F.Mask") (die_length 18.5302975) (tstamp e86c4970-4a00-4eab-aef5-5649067d321a))
  (pad "J24" smd circle (at 10.5 -4.5) (size 0.53 0.53) (layers "F.Cu" "F.Paste" "F.Mask") (die_length 18.04176553) (tstamp 22ff0039-3837-41b1-83e0-707d9f4bfddc))
  (pad "J25" smd circle (at 11.5 -4.5) (size 0.53 0.53) (layers "F.Cu" "F.Paste" "F.Mask") (die_length 18.44314656) (tstamp e7eb94d4-6efd-45c0-bac7-07631f262f1b))
  (pad "J26" smd circle (at 12.5 -4.5) (size 0.53 0.53) (layers "F.Cu" "F.Paste" "F.Mask") (die_length 22.52129342) (tstamp d2828444-b577-442d-bee1-ff8853da767b))
  (pad "K1" smd circle (at -12.5 -3.5) (size 0.53 0.53) (layers "F.Cu" "F.Paste" "F.Mask") (die_length 13.84848208) (tstamp 7bfbae9e-a6a3-4ae8-9a77-0728fd7326a5))
  (pad "K2" smd circle (at -11.5 -3.5) (size 0.53 0.53) (layers "F.Cu" "F.Paste" "F.Mask") (die_length 13.79015331) (tstamp 4ebc0846-3e5a-407a-98d0-86fe12e96321))
  (pad "K3" smd circle (at -10.5 -3.5) (size 0.53 0.53) (layers "F.Cu" "F.Paste" "F.Mask") (die_length 0.0) (tstamp e09190ce-b6bf-4ec9-8e3d-0d22988c39ee))
  (pad "K4" smd circle (at -9.5 -3.5) (size 0.53 0.53) (layers "F.Cu" "F.Paste" "F.Mask") (die_length 0.0) (tstamp b2d11163-37a9-478c-982e-1e4fb7e98ac0))
  (pad "K5" smd circle (at -8.5 -3.5) (size 0.53 0.53) (layers "F.Cu" "F.Paste" "F.Mask") (die_length 12.21094178) (tstamp 6b0577a6-73c0-4188-aef9-96be5d879687))
  (pad "K6" smd circle (at -7.5 -3.5) (size 0.53 0.53) (layers "F.Cu" "F.Paste" "F.Mask") (die_length 11.88598893) (tstamp b033141f-8665-463f-82b3-51e030ebc4e7))
  (pad "K7" smd circle (at -6.5 -3.5) (size 0.53 0.53) (layers "F.Cu" "F.Paste" "F.Mask") (die_length 0.0) (tstamp 509a8b08-a011-420b-9901-705c2cf6dcd5))
  (pad "K8" smd circle (at -5.5 -3.5) (size 0.53 0.53) (layers "F.Cu" "F.Paste" "F.Mask") (die_length 0.0) (tstamp 1e695d18-643c-4017-be99-d10bc71a22a3))
  (pad "K9" smd circle (at -4.5 -3.5) (size 0.53 0.53) (layers "F.Cu" "F.Paste" "F.Mask") (die_length 0.0) (tstamp e88c7bd8-1999-4718-a748-344617dcfe8e))
  (pad "K10" smd circle (at -3.5 -3.5) (size 0.53 0.53) (layers "F.Cu" "F.Paste" "F.Mask") (die_length 0.0) (tstamp ca042ed2-c738-411e-9580-423de48fabdb))
  (pad "K11" smd circle (at -2.5 -3.5) (size 0.53 0.53) (layers "F.Cu" "F.Paste" "F.Mask") (die_length 0.0) (tstamp 69e750bf-e726-48e3-a800-e866a53091e2))
  (pad "K12" smd circle (at -1.5 -3.5) (size 0.53 0.53) (layers "F.Cu" "F.Paste" "F.Mask") (die_length 0.0) (tstamp a8719682-da97-475c-aafa-5dfd20b29471))
  (pad "K13" smd circle (at -0.5 -3.5) (size 0.53 0.53) (layers "F.Cu" "F.Paste" "F.Mask") (die_length 0.0) (tstamp 1bca330c-9b9a-4f70-bcf5-deb89e4d5ec2))
  (pad "K14" smd circle (at 0.5 -3.5) (size 0.53 0.53) (layers "F.Cu" "F.Paste" "F.Mask") (die_length 0.0) (tstamp e6edd56a-b1f7-4f8d-bb4c-928877d1062c))
  (pad "K15" smd circle (at 1.5 -3.5) (size 0.53 0.53) (layers "F.Cu" "F.Paste" "F.Mask") (die_length 7.215504654) (tstamp 081c85f5-8e17-45f2-a9d9-504f23cc2337))
  (pad "K16" smd circle (at 2.5 -3.5) (size 0.53 0.53) (layers "F.Cu" "F.Paste" "F.Mask") (die_length 6.988501551) (tstamp 42df5015-9836-4ae6-ac9c-a8e32a218195))
  (pad "K17" smd circle (at 3.5 -3.5) (size 0.53 0.53) (layers "F.Cu" "F.Paste" "F.Mask") (die_length 7.665632415) (tstamp 0c416189-1aa9-4086-9673-ffc1bbbddeb9))
  (pad "K18" smd circle (at 4.5 -3.5) (size 0.53 0.53) (layers "F.Cu" "F.Paste" "F.Mask") (die_length 9.040122893) (tstamp f49a38e7-ec8f-4f8d-b933-da2860ebfe8c))
  (pad "K19" smd circle (at 5.5 -3.5) (size 0.53 0.53) (layers "F.Cu" "F.Paste" "F.Mask") (die_length 0.0) (tstamp 515d9b95-4bc1-4306-a0f4-be56f90dd2e0))
  (pad "K20" smd circle (at 6.5 -3.5) (size 0.53 0.53) (layers "F.Cu" "F.Paste" "F.Mask") (die_length 9.570557279) (tstamp 00b1b9bb-3a1c-4058-9915-a7ec36d46bdc))
  (pad "K21" smd circle (at 7.5 -3.5) (size 0.53 0.53) (layers "F.Cu" "F.Paste" "F.Mask") (die_length 11.27038085) (tstamp bf33b086-cc23-4458-92fc-2ab9a44ead4e))
  (pad "K22" smd circle (at 8.5 -3.5) (size 0.53 0.53) (layers "F.Cu" "F.Paste" "F.Mask") (die_length 17.0198333) (tstamp d38c03de-b49a-46b2-9d0d-b8d4990a02b8))
  (pad "K23" smd circle (at 9.5 -3.5) (size 0.53 0.53) (layers "F.Cu" "F.Paste" "F.Mask") (die_length 17.27307295) (tstamp e91c648c-a491-4095-9562-7064462d4baa))
  (pad "K24" smd circle (at 10.5 -3.5) (size 0.53 0.53) (layers "F.Cu" "F.Paste" "F.Mask") (die_length 0.0) (tstamp 3a6e49e8-b042-4d0b-a75b-d07160710f80))
  (pad "K25" smd circle (at 11.5 -3.5) (size 0.53 0.53) (layers "F.Cu" "F.Paste" "F.Mask") (die_length 17.68114619) (tstamp b3e7ed20-b0c8-4a86-bad2-d3127d012b21))
  (pad "K26" smd circle (at 12.5 -3.5) (size 0.53 0.53) (layers "F.Cu" "F.Paste" "F.Mask") (die_length 18.91859828) (tstamp 0af775ad-113d-43aa-abdd-543b4077c463))
  (pad "L1" smd circle (at -12.5 -2.5) (size 0.53 0.53) (layers "F.Cu" "F.Paste" "F.Mask") (die_length 0.0) (tstamp 85718143-252e-4810-8724-3bf57e4c8bab))
  (pad "L2" smd circle (at -11.5 -2.5) (size 0.53 0.53) (layers "F.Cu" "F.Paste" "F.Mask") (die_length 0.0) (tstamp d297a491-44ad-42e3-a40c-562400c555d4))
  (pad "L3" smd circle (at -10.5 -2.5) (size 0.53 0.53) (layers "F.Cu" "F.Paste" "F.Mask") (die_length 12.54920302) (tstamp b15c8b21-e9bb-4c31-8ac5-be1a3e2b8aa9))
  (pad "L4" smd circle (at -9.5 -2.5) (size 0.53 0.53) (layers "F.Cu" "F.Paste" "F.Mask") (die_length 12.55118026) (tstamp 0348ba87-fd61-4409-a364-f584fe95777e))
  (pad "L5" smd circle (at -8.5 -2.5) (size 0.53 0.53) (layers "F.Cu" "F.Paste" "F.Mask") (die_length 0.0) (tstamp 83656b48-de84-4784-8942-a2e4320bc1cb))
  (pad "L6" smd circle (at -7.5 -2.5) (size 0.53 0.53) (layers "F.Cu" "F.Paste" "F.Mask") (die_length 0.0) (tstamp 5fa9067f-b353-41cf-b359-9082bb6f56ad))
  (pad "L7" smd circle (at -6.5 -2.5) (size 0.53 0.53) (layers "F.Cu" "F.Paste" "F.Mask") (die_length 0.0) (tstamp 11417707-610e-4586-b485-b413efb4f63d))
  (pad "L8" smd circle (at -5.5 -2.5) (size 0.53 0.53) (layers "F.Cu" "F.Paste" "F.Mask") (die_length 15.15589828) (tstamp 658c56d1-3c71-432f-976f-1958e407bfca))
  (pad "L9" smd circle (at -4.5 -2.5) (size 0.53 0.53) (layers "F.Cu" "F.Paste" "F.Mask") (die_length 0.0) (tstamp c55da6f4-77c0-451d-aca6-69f266add9e8))
  (pad "L10" smd circle (at -3.5 -2.5) (size 0.53 0.53) (layers "F.Cu" "F.Paste" "F.Mask") (die_length 0.0) (tstamp f29369f5-3c40-4405-afa1-083fc7fb8b4c))
  (pad "L11" smd circle (at -2.5 -2.5) (size 0.53 0.53) (layers "F.Cu" "F.Paste" "F.Mask") (die_length 0.0) (tstamp c95c12a7-f35a-4874-b535-5b76cfd61748))
  (pad "L12" smd circle (at -1.5 -2.5) (size 0.53 0.53) (layers "F.Cu" "F.Paste" "F.Mask") (die_length 0.0) (tstamp bae3c574-9c47-4af7-8235-95bf62267ba7))
  (pad "L13" smd circle (at -0.5 -2.5) (size 0.53 0.53) (layers "F.Cu" "F.Paste" "F.Mask") (die_length 0.0) (tstamp 530ac053-a6c5-42e7-bbdc-4af8f1ea2f8d))
  (pad "L14" smd circle (at 0.5 -2.5) (size 0.53 0.53) (layers "F.Cu" "F.Paste" "F.Mask") (die_length 0.0) (tstamp 08d18b34-e600-4ebe-ac1b-8318f81c3e9d))
  (pad "L15" smd circle (at 1.5 -2.5) (size 0.53 0.53) (layers "F.Cu" "F.Paste" "F.Mask") (die_length 0.0) (tstamp 895e23c4-540b-4020-8bee-93f782f188d7))
  (pad "L16" smd circle (at 2.5 -2.5) (size 0.53 0.53) (layers "F.Cu" "F.Paste" "F.Mask") (die_length 0.0) (tstamp 2af8101e-4245-4ddc-8fb9-934435e010eb))
  (pad "L17" smd circle (at 3.5 -2.5) (size 0.53 0.53) (layers "F.Cu" "F.Paste" "F.Mask") (die_length 7.312541826) (tstamp df2eb861-bd96-473b-8fc2-6ed985264d41))
  (pad "L18" smd circle (at 4.5 -2.5) (size 0.53 0.53) (layers "F.Cu" "F.Paste" "F.Mask") (die_length 8.153860193) (tstamp 9ba571ed-15ca-4040-b7d8-d86275cbfd65))
  (pad "L19" smd circle (at 5.5 -2.5) (size 0.53 0.53) (layers "F.Cu" "F.Paste" "F.Mask") (die_length 9.21085052) (tstamp 86bbee07-f0ad-4266-bbb3-6de6c8932219))
  (pad "L20" smd circle (at 6.5 -2.5) (size 0.53 0.53) (layers "F.Cu" "F.Paste" "F.Mask") (die_length 8.805058709) (tstamp 2a86ae56-7f3f-4356-af90-c3cfb256a2b0))
  (pad "L21" smd circle (at 7.5 -2.5) (size 0.53 0.53) (layers "F.Cu" "F.Paste" "F.Mask") (die_length 0.0) (tstamp 84e6b9e2-8fde-4788-80f7-13fda826abd5))
  (pad "L22" smd circle (at 8.5 -2.5) (size 0.53 0.53) (layers "F.Cu" "F.Paste" "F.Mask") (die_length 15.867707) (tstamp f18b6c3d-ac9c-4cda-9b21-80865ff37aeb))
  (pad "L23" smd circle (at 9.5 -2.5) (size 0.53 0.53) (layers "F.Cu" "F.Paste" "F.Mask") (die_length 16.0082436) (tstamp d5870853-f2a5-4089-8ada-c5af16c703fb))
  (pad "L24" smd circle (at 10.5 -2.5) (size 0.53 0.53) (layers "F.Cu" "F.Paste" "F.Mask") (die_length 18.14808055) (tstamp b5e95091-b83b-4836-8bde-f9cf0475a0ec))
  (pad "L25" smd circle (at 11.5 -2.5) (size 0.53 0.53) (layers "F.Cu" "F.Paste" "F.Mask") (die_length 17.38030054) (tstamp 6b44e206-ff3f-4b14-a03f-9e1b98f53345))
  (pad "L26" smd circle (at 12.5 -2.5) (size 0.53 0.53) (layers "F.Cu" "F.Paste" "F.Mask") (die_length 0.0) (tstamp 922680db-dbf2-4966-9c49-875675985854))
  (pad "M1" smd circle (at -12.5 -1.5) (size 0.53 0.53) (layers "F.Cu" "F.Paste" "F.Mask") (die_length 13.78277666) (tstamp c202a45d-2d81-4c9a-a78e-4fe005f93e2e))
  (pad "M2" smd circle (at -11.5 -1.5) (size 0.53 0.53) (layers "F.Cu" "F.Paste" "F.Mask") (die_length 13.77562816) (tstamp 655fe2d5-8e8e-48d4-8c61-e17108e0b175))
  (pad "M3" smd circle (at -10.5 -1.5) (size 0.53 0.53) (layers "F.Cu" "F.Paste" "F.Mask") (die_length 0.0) (tstamp f037761d-d042-4da9-9fab-d942c9994a30))
  (pad "M4" smd circle (at -9.5 -1.5) (size 0.53 0.53) (layers "F.Cu" "F.Paste" "F.Mask") (die_length 0.0) (tstamp cb76f339-f583-404c-baf3-3e9f6004e3a5))
  (pad "M5" smd circle (at -8.5 -1.5) (size 0.53 0.53) (layers "F.Cu" "F.Paste" "F.Mask") (die_length 0.0) (tstamp 46f86e6e-f496-4557-a882-bb231f2fc627))
  (pad "M6" smd circle (at -7.5 -1.5) (size 0.53 0.53) (layers "F.Cu" "F.Paste" "F.Mask") (die_length 11.82849668) (tstamp 0ee946be-1a5d-4f41-836e-d47be6684f1b))
  (pad "M7" smd circle (at -6.5 -1.5) (size 0.53 0.53) (layers "F.Cu" "F.Paste" "F.Mask") (die_length 0.0) (tstamp 2ddd08d6-fdf9-4e40-9e0c-4f605b49e3db))
  (pad "M8" smd circle (at -5.5 -1.5) (size 0.53 0.53) (layers "F.Cu" "F.Paste" "F.Mask") (die_length 0.0) (tstamp bc0d100e-92c2-411a-9896-43bf0546475a))
  (pad "M9" smd circle (at -4.5 -1.5) (size 0.53 0.53) (layers "F.Cu" "F.Paste" "F.Mask") (die_length 0.0) (tstamp 576d1845-f1c4-4563-baf2-6ff357d96255))
  (pad "M10" smd circle (at -3.5 -1.5) (size 0.53 0.53) (layers "F.Cu" "F.Paste" "F.Mask") (die_length 0.0) (tstamp d5b80a6c-8d52-47cc-b808-4d99fbe2c11c))
  (pad "M11" smd circle (at -2.5 -1.5) (size 0.53 0.53) (layers "F.Cu" "F.Paste" "F.Mask") (die_length 0.0) (tstamp 90b60f45-a9d7-4e92-a8da-332f460316c1))
  (pad "M12" smd circle (at -1.5 -1.5) (size 0.53 0.53) (layers "F.Cu" "F.Paste" "F.Mask") (die_length 0.0) (tstamp a354ce2f-3d4d-4162-8f8d-61ca639630b6))
  (pad "M13" smd circle (at -0.5 -1.5) (size 0.53 0.53) (layers "F.Cu" "F.Paste" "F.Mask") (die_length 0.0) (tstamp 2469cd64-23d4-4f3b-a0c0-b5dbb87514bf))
  (pad "M14" smd circle (at 0.5 -1.5) (size 0.53 0.53) (layers "F.Cu" "F.Paste" "F.Mask") (die_length 0.0) (tstamp 1a720b0c-0293-4c0f-adcd-e1477d3dda19))
  (pad "M15" smd circle (at 1.5 -1.5) (size 0.53 0.53) (layers "F.Cu" "F.Paste" "F.Mask") (die_length 0.0) (tstamp 94937d53-308e-4a65-be7c-fb1df51e05ac))
  (pad "M16" smd circle (at 2.5 -1.5) (size 0.53 0.53) (layers "F.Cu" "F.Paste" "F.Mask") (die_length 5.909837562) (tstamp b0b6da09-19c7-4f66-b64b-711fdfd91ee2))
  (pad "M17" smd circle (at 3.5 -1.5) (size 0.53 0.53) (layers "F.Cu" "F.Paste" "F.Mask") (die_length 8.428241163) (tstamp 14fbd09f-545f-4ef9-b48a-7b66da3bacdf))
  (pad "M18" smd circle (at 4.5 -1.5) (size 0.53 0.53) (layers "F.Cu" "F.Paste" "F.Mask") (die_length 0.0) (tstamp 5eb4af2f-a7cd-4c9b-86ad-92e6115f8921))
  (pad "M19" smd circle (at 5.5 -1.5) (size 0.53 0.53) (layers "F.Cu" "F.Paste" "F.Mask") (die_length 15.30191032) (tstamp fecf6272-9b01-4bba-bf4d-f66fe8254b72))
  (pad "M20" smd circle (at 6.5 -1.5) (size 0.53 0.53) (layers "F.Cu" "F.Paste" "F.Mask") (die_length 12.6549857) (tstamp 20f445be-f700-4f8e-80ce-797114d35c36))
  (pad "M21" smd circle (at 7.5 -1.5) (size 0.53 0.53) (layers "F.Cu" "F.Paste" "F.Mask") (die_length 14.77216037) (tstamp 384a8475-e56d-420e-8281-bb3f1e3f71fe))
  (pad "M22" smd circle (at 8.5 -1.5) (size 0.53 0.53) (layers "F.Cu" "F.Paste" "F.Mask") (die_length 15.60518951) (tstamp bf0a8291-278e-4401-b086-ea01639afa4b))
  (pad "M23" smd circle (at 9.5 -1.5) (size 0.53 0.53) (layers "F.Cu" "F.Paste" "F.Mask") (die_length 0.0) (tstamp c47446c7-fd1f-40d3-accb-f7fcfaae2975))
  (pad "M24" smd circle (at 10.5 -1.5) (size 0.53 0.53) (layers "F.Cu" "F.Paste" "F.Mask") (die_length 16.50232707) (tstamp 25b25af8-a7bf-4bc3-868b-7ccb6c49b1ce))
  (pad "M25" smd circle (at 11.5 -1.5) (size 0.53 0.53) (layers "F.Cu" "F.Paste" "F.Mask") (die_length 16.98348239) (tstamp 626ea250-53e8-42d8-94d6-08c3d0d72f45))
  (pad "M26" smd circle (at 12.5 -1.5) (size 0.53 0.53) (layers "F.Cu" "F.Paste" "F.Mask") (die_length 17.23109448) (tstamp d25eee2d-e860-4a9b-998f-d5ad149cd427))
  (pad "N1" smd circle (at -12.5 -0.5) (size 0.53 0.53) (layers "F.Cu" "F.Paste" "F.Mask") (die_length 0.0) (tstamp 5244ed9b-e6cb-40fe-8a30-16cbd658e643))
  (pad "N2" smd circle (at -11.5 -0.5) (size 0.53 0.53) (layers "F.Cu" "F.Paste" "F.Mask") (die_length 0.0) (tstamp 300d0d8c-1fec-4885-b6ce-b84e25470162))
  (pad "N3" smd circle (at -10.5 -0.5) (size 0.53 0.53) (layers "F.Cu" "F.Paste" "F.Mask") (die_length 12.81369776) (tstamp e8a7163c-7812-4954-a25b-d77ef895dcdb))
  (pad "N4" smd circle (at -9.5 -0.5) (size 0.53 0.53) (layers "F.Cu" "F.Paste" "F.Mask") (die_length 12.76799294) (tstamp 31afb286-6cdb-4896-a0a2-5b3d9fd1b70c))
  (pad "N5" smd circle (at -8.5 -0.5) (size 0.53 0.53) (layers "F.Cu" "F.Paste" "F.Mask") (die_length 0.0) (tstamp bd6a9aa9-95f1-48ef-b2c3-b368616b3b95))
  (pad "N6" smd circle (at -7.5 -0.5) (size 0.53 0.53) (layers "F.Cu" "F.Paste" "F.Mask") (die_length 0.0) (tstamp 5b189d18-8bf2-413f-93ee-a37521bc3f55))
  (pad "N7" smd circle (at -6.5 -0.5) (size 0.53 0.53) (layers "F.Cu" "F.Paste" "F.Mask") (die_length 0.0) (tstamp 204798c9-612c-4766-8135-a60461939a38))
  (pad "N8" smd circle (at -5.5 -0.5) (size 0.53 0.53) (layers "F.Cu" "F.Paste" "F.Mask") (die_length 12.96465292) (tstamp 305bc2ed-a9d0-4f7a-9a03-9e129c648e89))
  (pad "N9" smd circle (at -4.5 -0.5) (size 0.53 0.53) (layers "F.Cu" "F.Paste" "F.Mask") (die_length 0.0) (tstamp 9fa01d55-632c-4f15-8333-0e2efb5816f5))
  (pad "N10" smd circle (at -3.5 -0.5) (size 0.53 0.53) (layers "F.Cu" "F.Paste" "F.Mask") (die_length 0.0) (tstamp 2449d312-5818-49ac-9896-b548369bb214))
  (pad "N11" smd circle (at -2.5 -0.5) (size 0.53 0.53) (layers "F.Cu" "F.Paste" "F.Mask") (die_length 16.23060778) (tstamp 358c4380-d7e5-43ba-8129-6b89ad45a0be))
  (pad "N12" smd circle (at -1.5 -0.5) (size 0.53 0.53) (layers "F.Cu" "F.Paste" "F.Mask") (die_length 13.96164142) (tstamp 9ba05bf8-32aa-4b06-8ad4-ed6be77e0fef))
  (pad "N13" smd circle (at -0.5 -0.5) (size 0.53 0.53) (layers "F.Cu" "F.Paste" "F.Mask") (die_length 0.0) (tstamp a95e8421-d10b-42af-afcf-d018365c745e))
  (pad "N14" smd circle (at 0.5 -0.5) (size 0.53 0.53) (layers "F.Cu" "F.Paste" "F.Mask") (die_length 0.0) (tstamp 3c43d612-bd09-4ec1-8741-3eb3a071300f))
  (pad "N15" smd circle (at 1.5 -0.5) (size 0.53 0.53) (layers "F.Cu" "F.Paste" "F.Mask") (die_length 0.0) (tstamp c1867923-343d-4b4e-9ea6-e951a96adf7e))
  (pad "N16" smd circle (at 2.5 -0.5) (size 0.53 0.53) (layers "F.Cu" "F.Paste" "F.Mask") (die_length 7.532472471) (tstamp 8727d50e-7ce7-4366-9f7b-1229bf870034))
  (pad "N17" smd circle (at 3.5 -0.5) (size 0.53 0.53) (layers "F.Cu" "F.Paste" "F.Mask") (die_length 10.04669344) (tstamp b489ac5d-ce29-42a1-99b9-49c6fc65bf45))
  (pad "N18" smd circle (at 4.5 -0.5) (size 0.53 0.53) (layers "F.Cu" "F.Paste" "F.Mask") (die_length 13.24625844) (tstamp b0c8d08c-16e2-486b-bb98-d11cddba1983))
  (pad "N19" smd circle (at 5.5 -0.5) (size 0.53 0.53) (layers "F.Cu" "F.Paste" "F.Mask") (die_length 11.38779887) (tstamp 82d92f78-c5f8-4e91-9b7d-e772229df0f3))
  (pad "N20" smd circle (at 6.5 -0.5) (size 0.53 0.53) (layers "F.Cu" "F.Paste" "F.Mask") (die_length 0.0) (tstamp 40a877b0-1624-4209-a4ea-b45488622b68))
  (pad "N21" smd circle (at 7.5 -0.5) (size 0.53 0.53) (layers "F.Cu" "F.Paste" "F.Mask") (die_length 12.86624688) (tstamp f8cdc21a-ddd2-4643-aac8-905c5fe64daa))
  (pad "N22" smd circle (at 8.5 -0.5) (size 0.53 0.53) (layers "F.Cu" "F.Paste" "F.Mask") (die_length 13.3658058) (tstamp 8bee5c3a-9398-43d1-a248-11823e811497))
  (pad "N23" smd circle (at 9.5 -0.5) (size 0.53 0.53) (layers "F.Cu" "F.Paste" "F.Mask") (die_length 15.21095699) (tstamp 566884dd-9ade-4f4b-bab6-0e50ea74cfbc))
  (pad "N24" smd circle (at 10.5 -0.5) (size 0.53 0.53) (layers "F.Cu" "F.Paste" "F.Mask") (die_length 15.73218957) (tstamp 617ed3e3-a972-42eb-851e-61c936eea2a5))
  (pad "N25" smd circle (at 11.5 -0.5) (size 0.53 0.53) (layers "F.Cu" "F.Paste" "F.Mask") (die_length 0.0) (tstamp b7ec1d89-6228-4f73-a66e-1ad43a7078be))
  (pad "N26" smd circle (at 12.5 -0.5) (size 0.53 0.53) (layers "F.Cu" "F.Paste" "F.Mask") (die_length 18.07005536) (tstamp 2d1ac2ca-b386-497e-a529-2ef844430718))
  (pad "P1" smd circle (at -12.5 0.5) (size 0.53 0.53) (layers "F.Cu" "F.Paste" "F.Mask") (die_length 14.99847904) (tstamp c1e5f155-648d-412b-a802-6678d7f1022d))
  (pad "P2" smd circle (at -11.5 0.5) (size 0.53 0.53) (layers "F.Cu" "F.Paste" "F.Mask") (die_length 14.9833455) (tstamp 36e3e7a9-4b62-44e3-83ae-6128f4847678))
  (pad "P3" smd circle (at -10.5 0.5) (size 0.53 0.53) (layers "F.Cu" "F.Paste" "F.Mask") (die_length 0.0) (tstamp 790d0c90-5d0b-43fc-bbf3-3ca57db0c959))
  (pad "P4" smd circle (at -9.5 0.5) (size 0.53 0.53) (layers "F.Cu" "F.Paste" "F.Mask") (die_length 0.0) (tstamp 6f5b99fd-5e25-4345-910a-4de260e741fe))
  (pad "P5" smd circle (at -8.5 0.5) (size 0.53 0.53) (layers "F.Cu" "F.Paste" "F.Mask") (die_length 16.75518647) (tstamp 7dc1e5c0-359e-4a48-9226-c14116a05dfb))
  (pad "P6" smd circle (at -7.5 0.5) (size 0.53 0.53) (layers "F.Cu" "F.Paste" "F.Mask") (die_length 16.01706516) (tstamp 2c83960e-42cb-4932-9614-0814cac0fb61))
  (pad "P7" smd circle (at -6.5 0.5) (size 0.53 0.53) (layers "F.Cu" "F.Paste" "F.Mask") (die_length 16.01280647) (tstamp 4c82e41f-a427-44cc-bbec-e72762407423))
  (pad "P8" smd circle (at -5.5 0.5) (size 0.53 0.53) (layers "F.Cu" "F.Paste" "F.Mask") (die_length 0.0) (tstamp bc07a98b-72eb-415a-b577-cdfc38bfbd51))
  (pad "P9" smd circle (at -4.5 0.5) (size 0.53 0.53) (layers "F.Cu" "F.Paste" "F.Mask") (die_length 0.0) (tstamp 382538b4-1761-47f6-9ff7-7d18a3cafd83))
  (pad "P10" smd circle (at -3.5 0.5) (size 0.53 0.53) (layers "F.Cu" "F.Paste" "F.Mask") (die_length 0.0) (tstamp e2bf717f-1b6f-4a1f-b888-f557a0d2d0ed))
  (pad "P11" smd circle (at -2.5 0.5) (size 0.53 0.53) (layers "F.Cu" "F.Paste" "F.Mask") (die_length 14.71588489) (tstamp 005b9dd3-f277-4397-b6d1-05df5e290e50))
  (pad "P12" smd circle (at -1.5 0.5) (size 0.53 0.53) (layers "F.Cu" "F.Paste" "F.Mask") (die_length 13.3307477) (tstamp 86e5b413-811f-4830-afb9-f8b3fc2a87cf))
  (pad "P13" smd circle (at -0.5 0.5) (size 0.53 0.53) (layers "F.Cu" "F.Paste" "F.Mask") (die_length 0.0) (tstamp 9f24f947-56ac-4103-9ccb-981a2a0b1d05))
  (pad "P14" smd circle (at 0.5 0.5) (size 0.53 0.53) (layers "F.Cu" "F.Paste" "F.Mask") (die_length 0.0) (tstamp 1b83f16a-bc5d-4322-833b-95818076495c))
  (pad "P15" smd circle (at 1.5 0.5) (size 0.53 0.53) (layers "F.Cu" "F.Paste" "F.Mask") (die_length 0.0) (tstamp 11b9c1d6-f4c8-4137-ab66-96fb1e59ef48))
  (pad "P16" smd circle (at 2.5 0.5) (size 0.53 0.53) (layers "F.Cu" "F.Paste" "F.Mask") (die_length 8.204127882) (tstamp 9c9cddd7-657f-4095-9696-20f153f17d69))
  (pad "P17" smd circle (at 3.5 0.5) (size 0.53 0.53) (layers "F.Cu" "F.Paste" "F.Mask") (die_length 0.0) (tstamp 0fb6a4d0-5d2b-4c7e-83c9-86f9d79b1480))
  (pad "P18" smd circle (at 4.5 0.5) (size 0.53 0.53) (layers "F.Cu" "F.Paste" "F.Mask") (die_length 11.15927481) (tstamp 50d02875-9249-44dd-8107-6128c724f1a2))
  (pad "P19" smd circle (at 5.5 0.5) (size 0.53 0.53) (layers "F.Cu" "F.Paste" "F.Mask") (die_length 13.29044229) (tstamp af647d57-2cfd-41d4-be7f-db9c12b948bf))
  (pad "P20" smd circle (at 6.5 0.5) (size 0.53 0.53) (layers "F.Cu" "F.Paste" "F.Mask") (die_length 13.16199732) (tstamp 2630b3b3-b7cb-47b5-80a2-7ca6c2f76764))
  (pad "P21" smd circle (at 7.5 0.5) (size 0.53 0.53) (layers "F.Cu" "F.Paste" "F.Mask") (die_length 10.65203504) (tstamp 9f947903-c250-47a2-b6e8-940d468275bd))
  (pad "P22" smd circle (at 8.5 0.5) (size 0.53 0.53) (layers "F.Cu" "F.Paste" "F.Mask") (die_length 0.0) (tstamp bea4371e-279c-485c-840f-2f8e2ba3c6b4))
  (pad "P23" smd circle (at 9.5 0.5) (size 0.53 0.53) (layers "F.Cu" "F.Paste" "F.Mask") (die_length 14.78371966) (tstamp 293244df-e34b-4d0b-93cb-ce433ab1a180))
  (pad "P24" smd circle (at 10.5 0.5) (size 0.53 0.53) (layers "F.Cu" "F.Paste" "F.Mask") (die_length 13.7239916) (tstamp 013f4a72-e2e4-4fd0-9bba-70957ece172f))
  (pad "P25" smd circle (at 11.5 0.5) (size 0.53 0.53) (layers "F.Cu" "F.Paste" "F.Mask") (die_length 15.14692462) (tstamp 9c7d7b82-386f-4fca-8474-8b3caee502e4))
  (pad "P26" smd circle (at 12.5 0.5) (size 0.53 0.53) (layers "F.Cu" "F.Paste" "F.Mask") (die_length 18.31858003) (tstamp 23c1f8e5-0358-448e-a94d-d0102f37c18f))
  (pad "R1" smd circle (at -12.5 1.5) (size 0.53 0.53) (layers "F.Cu" "F.Paste" "F.Mask") (die_length 0.0) (tstamp 88f78a29-31b3-41d8-9a1d-a8123269658d))
  (pad "R2" smd circle (at -11.5 1.5) (size 0.53 0.53) (layers "F.Cu" "F.Paste" "F.Mask") (die_length 0.0) (tstamp 578c60cb-9ac4-4773-9dd1-a9ee295feb61))
  (pad "R3" smd circle (at -10.5 1.5) (size 0.53 0.53) (layers "F.Cu" "F.Paste" "F.Mask") (die_length 13.81905153) (tstamp 475f5f37-d8bb-4150-9d04-afd33ddbe3d1))
  (pad "R4" smd circle (at -9.5 1.5) (size 0.53 0.53) (layers "F.Cu" "F.Paste" "F.Mask") (die_length 13.81273955) (tstamp 0340e942-2721-452d-abb0-577b0655d123))
  (pad "R5" smd circle (at -8.5 1.5) (size 0.53 0.53) (layers "F.Cu" "F.Paste" "F.Mask") (die_length 0.0) (tstamp c9a31a82-c111-4f49-820b-cbef74dd2e01))
  (pad "R6" smd circle (at -7.5 1.5) (size 0.53 0.53) (layers "F.Cu" "F.Paste" "F.Mask") (die_length 17.33117357) (tstamp 6430dbf6-b621-4815-9a3f-88e859548cae))
  (pad "R7" smd circle (at -6.5 1.5) (size 0.53 0.53) (layers "F.Cu" "F.Paste" "F.Mask") (die_length 16.82712782) (tstamp 4e13c900-bb96-40d9-8add-4dd27a943602))
  (pad "R8" smd circle (at -5.5 1.5) (size 0.53 0.53) (layers "F.Cu" "F.Paste" "F.Mask") (die_length 0.0) (tstamp 0700f0a4-9c17-4cd8-b154-c04ffce47e35))
  (pad "R9" smd circle (at -4.5 1.5) (size 0.53 0.53) (layers "F.Cu" "F.Paste" "F.Mask") (die_length 0.0) (tstamp 9ebfb6ce-b50b-400b-b10c-9e3c7fe059cf))
  (pad "R10" smd circle (at -3.5 1.5) (size 0.53 0.53) (layers "F.Cu" "F.Paste" "F.Mask") (die_length 0.0) (tstamp 667d8d04-69cc-4d45-b546-ee9aaecb7420))
  (pad "R11" smd circle (at -2.5 1.5) (size 0.53 0.53) (layers "F.Cu" "F.Paste" "F.Mask") (die_length 15.64823265) (tstamp 96a9f90b-0e7c-4c9a-8f36-72083fefc341))
  (pad "R12" smd circle (at -1.5 1.5) (size 0.53 0.53) (layers "F.Cu" "F.Paste" "F.Mask") (die_length 13.83996471) (tstamp 0971ce74-7c53-4e01-8ade-bf6433173c64))
  (pad "R13" smd circle (at -0.5 1.5) (size 0.53 0.53) (layers "F.Cu" "F.Paste" "F.Mask") (die_length 0.0) (tstamp fbab0af2-dc54-4639-9e6d-8602dc2098e7))
  (pad "R14" smd circle (at 0.5 1.5) (size 0.53 0.53) (layers "F.Cu" "F.Paste" "F.Mask") (die_length 0.0) (tstamp e14bcdf3-d83d-413c-a88b-4535f399abc5))
  (pad "R15" smd circle (at 1.5 1.5) (size 0.53 0.53) (layers "F.Cu" "F.Paste" "F.Mask") (die_length 0.0) (tstamp 1dd8640a-d501-48bf-9552-9e70694b6224))
  (pad "R16" smd circle (at 2.5 1.5) (size 0.53 0.53) (layers "F.Cu" "F.Paste" "F.Mask") (die_length 10.17072763) (tstamp faf65632-e5f2-4d69-aa82-7e9cf2421c52))
  (pad "R17" smd circle (at 3.5 1.5) (size 0.53 0.53) (layers "F.Cu" "F.Paste" "F.Mask") (die_length 10.13985216) (tstamp c0d1ae8e-5158-4ac6-b79c-fb0281799b52))
  (pad "R18" smd circle (at 4.5 1.5) (size 0.53 0.53) (layers "F.Cu" "F.Paste" "F.Mask") (die_length 9.75185557) (tstamp 46e4a8fd-37ac-4e6b-97b9-390c9b7c523f))
  (pad "R19" smd circle (at 5.5 1.5) (size 0.53 0.53) (layers "F.Cu" "F.Paste" "F.Mask") (die_length 0.0) (tstamp 2edaa47f-4714-4687-9158-84293c632a7a))
  (pad "R20" smd circle (at 6.5 1.5) (size 0.53 0.53) (layers "F.Cu" "F.Paste" "F.Mask") (die_length 9.370170956) (tstamp 90cb5632-06c7-40f8-b242-584070d5c7df))
  (pad "R21" smd circle (at 7.5 1.5) (size 0.53 0.53) (layers "F.Cu" "F.Paste" "F.Mask") (die_length 10.75827402) (tstamp ca173f47-724f-44cb-a46b-092f947436ef))
  (pad "R22" smd circle (at 8.5 1.5) (size 0.53 0.53) (layers "F.Cu" "F.Paste" "F.Mask") (die_length 12.58182758) (tstamp 287a9971-2436-4b1b-9912-bddd1d5690e5))
  (pad "R23" smd circle (at 9.5 1.5) (size 0.53 0.53) (layers "F.Cu" "F.Paste" "F.Mask") (die_length 13.11370688) (tstamp 352f1b5a-575b-41ba-a6ff-e2e08ff2df54))
  (pad "R24" smd circle (at 10.5 1.5) (size 0.53 0.53) (layers "F.Cu" "F.Paste" "F.Mask") (die_length 0.0) (tstamp 34ef56d9-8d44-403c-89cc-3bb9a3df7f10))
  (pad "R25" smd circle (at 11.5 1.5) (size 0.53 0.53) (layers "F.Cu" "F.Paste" "F.Mask") (die_length 14.47739855) (tstamp 146e493d-e058-4192-841a-964a82decc03))
  (pad "R26" smd circle (at 12.5 1.5) (size 0.53 0.53) (layers "F.Cu" "F.Paste" "F.Mask") (die_length 16.86180568) (tstamp e32ea0fb-bdbe-4855-84af-3f83958485fb))
  (pad "T1" smd circle (at -12.5 2.5) (size 0.53 0.53) (layers "F.Cu" "F.Paste" "F.Mask") (die_length 0.0) (tstamp 097fffb9-9c55-4b09-ab85-2887f77b9b0c))
  (pad "T2" smd circle (at -11.5 2.5) (size 0.53 0.53) (layers "F.Cu" "F.Paste" "F.Mask") (die_length 24.51025126) (tstamp 1de6aea6-dd41-4474-b112-11f39b27b284))
  (pad "T3" smd circle (at -10.5 2.5) (size 0.53 0.53) (layers "F.Cu" "F.Paste" "F.Mask") (die_length 0.0) (tstamp 3f948c4e-ca32-4182-a147-d3785dad7d3f))
  (pad "T4" smd circle (at -9.5 2.5) (size 0.53 0.53) (layers "F.Cu" "F.Paste" "F.Mask") (die_length 0.0) (tstamp ee2afd0a-7fcb-453a-a8a3-3d03c95f9927))
  (pad "T5" smd circle (at -8.5 2.5) (size 0.53 0.53) (layers "F.Cu" "F.Paste" "F.Mask") (die_length 22.70274381) (tstamp d25ef938-6667-452d-a3e0-cf3d720af123))
  (pad "T6" smd circle (at -7.5 2.5) (size 0.53 0.53) (layers "F.Cu" "F.Paste" "F.Mask") (die_length 0.0) (tstamp 178ab821-b2a3-41ff-a549-6f7f09fadbda))
  (pad "T7" smd circle (at -6.5 2.5) (size 0.53 0.53) (layers "F.Cu" "F.Paste" "F.Mask") (die_length 9.659229178) (tstamp f938ddcf-c99a-4050-b990-f47e9a18b7cd))
  (pad "T8" smd circle (at -5.5 2.5) (size 0.53 0.53) (layers "F.Cu" "F.Paste" "F.Mask") (die_length 0.0) (tstamp cc906b20-7e8c-49b8-8454-167d005bec2a))
  (pad "T9" smd circle (at -4.5 2.5) (size 0.53 0.53) (layers "F.Cu" "F.Paste" "F.Mask") (die_length 0.0) (tstamp d5663014-3a7d-456c-a735-2bbcd018f552))
  (pad "T10" smd circle (at -3.5 2.5) (size 0.53 0.53) (layers "F.Cu" "F.Paste" "F.Mask") (die_length 0.0) (tstamp 424ae9a0-dac2-4c5c-b0e7-fcc4ddf82945))
  (pad "T11" smd circle (at -2.5 2.5) (size 0.53 0.53) (layers "F.Cu" "F.Paste" "F.Mask") (die_length 0.0) (tstamp 1a32152b-f3b2-4d7a-9c58-a191960cb156))
  (pad "T12" smd circle (at -1.5 2.5) (size 0.53 0.53) (layers "F.Cu" "F.Paste" "F.Mask") (die_length 0.0) (tstamp d51c8912-c5b8-43dd-be29-8d1f888b57be))
  (pad "T13" smd circle (at -0.5 2.5) (size 0.53 0.53) (layers "F.Cu" "F.Paste" "F.Mask") (die_length 0.0) (tstamp 5b0fa667-9f61-4011-bb38-876350bf3ee0))
  (pad "T14" smd circle (at 0.5 2.5) (size 0.53 0.53) (layers "F.Cu" "F.Paste" "F.Mask") (die_length 0.0) (tstamp 3fac20a9-311e-4c60-8b53-9671ccba3c9d))
  (pad "T15" smd circle (at 1.5 2.5) (size 0.53 0.53) (layers "F.Cu" "F.Paste" "F.Mask") (die_length 0.0) (tstamp a57d68e1-ab23-458e-8567-91d97c014218))
  (pad "T16" smd circle (at 2.5 2.5) (size 0.53 0.53) (layers "F.Cu" "F.Paste" "F.Mask") (die_length 0.0) (tstamp a3eaf7bb-9a60-4fc2-9b9b-8ed36bc28e4b))
  (pad "T17" smd circle (at 3.5 2.5) (size 0.53 0.53) (layers "F.Cu" "F.Paste" "F.Mask") (die_length 11.21015088) (tstamp 34a1ed0c-e451-4737-850f-f9bbbe0e099b))
  (pad "T18" smd circle (at 4.5 2.5) (size 0.53 0.53) (layers "F.Cu" "F.Paste" "F.Mask") (die_length 8.931070147) (tstamp 7c965be4-ba45-49c0-8db2-1af00017f37d))
  (pad "T19" smd circle (at 5.5 2.5) (size 0.53 0.53) (layers "F.Cu" "F.Paste" "F.Mask") (die_length 8.248387784) (tstamp ed8e5ba9-27e7-4ca2-b8f2-163585274e75))
  (pad "T20" smd circle (at 6.5 2.5) (size 0.53 0.53) (layers "F.Cu" "F.Paste" "F.Mask") (die_length 9.380057188) (tstamp 543860a6-cad6-43d5-851a-fcf1786a4eee))
  (pad "T21" smd circle (at 7.5 2.5) (size 0.53 0.53) (layers "F.Cu" "F.Paste" "F.Mask") (die_length 0.0) (tstamp c91bf20d-d2d8-417e-910b-68bfd90c5b9e))
  (pad "T22" smd circle (at 8.5 2.5) (size 0.53 0.53) (layers "F.Cu" "F.Paste" "F.Mask") (die_length 11.89572306) (tstamp e951c67d-b83f-4b34-b29d-b1c34771b32b))
  (pad "T23" smd circle (at 9.5 2.5) (size 0.53 0.53) (layers "F.Cu" "F.Paste" "F.Mask") (die_length 12.54965931) (tstamp 0705c056-c7a5-4cc2-89dd-619f9801d61e))
  (pad "T24" smd circle (at 10.5 2.5) (size 0.53 0.53) (layers "F.Cu" "F.Paste" "F.Mask") (die_length 14.26811462) (tstamp 267ea69f-de0f-4f42-bcbd-10bad36650e2))
  (pad "T25" smd circle (at 11.5 2.5) (size 0.53 0.53) (layers "F.Cu" "F.Paste" "F.Mask") (die_length 14.78341547) (tstamp d3d5f918-4fa1-4b56-8903-25132fb233a3))
  (pad "T26" smd circle (at 12.5 2.5) (size 0.53 0.53) (layers "F.Cu" "F.Paste" "F.Mask") (die_length 0.0) (tstamp cc65a029-f2e4-4b6e-abeb-a1f4509361b3))
  (pad "U1" smd circle (at -12.5 3.5) (size 0.53 0.53) (layers "F.Cu" "F.Paste" "F.Mask") (die_length 18.06321105) (tstamp 2199ef9b-0309-47b2-93c8-3916912bd2ed))
  (pad "U2" smd circle (at -11.5 3.5) (size 0.53 0.53) (layers "F.Cu" "F.Paste" "F.Mask") (die_length 16.99656263) (tstamp 89b24330-c4ae-412c-b144-a62324877b68))
  (pad "U3" smd circle (at -10.5 3.5) (size 0.53 0.53) (layers "F.Cu" "F.Paste" "F.Mask") (die_length 0.0) (tstamp 6c2cdf4e-da66-4993-8285-5f561fd38adb))
  (pad "U4" smd circle (at -9.5 3.5) (size 0.53 0.53) (layers "F.Cu" "F.Paste" "F.Mask") (die_length 17.11063454) (tstamp e3fbdf9f-6cad-4404-81fa-5c3ba1d3e604))
  (pad "U5" smd circle (at -8.5 3.5) (size 0.53 0.53) (layers "F.Cu" "F.Paste" "F.Mask") (die_length 13.69927602) (tstamp b011d1d1-cde6-447d-8410-ccf77e7b4bb4))
  (pad "U6" smd circle (at -7.5 3.5) (size 0.53 0.53) (layers "F.Cu" "F.Paste" "F.Mask") (die_length 13.22640993) (tstamp b802213d-1287-4088-9750-2f05f72b7a10))
  (pad "U7" smd circle (at -6.5 3.5) (size 0.53 0.53) (layers "F.Cu" "F.Paste" "F.Mask") (die_length 13.27667762) (tstamp 2417f686-a4fa-4f51-85b1-5969de325ac1))
  (pad "U8" smd circle (at -5.5 3.5) (size 0.53 0.53) (layers "F.Cu" "F.Paste" "F.Mask") (die_length 0.0) (tstamp 40fc3c2a-1505-4a22-95fa-f3aaa7bc84c0))
  (pad "U9" smd circle (at -4.5 3.5) (size 0.53 0.53) (layers "F.Cu" "F.Paste" "F.Mask") (die_length 10.29255643) (tstamp ec4ae87b-86b4-4bbd-9212-0617d89a2bce))
  (pad "U10" smd circle (at -3.5 3.5) (size 0.53 0.53) (layers "F.Cu" "F.Paste" "F.Mask") (die_length 0.0) (tstamp 9f6a4ce3-b98c-4b9e-9dd2-67dc4c9a4464))
  (pad "U11" smd circle (at -2.5 3.5) (size 0.53 0.53) (layers "F.Cu" "F.Paste" "F.Mask") (die_length 0.0) (tstamp 2fb052ec-3a62-4878-a277-d03c85d4f1e1))
  (pad "U12" smd circle (at -1.5 3.5) (size 0.53 0.53) (layers "F.Cu" "F.Paste" "F.Mask") (die_length 0.0) (tstamp 83b577e3-bdb2-4b6b-8898-a3cdb60c7288))
  (pad "U13" smd circle (at -0.5 3.5) (size 0.53 0.53) (layers "F.Cu" "F.Paste" "F.Mask") (die_length 0.0) (tstamp 307902ec-04fc-421c-b745-2790caa0967c))
  (pad "U14" smd circle (at 0.5 3.5) (size 0.53 0.53) (layers "F.Cu" "F.Paste" "F.Mask") (die_length 0.0) (tstamp cfa16e58-0bcc-4c82-9446-be43e263b9f5))
  (pad "U15" smd circle (at 1.5 3.5) (size 0.53 0.53) (layers "F.Cu" "F.Paste" "F.Mask") (die_length 0.0) (tstamp 2d7c9a97-06d2-4e08-a3bc-80171197baa8))
  (pad "U16" smd circle (at 2.5 3.5) (size 0.53 0.53) (layers "F.Cu" "F.Paste" "F.Mask") (die_length 11.16505445) (tstamp eee27ef4-34e0-49a0-8e5b-c2012f5c369c))
  (pad "U17" smd circle (at 3.5 3.5) (size 0.53 0.53) (layers "F.Cu" "F.Paste" "F.Mask") (die_length 11.98500335) (tstamp 4896cf45-ac73-4a79-aea1-e707246bf98b))
  (pad "U18" smd circle (at 4.5 3.5) (size 0.53 0.53) (layers "F.Cu" "F.Paste" "F.Mask") (die_length 0.0) (tstamp 1f08b84f-4fcc-4513-943e-896fe3f51adf))
  (pad "U19" smd circle (at 5.5 3.5) (size 0.53 0.53) (layers "F.Cu" "F.Paste" "F.Mask") (die_length 9.444317698) (tstamp 64b4d767-dda1-467c-9d47-354128d7b310))
  (pad "U20" smd circle (at 6.5 3.5) (size 0.53 0.53) (layers "F.Cu" "F.Paste" "F.Mask") (die_length 9.314579911) (tstamp d29f23d1-1f1c-4d0e-8977-d5b048f2efeb))
  (pad "U21" smd circle (at 7.5 3.5) (size 0.53 0.53) (layers "F.Cu" "F.Paste" "F.Mask") (die_length 9.70493399) (tstamp 3dccff8c-2a48-44a3-b675-ae3eac8d4854))
  (pad "U22" smd circle (at 8.5 3.5) (size 0.53 0.53) (layers "F.Cu" "F.Paste" "F.Mask") (die_length 11.81746973) (tstamp 74df644c-a379-4832-8a4c-b4141d30ce48))
  (pad "U23" smd circle (at 9.5 3.5) (size 0.53 0.53) (layers "F.Cu" "F.Paste" "F.Mask") (die_length 0.0) (tstamp dabfbe89-2903-47b5-a3d2-1ca372d8168c))
  (pad "U24" smd circle (at 10.5 3.5) (size 0.53 0.53) (layers "F.Cu" "F.Paste" "F.Mask") (die_length 12.85080915) (tstamp 25cdc4fd-f3d5-47f1-94ae-f6a034694435))
  (pad "U25" smd circle (at 11.5 3.5) (size 0.53 0.53) (layers "F.Cu" "F.Paste" "F.Mask") (die_length 14.55626027) (tstamp d3684773-1414-4cad-b1d1-4c85922bbbe4))
  (pad "U26" smd circle (at 12.5 3.5) (size 0.53 0.53) (layers "F.Cu" "F.Paste" "F.Mask") (die_length 15.43119182) (tstamp 96d78f8b-4b3b-4af5-9c94-f7c2931f23ef))
  (pad "V1" smd circle (at -12.5 4.5) (size 0.53 0.53) (layers "F.Cu" "F.Paste" "F.Mask") (die_length 20.96352741) (tstamp a53070f8-0d05-408e-83f3-d8408adcfa80))
  (pad "V2" smd circle (at -11.5 4.5) (size 0.53 0.53) (layers "F.Cu" "F.Paste" "F.Mask") (die_length 19.02019833) (tstamp 3bb98d85-a7c7-4a19-a9bc-aba54a04d365))
  (pad "V3" smd circle (at -10.5 4.5) (size 0.53 0.53) (layers "F.Cu" "F.Paste" "F.Mask") (die_length 17.17040823) (tstamp 94397e5b-64a4-4a98-9826-01d94cde473a))
  (pad "V4" smd circle (at -9.5 4.5) (size 0.53 0.53) (layers "F.Cu" "F.Paste" "F.Mask") (die_length 16.28444972) (tstamp 74c13fc5-9e6e-4404-9116-b36b49c09586))
  (pad "V5" smd circle (at -8.5 4.5) (size 0.53 0.53) (layers "F.Cu" "F.Paste" "F.Mask") (die_length 0.0) (tstamp 66dad124-a479-4109-a6ba-97aa17f09e4a))
  (pad "V6" smd circle (at -7.5 4.5) (size 0.53 0.53) (layers "F.Cu" "F.Paste" "F.Mask") (die_length 14.49526982) (tstamp b2993252-b347-400f-891a-2cb5b3696e3b))
  (pad "V7" smd circle (at -6.5 4.5) (size 0.53 0.53) (layers "F.Cu" "F.Paste" "F.Mask") (die_length 12.2599927) (tstamp fdaa6f98-3892-4f1f-88f4-b9140c6515f3))
  (pad "V8" smd circle (at -5.5 4.5) (size 0.53 0.53) (layers "F.Cu" "F.Paste" "F.Mask") (die_length 11.37350186) (tstamp 311077f2-a7c2-481d-b41e-f3c7c60e7ff3))
  (pad "V9" smd circle (at -4.5 4.5) (size 0.53 0.53) (layers "F.Cu" "F.Paste" "F.Mask") (die_length 10.58572124) (tstamp e6e28f65-f167-48ae-b6c8-5c334b4b317e))
  (pad "V10" smd circle (at -3.5 4.5) (size 0.53 0.53) (layers "F.Cu" "F.Paste" "F.Mask") (die_length 0.0) (tstamp a67e915c-c75e-4bb8-b77c-5626ee08fb36))
  (pad "V11" smd circle (at -2.5 4.5) (size 0.53 0.53) (layers "F.Cu" "F.Paste" "F.Mask") (die_length 9.633068686) (tstamp 1a9ec6cd-7fc1-4fd8-b04b-1faf0f6da476))
  (pad "V12" smd circle (at -1.5 4.5) (size 0.53 0.53) (layers "F.Cu" "F.Paste" "F.Mask") (die_length 9.944028716) (tstamp 1a702c41-2f28-43f6-97fc-7b184f22489d))
  (pad "V13" smd circle (at -0.5 4.5) (size 0.53 0.53) (layers "F.Cu" "F.Paste" "F.Mask") (die_length 9.278609235) (tstamp 8f4d0cea-9058-4a70-9f5a-696e3fa5a9e9))
  (pad "V14" smd circle (at 0.5 4.5) (size 0.53 0.53) (layers "F.Cu" "F.Paste" "F.Mask") (die_length 17.67688751) (tstamp 96c9199f-f6f1-4442-b4b2-5558d4fd27b3))
  (pad "V15" smd circle (at 1.5 4.5) (size 0.53 0.53) (layers "F.Cu" "F.Paste" "F.Mask") (die_length 0.0) (tstamp b9eb7c81-49ed-4ccd-86ec-89def46821ef))
  (pad "V16" smd circle (at 2.5 4.5) (size 0.53 0.53) (layers "F.Cu" "F.Paste" "F.Mask") (die_length 24.44104764) (tstamp 23bfff27-f129-447a-9628-0257f3a4f4fe))
  (pad "V17" smd circle (at 3.5 4.5) (size 0.53 0.53) (layers "F.Cu" "F.Paste" "F.Mask") (die_length 22.77666241) (tstamp 70060e27-d240-4fa9-a2ba-9fd3f96c61f6))
  (pad "V18" smd circle (at 4.5 4.5) (size 0.53 0.53) (layers "F.Cu" "F.Paste" "F.Mask") (die_length 18.58672507) (tstamp acb85292-6045-4edc-a7b8-21f690437782))
  (pad "V19" smd circle (at 5.5 4.5) (size 0.53 0.53) (layers "F.Cu" "F.Paste" "F.Mask") (die_length 18.94780069) (tstamp 36022dbe-0c61-4d95-8978-df9472e7540c))
  (pad "V20" smd circle (at 6.5 4.5) (size 0.53 0.53) (layers "F.Cu" "F.Paste" "F.Mask") (die_length 0.0) (tstamp 1c0dcd47-9483-483a-a06d-3617106eae83))
  (pad "V21" smd circle (at 7.5 4.5) (size 0.53 0.53) (layers "F.Cu" "F.Paste" "F.Mask") (die_length 10.00775689) (tstamp 25886e3c-1eab-473e-ba4c-cef0fe6e5c6c))
  (pad "V22" smd circle (at 8.5 4.5) (size 0.53 0.53) (layers "F.Cu" "F.Paste" "F.Mask") (die_length 11.66757924) (tstamp 43f6e186-097c-4cf8-ae76-737ebdc075a0))
  (pad "V23" smd circle (at 9.5 4.5) (size 0.53 0.53) (layers "F.Cu" "F.Paste" "F.Mask") (die_length 13.62703048) (tstamp 433c36c4-5262-458b-9649-ec852c151f38))
  (pad "V24" smd circle (at 10.5 4.5) (size 0.53 0.53) (layers "F.Cu" "F.Paste" "F.Mask") (die_length 14.03989475) (tstamp 37897880-ba16-4911-bb92-3495bdc074a6))
  (pad "V25" smd circle (at 11.5 4.5) (size 0.53 0.53) (layers "F.Cu" "F.Paste" "F.Mask") (die_length 0.0) (tstamp 756b3f09-d29d-4ae2-a595-0d8ca09b22d3))
  (pad "V26" smd circle (at 12.5 4.5) (size 0.53 0.53) (layers "F.Cu" "F.Paste" "F.Mask") (die_length 16.04231307) (tstamp 3d1fe68e-d9e5-43ab-bdfa-2e5a60279716))
  (pad "W1" smd circle (at -12.5 5.5) (size 0.53 0.53) (layers "F.Cu" "F.Paste" "F.Mask") (die_length 19.64105372) (tstamp 157f0298-4d7f-449c-b0af-1433c89c98de))
  (pad "W2" smd circle (at -11.5 5.5) (size 0.53 0.53) (layers "F.Cu" "F.Paste" "F.Mask") (die_length 0.0) (tstamp 01a12fbe-f1d5-43d6-a839-7a309ecab92c))
  (pad "W3" smd circle (at -10.5 5.5) (size 0.53 0.53) (layers "F.Cu" "F.Paste" "F.Mask") (die_length 19.41945002) (tstamp f3e12f86-9e24-46c2-b342-cfb14679b0f7))
  (pad "W4" smd circle (at -9.5 5.5) (size 0.53 0.53) (layers "F.Cu" "F.Paste" "F.Mask") (die_length 15.52229726) (tstamp 860f8eb7-22b2-47fa-bfac-33982f6699f4))
  (pad "W5" smd circle (at -8.5 5.5) (size 0.53 0.53) (layers "F.Cu" "F.Paste" "F.Mask") (die_length 17.66928272) (tstamp cc64226c-63a9-480e-923b-3729a3f03920))
  (pad "W6" smd circle (at -7.5 5.5) (size 0.53 0.53) (layers "F.Cu" "F.Paste" "F.Mask") (die_length 18.13180629) (tstamp 1cad641f-4f85-4b61-975f-315c8dddde20))
  (pad "W7" smd circle (at -6.5 5.5) (size 0.53 0.53) (layers "F.Cu" "F.Paste" "F.Mask") (die_length 0.0) (tstamp f6af14d2-9399-4a8b-aa84-cd993cca3902))
  (pad "W8" smd circle (at -5.5 5.5) (size 0.53 0.53) (layers "F.Cu" "F.Paste" "F.Mask") (die_length 10.80063272) (tstamp 718a89ab-c4d7-4d65-acdf-b811c598d2fd))
  (pad "W9" smd circle (at -4.5 5.5) (size 0.53 0.53) (layers "F.Cu" "F.Paste" "F.Mask") (die_length 12.73643305) (tstamp 538a579b-cc0a-4ede-8952-1f28270789d5))
  (pad "W10" smd circle (at -3.5 5.5) (size 0.53 0.53) (layers "F.Cu" "F.Paste" "F.Mask") (die_length 12.97476729) (tstamp 5dd417e6-4bd2-4bc2-b0d8-6340e0202c1c))
  (pad "W11" smd circle (at -2.5 5.5) (size 0.53 0.53) (layers "F.Cu" "F.Paste" "F.Mask") (die_length 10.46693436) (tstamp 0006bfe9-ecbb-44ed-a32e-215609f6583a))
  (pad "W12" smd circle (at -1.5 5.5) (size 0.53 0.53) (layers "F.Cu" "F.Paste" "F.Mask") (die_length 0.0) (tstamp f7af0786-e552-494a-89d9-4cc3723a410a))
  (pad "W13" smd circle (at -0.5 5.5) (size 0.53 0.53) (layers "F.Cu" "F.Paste" "F.Mask") (die_length 9.877106528) (tstamp b4dd98c4-75d6-45d8-a2f6-c45cf0fcac78))
  (pad "W14" smd circle (at 0.5 5.5) (size 0.53 0.53) (layers "F.Cu" "F.Paste" "F.Mask") (die_length 17.44554967) (tstamp 081331c7-3bb6-440b-8eae-aa9ccc431898))
  (pad "W15" smd circle (at 1.5 5.5) (size 0.53 0.53) (layers "F.Cu" "F.Paste" "F.Mask") (die_length 17.86807203) (tstamp f3ebc389-16c4-4590-819b-69cbd3c2e308))
  (pad "W16" smd circle (at 2.5 5.5) (size 0.53 0.53) (layers "F.Cu" "F.Paste" "F.Mask") (die_length 17.73772586) (tstamp 25ac6e49-b2f8-4267-a755-2191a609792c))
  (pad "W17" smd circle (at 3.5 5.5) (size 0.53 0.53) (layers "F.Cu" "F.Paste" "F.Mask") (die_length 0.0) (tstamp ca09d572-76bb-4a86-b5a9-59e5c6b8f6ed))
  (pad "W18" smd circle (at 4.5 5.5) (size 0.53 0.53) (layers "F.Cu" "F.Paste" "F.Mask") (die_length 19.47329196) (tstamp 0c8030ed-fac0-4cbc-bb68-64fbe814e102))
  (pad "W19" smd circle (at 5.5 5.5) (size 0.53 0.53) (layers "F.Cu" "F.Paste" "F.Mask") (die_length 19.30157571) (tstamp b65a93a2-e38f-4505-a641-14ebe2aa1c11))
  (pad "W20" smd circle (at 6.5 5.5) (size 0.53 0.53) (layers "F.Cu" "F.Paste" "F.Mask") (die_length 11.58308998) (tstamp d3164164-f986-4882-ad25-4d113edeadd1))
  (pad "W21" smd circle (at 7.5 5.5) (size 0.53 0.53) (layers "F.Cu" "F.Paste" "F.Mask") (die_length 10.73926203) (tstamp 3581ae90-a989-46a7-ae53-8ca8ee1c4bee))
  (pad "W22" smd circle (at 8.5 5.5) (size 0.53 0.53) (layers "F.Cu" "F.Paste" "F.Mask") (die_length 0.0) (tstamp b85dbabe-672e-4c4d-aa33-37d0654c3d57))
  (pad "W23" smd circle (at 9.5 5.5) (size 0.53 0.53) (layers "F.Cu" "F.Paste" "F.Mask") (die_length 14.77254061) (tstamp eb091d68-0a80-4537-bb35-cb3a55e01cfa))
  (pad "W24" smd circle (at 10.5 5.5) (size 0.53 0.53) (layers "F.Cu" "F.Paste" "F.Mask") (die_length 14.80927176) (tstamp 6bb6fd53-d6cc-4263-8cca-9fbd0a67a35f))
  (pad "W25" smd circle (at 11.5 5.5) (size 0.53 0.53) (layers "F.Cu" "F.Paste" "F.Mask") (die_length 14.80212326) (tstamp 049f4b6e-3010-4239-b164-67fdc0e63163))
  (pad "W26" smd circle (at 12.5 5.5) (size 0.53 0.53) (layers "F.Cu" "F.Paste" "F.Mask") (die_length 16.48673724) (tstamp bce717ba-f4df-4f4a-8088-555bffed1607))
  (pad "Y1" smd circle (at -12.5 6.5) (size 0.53 0.53) (layers "F.Cu" "F.Paste" "F.Mask") (die_length 20.74861593) (tstamp d6f39580-b59d-4ecc-afb4-0fed17de310e))
  (pad "Y2" smd circle (at -11.5 6.5) (size 0.53 0.53) (layers "F.Cu" "F.Paste" "F.Mask") (die_length 19.97840238) (tstamp b9d1a4ad-5dc9-47c2-aab0-a77924651328))
  (pad "Y3" smd circle (at -10.5 6.5) (size 0.53 0.53) (layers "F.Cu" "F.Paste" "F.Mask") (die_length 18.6889335) (tstamp d4be74b5-a817-48d0-9486-d94208281c6c))
  (pad "Y4" smd circle (at -9.5 6.5) (size 0.53 0.53) (layers "F.Cu" "F.Paste" "F.Mask") (die_length 0.0) (tstamp 274abbee-a58b-4d9f-8d38-02be08a55bb2))
  (pad "Y5" smd circle (at -8.5 6.5) (size 0.53 0.53) (layers "F.Cu" "F.Paste" "F.Mask") (die_length 16.54073128) (tstamp ac40c191-abd0-4888-9acc-87de5174b3eb))
  (pad "Y6" smd circle (at -7.5 6.5) (size 0.53 0.53) (layers "F.Cu" "F.Paste" "F.Mask") (die_length 19.07981992) (tstamp ef9b98aa-6b87-41e4-a0ff-1f5ff076edd1))
  (pad "Y7" smd circle (at -6.5 6.5) (size 0.53 0.53) (layers "F.Cu" "F.Paste" "F.Mask") (die_length 14.01860133) (tstamp bfe1d8a9-66d8-47e9-a43d-1625d9c7e7be))
  (pad "Y8" smd circle (at -5.5 6.5) (size 0.53 0.53) (layers "F.Cu" "F.Paste" "F.Mask") (die_length 13.51896636) (tstamp e1df0f3a-9670-4383-8d5d-eeb65505f3a6))
  (pad "Y9" smd circle (at -4.5 6.5) (size 0.53 0.53) (layers "F.Cu" "F.Paste" "F.Mask") (die_length 0.0) (tstamp acfb707f-be80-4d12-9720-5486a0e593f8))
  (pad "Y10" smd circle (at -3.5 6.5) (size 0.53 0.53) (layers "F.Cu" "F.Paste" "F.Mask") (die_length 14.73877532) (tstamp 45426656-78c8-4189-a82a-ee7100be1021))
  (pad "Y11" smd circle (at -2.5 6.5) (size 0.53 0.53) (layers "F.Cu" "F.Paste" "F.Mask") (die_length 15.38100018) (tstamp bdcc0491-a7dd-4b53-b931-fef48a6642dd))
  (pad "Y12" smd circle (at -1.5 6.5) (size 0.53 0.53) (layers "F.Cu" "F.Paste" "F.Mask") (die_length 22.50243353) (tstamp 22e1caf3-320c-46d9-95bc-4931baf69be3))
  (pad "Y13" smd circle (at -0.5 6.5) (size 0.53 0.53) (layers "F.Cu" "F.Paste" "F.Mask") (die_length 22.70137495) (tstamp 34e5fc29-a90f-41a8-9781-e23cfb73b435))
  (pad "Y14" smd circle (at 0.5 6.5) (size 0.53 0.53) (layers "F.Cu" "F.Paste" "F.Mask") (die_length 0.0) (tstamp 4ab1c54e-0910-4dc3-909a-7968acbafb74))
  (pad "Y15" smd circle (at 1.5 6.5) (size 0.53 0.53) (layers "F.Cu" "F.Paste" "F.Mask") (die_length 17.12782138) (tstamp 1f2855b8-185d-46d4-ad3e-988824eecde9))
  (pad "Y16" smd circle (at 2.5 6.5) (size 0.53 0.53) (layers "F.Cu" "F.Paste" "F.Mask") (die_length 17.1678226) (tstamp 4dda8581-8ede-4faf-a8ee-21a9471217ea))
  (pad "Y17" smd circle (at 3.5 6.5) (size 0.53 0.53) (layers "F.Cu" "F.Paste" "F.Mask") (die_length 21.35091562) (tstamp 72d66fe5-eacc-4855-b307-1cadd4a6719a))
  (pad "Y18" smd circle (at 4.5 6.5) (size 0.53 0.53) (layers "F.Cu" "F.Paste" "F.Mask") (die_length 21.56065584) (tstamp 2aa20161-76a7-4fd0-a7f7-181e6af42caf))
  (pad "Y19" smd circle (at 5.5 6.5) (size 0.53 0.53) (layers "F.Cu" "F.Paste" "F.Mask") (die_length 0.0) (tstamp 00e869c0-cd2c-4292-9993-93e494745f06))
  (pad "Y20" smd circle (at 6.5 6.5) (size 0.53 0.53) (layers "F.Cu" "F.Paste" "F.Mask") (die_length 9.366368559) (tstamp a2344785-b73e-4742-a283-ccce22427b3a))
  (pad "Y21" smd circle (at 7.5 6.5) (size 0.53 0.53) (layers "F.Cu" "F.Paste" "F.Mask") (die_length 11.34346292) (tstamp 4f77c752-3636-466b-a1c4-afe17c597efb))
  (pad "Y22" smd circle (at 8.5 6.5) (size 0.53 0.53) (layers "F.Cu" "F.Paste" "F.Mask") (die_length 12.04462493) (tstamp 609c1209-741d-4bd3-972c-ecfbb7d7ccd5))
  (pad "Y23" smd circle (at 9.5 6.5) (size 0.53 0.53) (layers "F.Cu" "F.Paste" "F.Mask") (die_length 14.81261787) (tstamp f9766dd5-a09d-4cf5-96c6-4ba6a1b97351))
  (pad "Y24" smd circle (at 10.5 6.5) (size 0.53 0.53) (layers "F.Cu" "F.Paste" "F.Mask") (die_length 0.0) (tstamp 346ae018-f47c-44bd-ba74-03fb26cb22e7))
  (pad "Y25" smd circle (at 11.5 6.5) (size 0.53 0.53) (layers "F.Cu" "F.Paste" "F.Mask") (die_length 15.04844254) (tstamp 9b825fc7-b86b-4f88-b505-643193172a32))
  (pad "Y26" smd circle (at 12.5 6.5) (size 0.53 0.53) (layers "F.Cu" "F.Paste" "F.Mask") (die_length 16.39167731) (tstamp a80fe5b8-e3cf-46ec-9e39-4618b5fceeb4))
