Jordan-HT/Capstone/Documentation/FPGA/FFG676 Package Dimensions.pdf

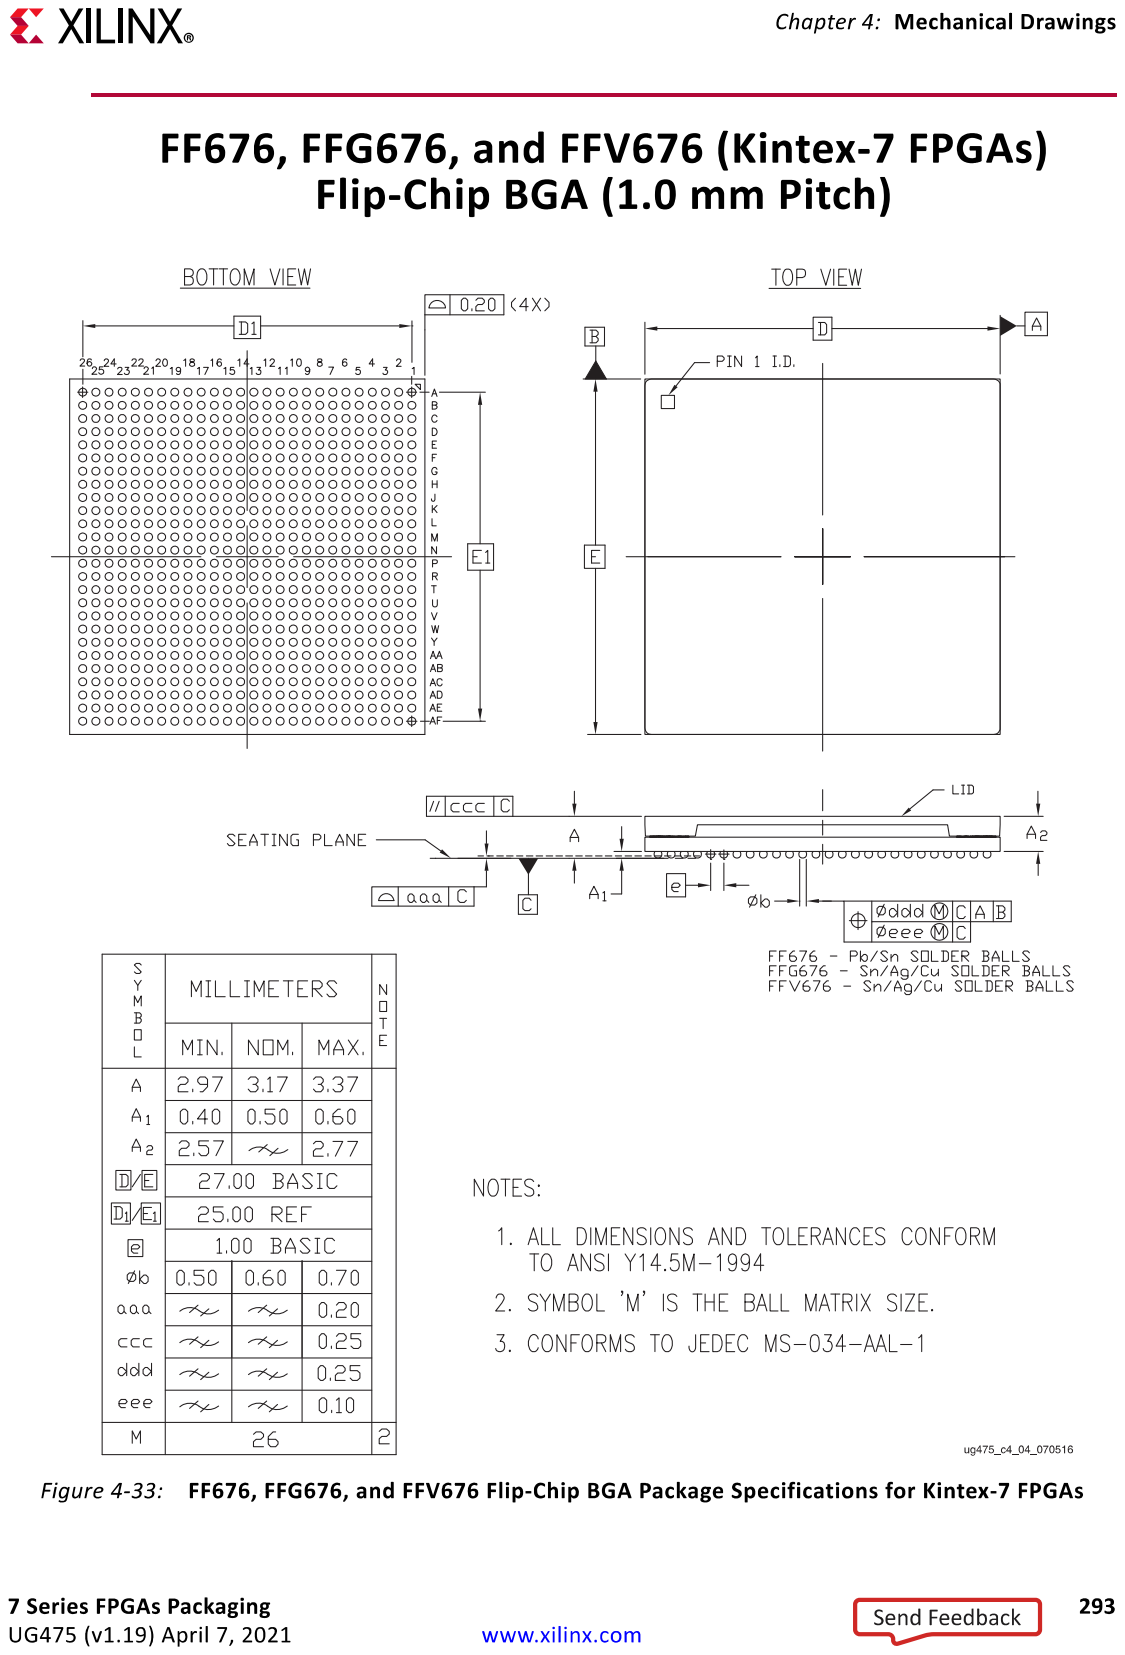
[picture p22: page 1]
