Jordan-HT/Capstone/(list of files, drawings)

Other design files:
Altium/Capstone_Mainboard/Capstone_Mainboard.PrjPcb
Altium/Capstone_Mainboard/Capstone_PCB_Library.PcbLib
Altium/Capstone_Mainboard/Capstone_Schematic_Library.SchLib
Altium/Capstone_Mainboard/FPGA_Configuration_JTAG.SchDoc
Altium/Capstone_Mainboard/FPGA_FLASH.SchDoc
Altium/Capstone_Mainboard/FPGA_GTXqs.SchDoc
Altium/Capstone_Mainboard/FPGA_HPCC_A_BG33-34-35.SchDoc
Altium/Capstone_Mainboard/FPGA_HPCC_B_BG13-15-16.SchDoc
Altium/Capstone_Mainboard/FPGA_Power.SchDoc
Altium/Capstone_Mainboard/HPCC_Connector_A.SchDoc
Altium/Capstone_Mainboard/HPCC_Connector_B.SchDoc
Altium/Capstone_Mainboard/I2C_Switch_I2C_EEPROM.SchDoc
Altium/Capstone_Mainboard/Main_PCB.PcbDoc
Altium/Capstone_Mainboard/Misc_Functions.SchDoc
Altium/Capstone_Mainboard/QSFP_Cages_Connectors.SchDoc
Altium/Capstone_Mainboard_B/Capstone_Mainboard_B.PrjPcb
Altium/Capstone_Mainboard_B/FGPA_Configuration.SchDoc
Altium/Capstone_Mainboard_B/Flash_FPGA.SchDoc
Altium/Capstone_Mainboard_B/FPGA_GTXs.SchDoc
Altium/Capstone_Mainboard_B/FPGA_HPCC_A_DPs.SchDoc
Altium/Capstone_Mainboard_B/FPGA_HPCC_B_DPs.SchDoc
Altium/Capstone_Mainboard_B/FPGA_Power.SchDoc
Altium/Capstone_Mainboard_B/HPCC_Connector_A.SchDoc
Altium/Capstone_Mainboard_B/HPCC_Connector_B.SchDoc
Altium/Capstone_Mainboard_B/I2C_Switch_EEPROM.SchDoc
Altium/Capstone_Mainboard_B/I2C_Temperature_Sensors.SchDoc
Altium/Capstone_Mainboard_B/Main_Board.PcbDoc
Altium/Capstone_Mainboard_B/Management_RP2040.SchDoc
Altium/Capstone_Mainboard_B/Management_RP2040_Support.SchDoc
Altium/Capstone_Mainboard_B/Miscellaneous_Functions.SchDoc
Altium/Capstone_Mainboard_B/Overview_Sheet.SchDoc
Altium/Capstone_Mainboard_B/PMIC_1V0.SchDoc
Altium/Capstone_Mainboard_B/PMIC_1V8.SchDoc
Altium/Capstone_Mainboard_B/PMIC_2V5.SchDoc
Altium/Capstone_Mainboard_B/PMIC_3V3.SchDoc
Altium/Capstone_Mainboard_B/PMIC_3V3AUX_PWR-DEF.SchDoc
Altium/Capstone_Mainboard_B/PMIC_GTXs.SchDoc
Altium/Capstone_Mainboard_B/Power_Input_Indicators.SchDoc
Altium/Capstone_Mainboard_B/QSFP_Connectors.SchDoc
