Jordan-HT/Capstone/KiCad/Capstone_Project_Mainboard/FPGA_Bank_0.kicad_sch

## KiCad design KiCad/Capstone_Project_Mainboard/FPGA_Bank_0.kicad_sch (2023-12-28, an earlier design)

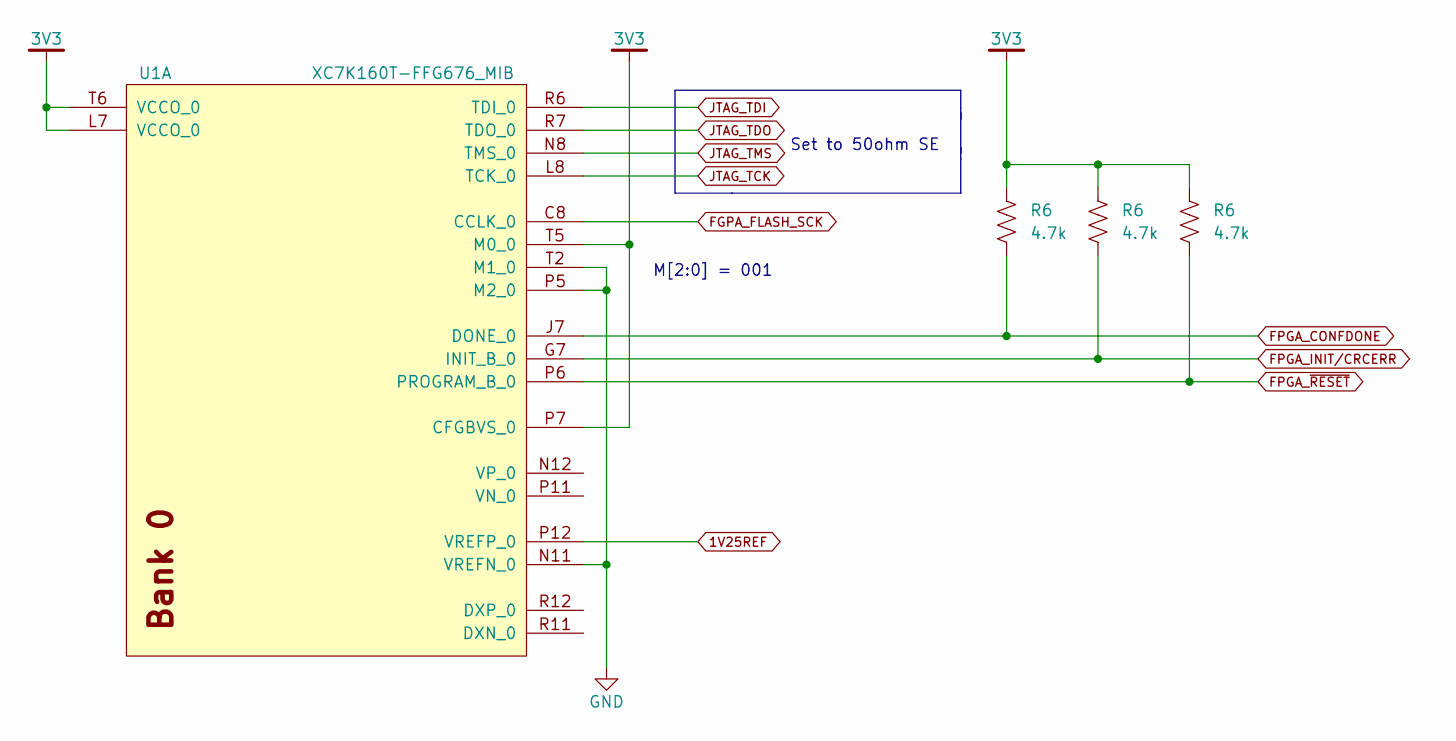
[picture p23: schematic FPGA_Bank_0.kicad_sch]

Parts:
R6: 4.7k
U1: XC7K160T-FFG676_MIB; Xilinx_FFG676_MOD

Connections:
1V25REF: U1.P12 (VREFP_0)
3V3: R6.1, U1.L7 (VCCO_0), U1.P7 (CFGBVS_0), U1.T5 (M0_0), U1.T6 (VCCO_0)
FGPA_FLASH_SCK: U1.C8 (CCLK_0)
FPGA_CONFDONE: R6.2, U1.J7 (DONE_0)
FPGA_INIT/CRCERR: R6.2, U1.G7 (INIT_B_0)
FPGA_~RESET: R6.2, U1.P6 (PROGRAM_B_0)
GND: U1.N11 (VREFN_0), U1.P5 (M2_0), U1.T2 (M1_0)
JTAG_TCK: U1.L8 (TCK_0)
JTAG_TDI: U1.R6 (TDI_0)
JTAG_TDO: U1.R7 (TDO_0)
JTAG_TMS: U1.N8 (TMS_0)

Notes on the sheet:
Set to 50ohm SE
M[2:0] = 001
