Jordan-HT/Capstone/KiCad/Capstone_Project_Mainboard/FPGA_Banks_12_14.kicad_sch

## KiCad design KiCad/Capstone_Project_Mainboard/FPGA_Banks_12_14.kicad_sch (2023-12-28, an earlier design)

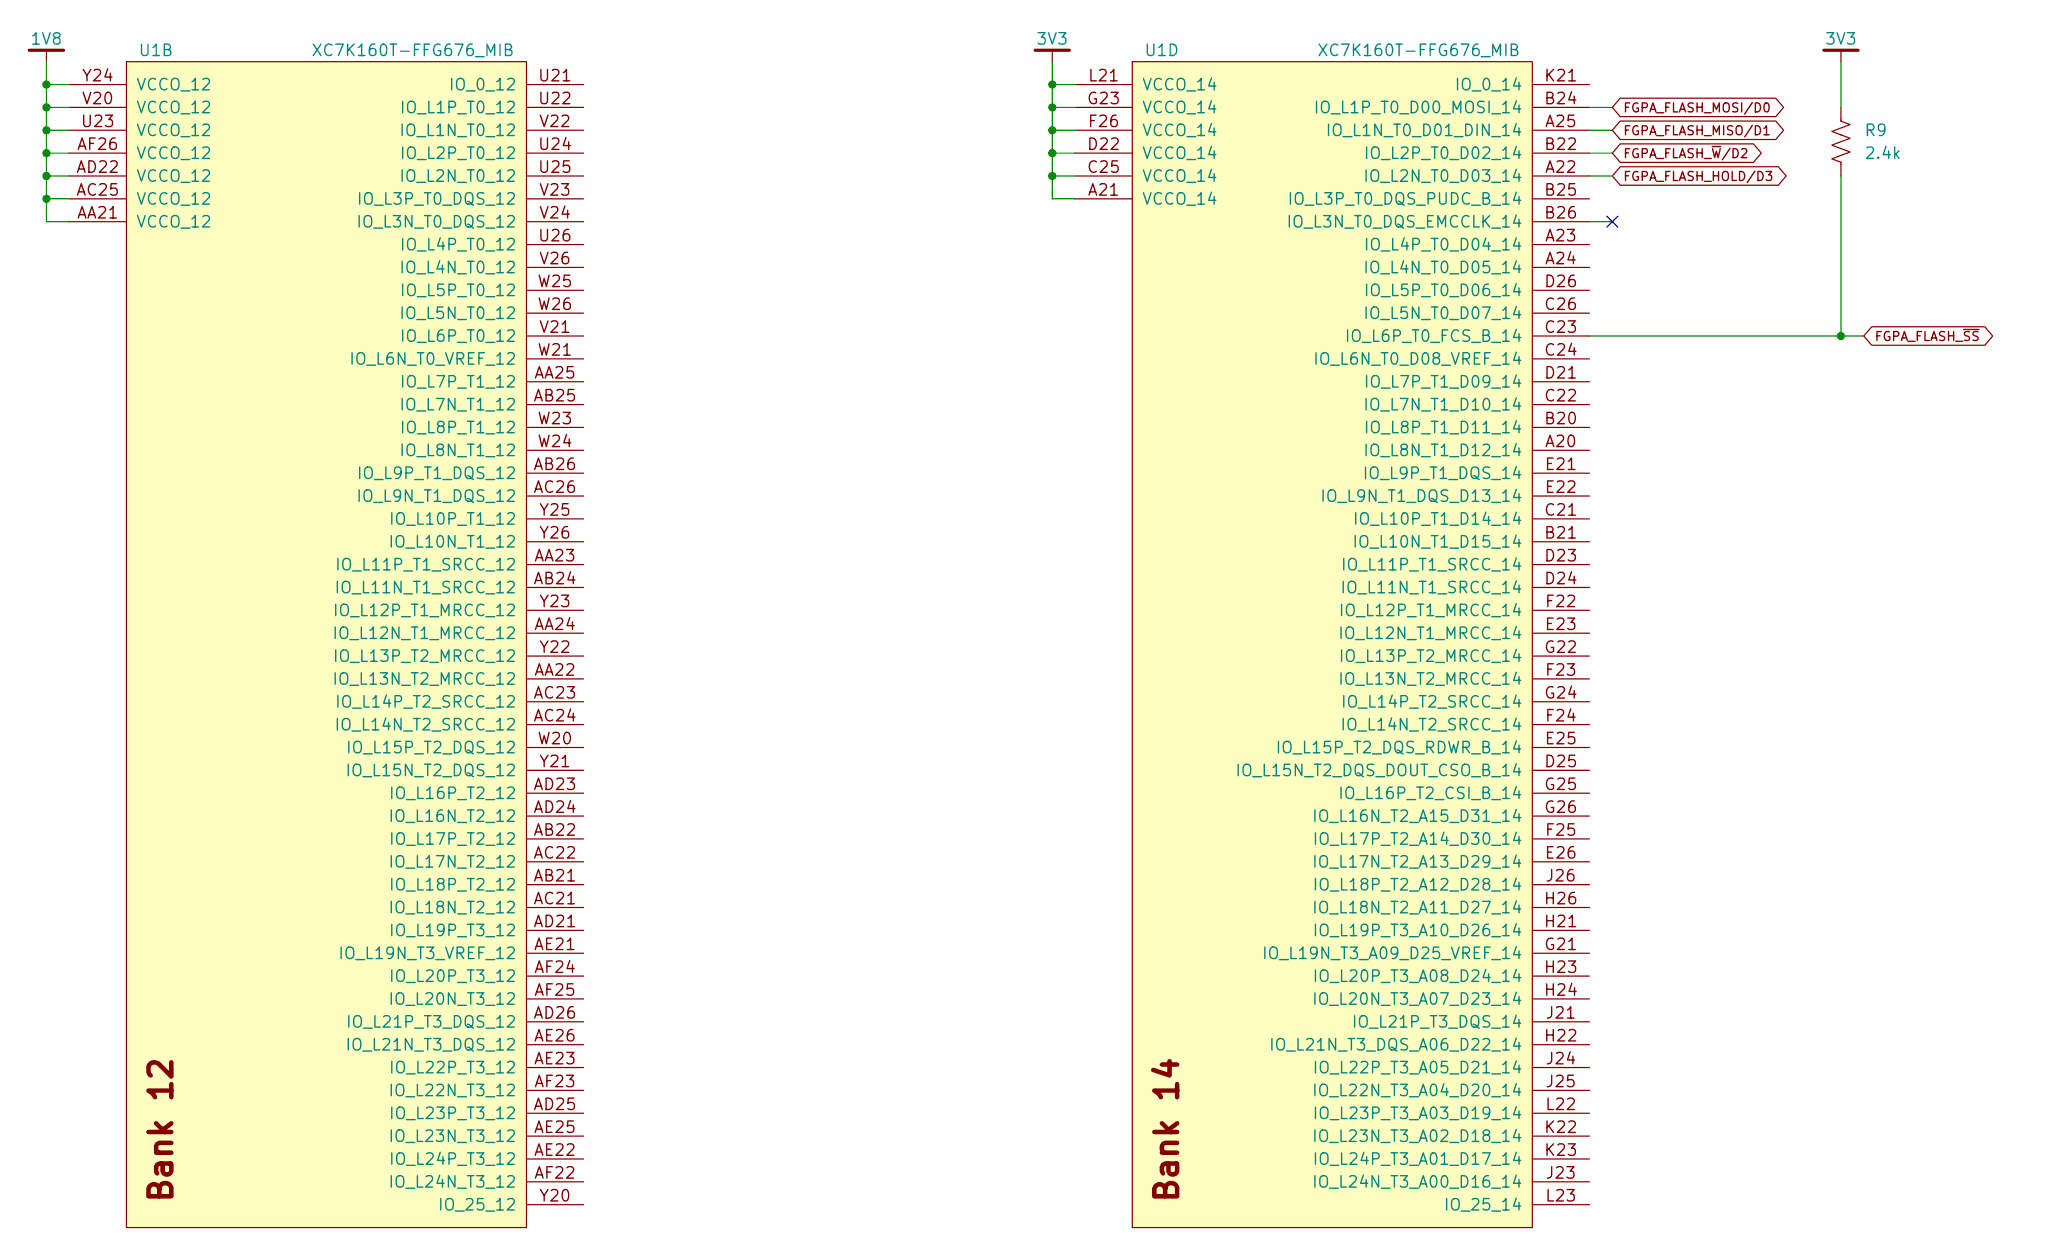
[picture p24: schematic FPGA_Banks_12_14.kicad_sch]

Parts:
R9: 2.4k
U1: XC7K160T-FFG676_MIB; Xilinx_FFG676_MOD

Connections:
1V8: U1.AA21 (VCCO_12), U1.AC25 (VCCO_12), U1.AD22 (VCCO_12), U1.AF26 (VCCO_12), U1.U23 (VCCO_12), U1.V20 (VCCO_12), U1.Y24 (VCCO_12)
3V3: R9.1, U1.A21 (VCCO_14), U1.C25 (VCCO_14), U1.D22 (VCCO_14), U1.F26 (VCCO_14), U1.G23 (VCCO_14), U1.L21 (VCCO_14)
FGPA_FLASH_HOLD/D3: U1.A22 (IO_L2N_T0_D03_14)
FGPA_FLASH_MISO/D1: U1.A25 (IO_L1N_T0_D01_DIN_14)
FGPA_FLASH_MOSI/D0: U1.B24 (IO_L1P_T0_D00_MOSI_14)
FGPA_FLASH_~SS: R9.2, U1.C23 (IO_L6P_T0_FCS_B_14)
FGPA_FLASH_~W/D2: U1.B22 (IO_L2P_T0_D02_14)
