Jordan-HT/Capstone/KiCad/Capstone_Project_Mainboard/FPGA_Banks_115_116.kicad_sch

## KiCad design KiCad/Capstone_Project_Mainboard/FPGA_Banks_115_116.kicad_sch (2023-12-28, an earlier design)

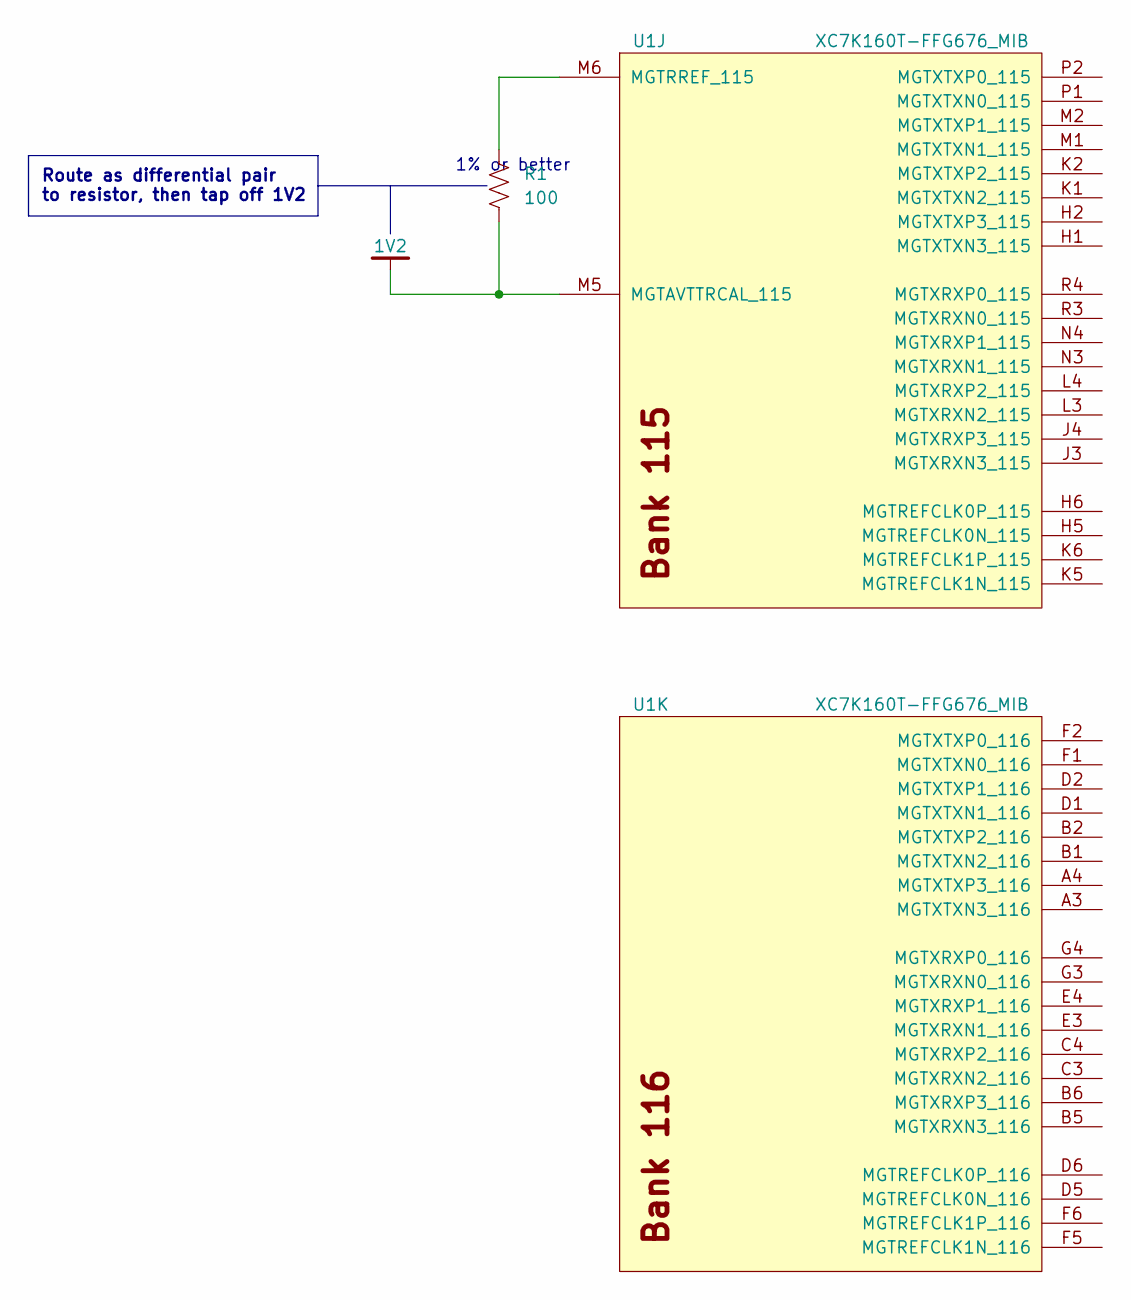
[picture p25: schematic FPGA_Banks_115_116.kicad_sch]

Parts:
R1: 100
U1: XC7K160T-FFG676_MIB; Xilinx_FFG676_MOD

Connections:
1V2: R1.2, U1.M5 (MGTAVTTRCAL_115)
unnamed: R1.1, U1.M6 (MGTRREF_115)

Notes on the sheet:
1% or better
Route as differential pair to resistor, then tap off 1V2
