Jordan-HT/Capstone/KiCad/Capstone_Project_Mainboard/FPGA_Decoupling.kicad_sch

## KiCad design KiCad/Capstone_Project_Mainboard/FPGA_Decoupling.kicad_sch (2023-12-28, an earlier design)

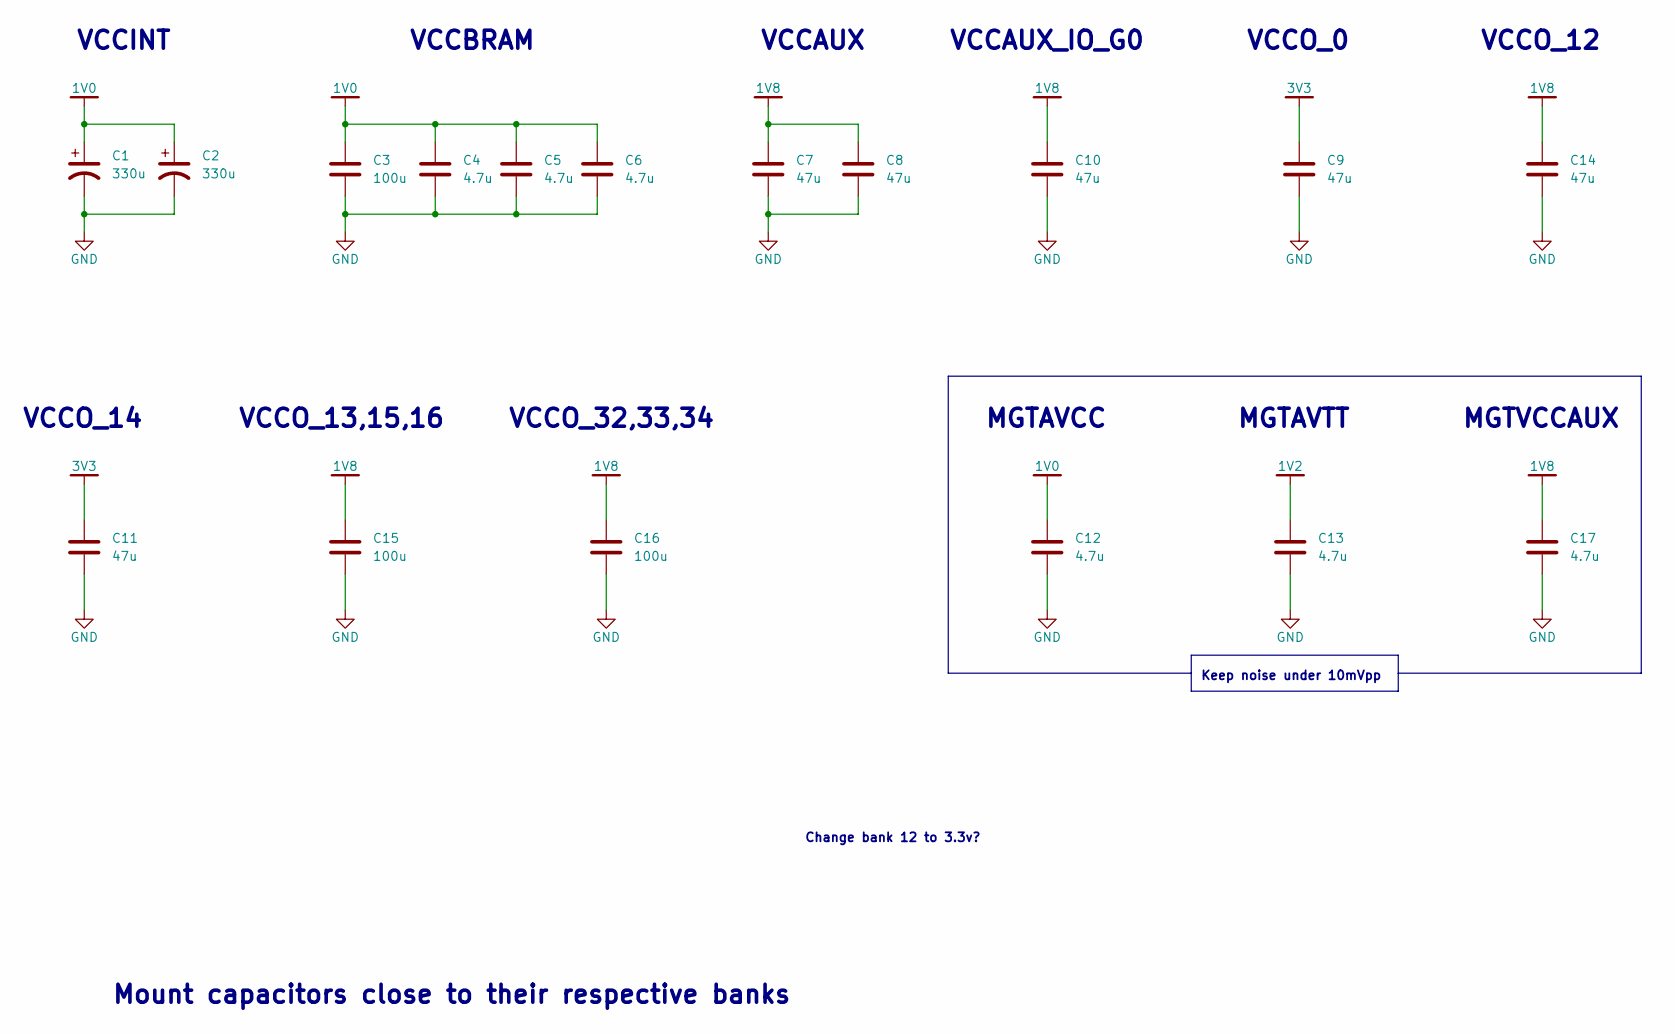
[picture p26: schematic FPGA_Decoupling.kicad_sch]

Parts:
C1, C2: 330u; CP_EIA-7343-20_Kemet-V; Part Number T520V337M2R5ATE025
C3, C15, C16: 100u; C_1210_3225Metric; Part Number GRM32ER60J107ME20L
C4, C5, C6, C12, C13, C17: 4.7u; C_0805_2012Metric; Part Number GRM21BR71C475KE51L
C7, C8, C9, C10, C11, C14: 47u; C_1206_3216Metric; Part Number GRM32ER70J476ME20L

Connections:
1V0: C1.1, C2.1, C3.1, C4.1, C5.1, C6.1, C12.1
1V2: C13.1
1V8: C7.1, C8.1, C10.1, C14.1, C15.1, C16.1, C17.1
3V3: C9.1, C11.1
GND: C1.2, C2.2, C3.2, C4.2, C5.2, C6.2, C7.2, C8.2, C9.2, C10.2, C11.2, C12.2, C13.2, C14.2, C15.2, C16.2, C17.2

Notes on the sheet:
MGTAVTT
VCCAUX_IO_G0
VCCINT
Change bank 12 to 3.3v?
Mount capacitors close to their respective banks
VCCBRAM
MGTVCCAUX
VCCO_32,33,34
VCCO_14
Keep noise under 10mVpp
VCCO_0
VCCO_12
VCCO_13,15,16
VCCAUX
MGTAVCC
