Jordan-HT/Capstone/KiCad/Capstone_Project_Mainboard/FPGA_FLASH.kicad_sch

## KiCad design KiCad/Capstone_Project_Mainboard/FPGA_FLASH.kicad_sch (2023-12-28, an earlier design)

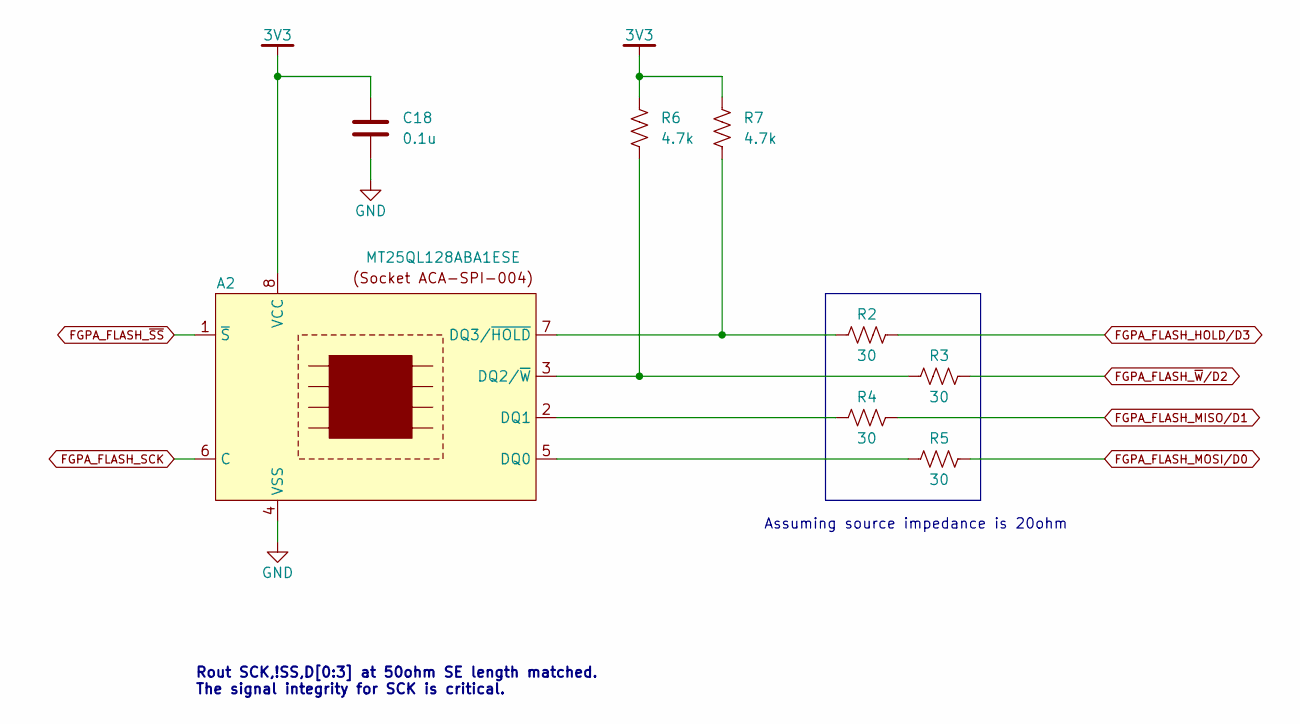
[picture p27: schematic FPGA_FLASH.kicad_sch]

Parts:
A2: MT25QL128ABA1ESE; ACA-SPI-004-K01; Part Number MT25QL128ABA1ESE-0SIT
C18: 0.1u
R2, R3, R4, R5: 30
R6, R7: 4.7k

Connections:
3V3: A2.8 (VCC), C18.1, R6.1, R7.1
FGPA_FLASH_HOLD/D3: R2.2
FGPA_FLASH_MISO/D1: R4.2
FGPA_FLASH_MOSI/D0: R5.2
FGPA_FLASH_SCK: A2.6 (C)
FGPA_FLASH_~SS: A2.1 (~S)
FGPA_FLASH_~W/D2: R3.2
GND: A2.4 (VSS), C18.2
unnamed: A2.2 (DQ1), R4.1
unnamed: A2.3 (DQ2/~W), R3.1, R6.2
unnamed: A2.5 (DQ0), R5.1
unnamed: A2.7 (DQ3/~HOLD), R2.1, R7.2

Notes on the sheet:
Rout SCK,!SS,D[0:3] at 50ohm SE length matched. The signal integrity for SCK is critical.
Assuming source impedance is 20ohm
