Jordan-HT/Capstone/KiCad/Capstone_Project_Mainboard/I2C_EEPROM_Switch.kicad_sch

## KiCad design KiCad/Capstone_Project_Mainboard/I2C_EEPROM_Switch.kicad_sch (2023-12-28)

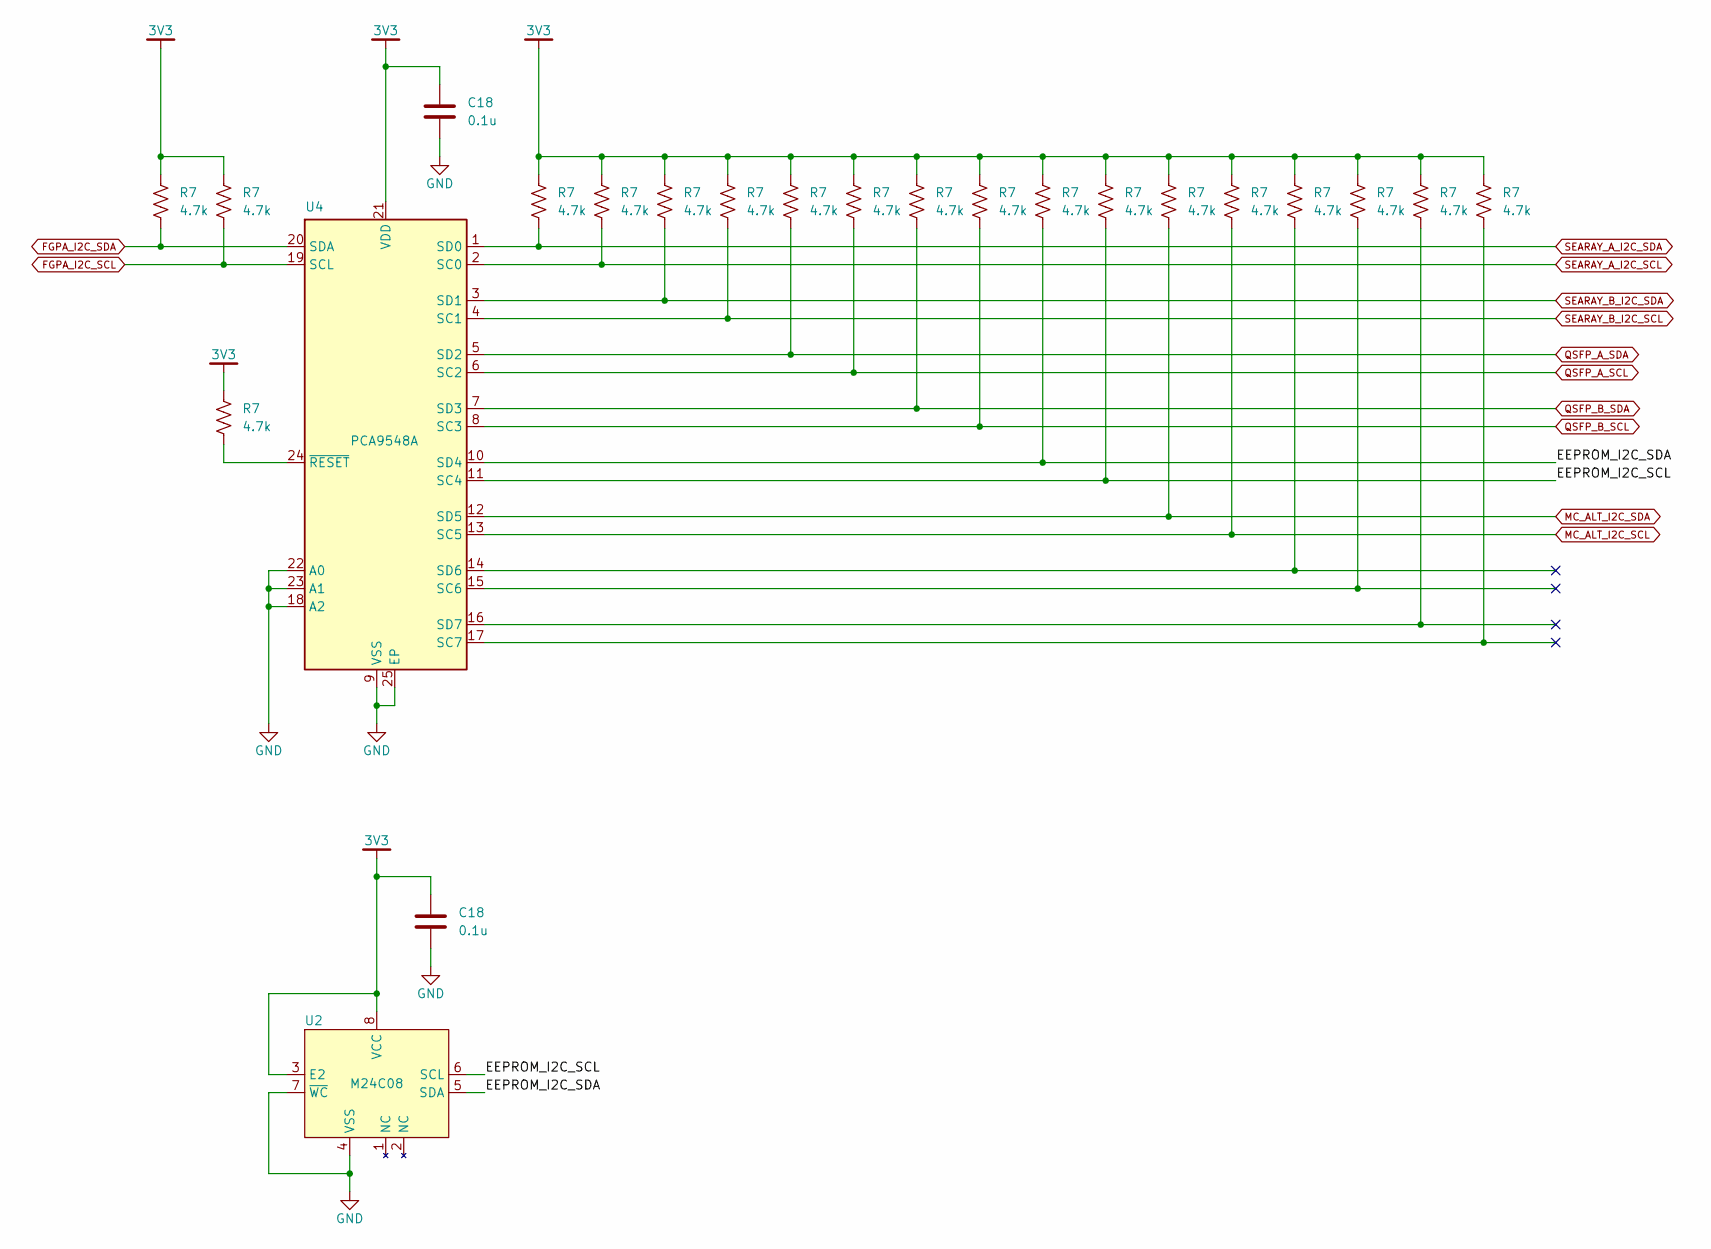
[picture p28: schematic I2C_EEPROM_Switch.kicad_sch]

Parts:
C18: 0.1u; C_0402_1005Metric; Part Number GRM155R71E104ME14J
R7: 4.7k; R_0402_1005Metric; Part Number RC0402FR-074K7L
U2: M24C08; TSSOP-8_4.4x3mm_P0.65mm; Part Number M24C08-RDW6TP
U4: PCA9548A; QFN50P400X400X100-25N-D; Part Number PCA9548ABS,118

Connections:
3V3: C18.1, R7.1, U2.3 (E2), U2.8 (VCC), U4.21 (VDD)
EEPROM_I2C_SCL: R7.2, U2.6 (SCL), U4.11 (SC4)
EEPROM_I2C_SDA: R7.2, U2.5 (SDA), U4.10 (SD4)
FGPA_I2C_SCL: R7.2, U4.19 (SCL)
FGPA_I2C_SDA: R7.2, U4.20 (SDA)
GND: C18.2, U2.4 (VSS), U2.7 (~WC), U4.9 (VSS), U4.18 (A2), U4.22 (A0), U4.23 (A1), U4.25 (EP)
MC_ALT_I2C_SCL: R7.2, U4.13 (SC5)
MC_ALT_I2C_SDA: R7.2, U4.12 (SD5)
unnamed: R7.2, U4.14 (SD6), U4.15 (SC6), U4.16 (SD7), U4.17 (SC7), U4.24 (~RESET)
QSFP_A_SCL: R7.2, U4.6 (SC2)
QSFP_A_SDA: R7.2, U4.5 (SD2)
QSFP_B_SCL: R7.2, U4.8 (SC3)
QSFP_B_SDA: R7.2, U4.7 (SD3)
SEARAY_A_I2C_SCL: R7.2, U4.2 (SC0)
SEARAY_A_I2C_SDA: R7.2, U4.1 (SD0)
SEARAY_B_I2C_SCL: R7.2, U4.4 (SC1)
SEARAY_B_I2C_SDA: R7.2, U4.3 (SD1)
