Jordan-HT/Capstone/KiCad/Capstone_Project_Mainboard/QSFP2.kicad_sch

## KiCad design KiCad/Capstone_Project_Mainboard/QSFP2.kicad_sch (2023-12-28, an earlier design)

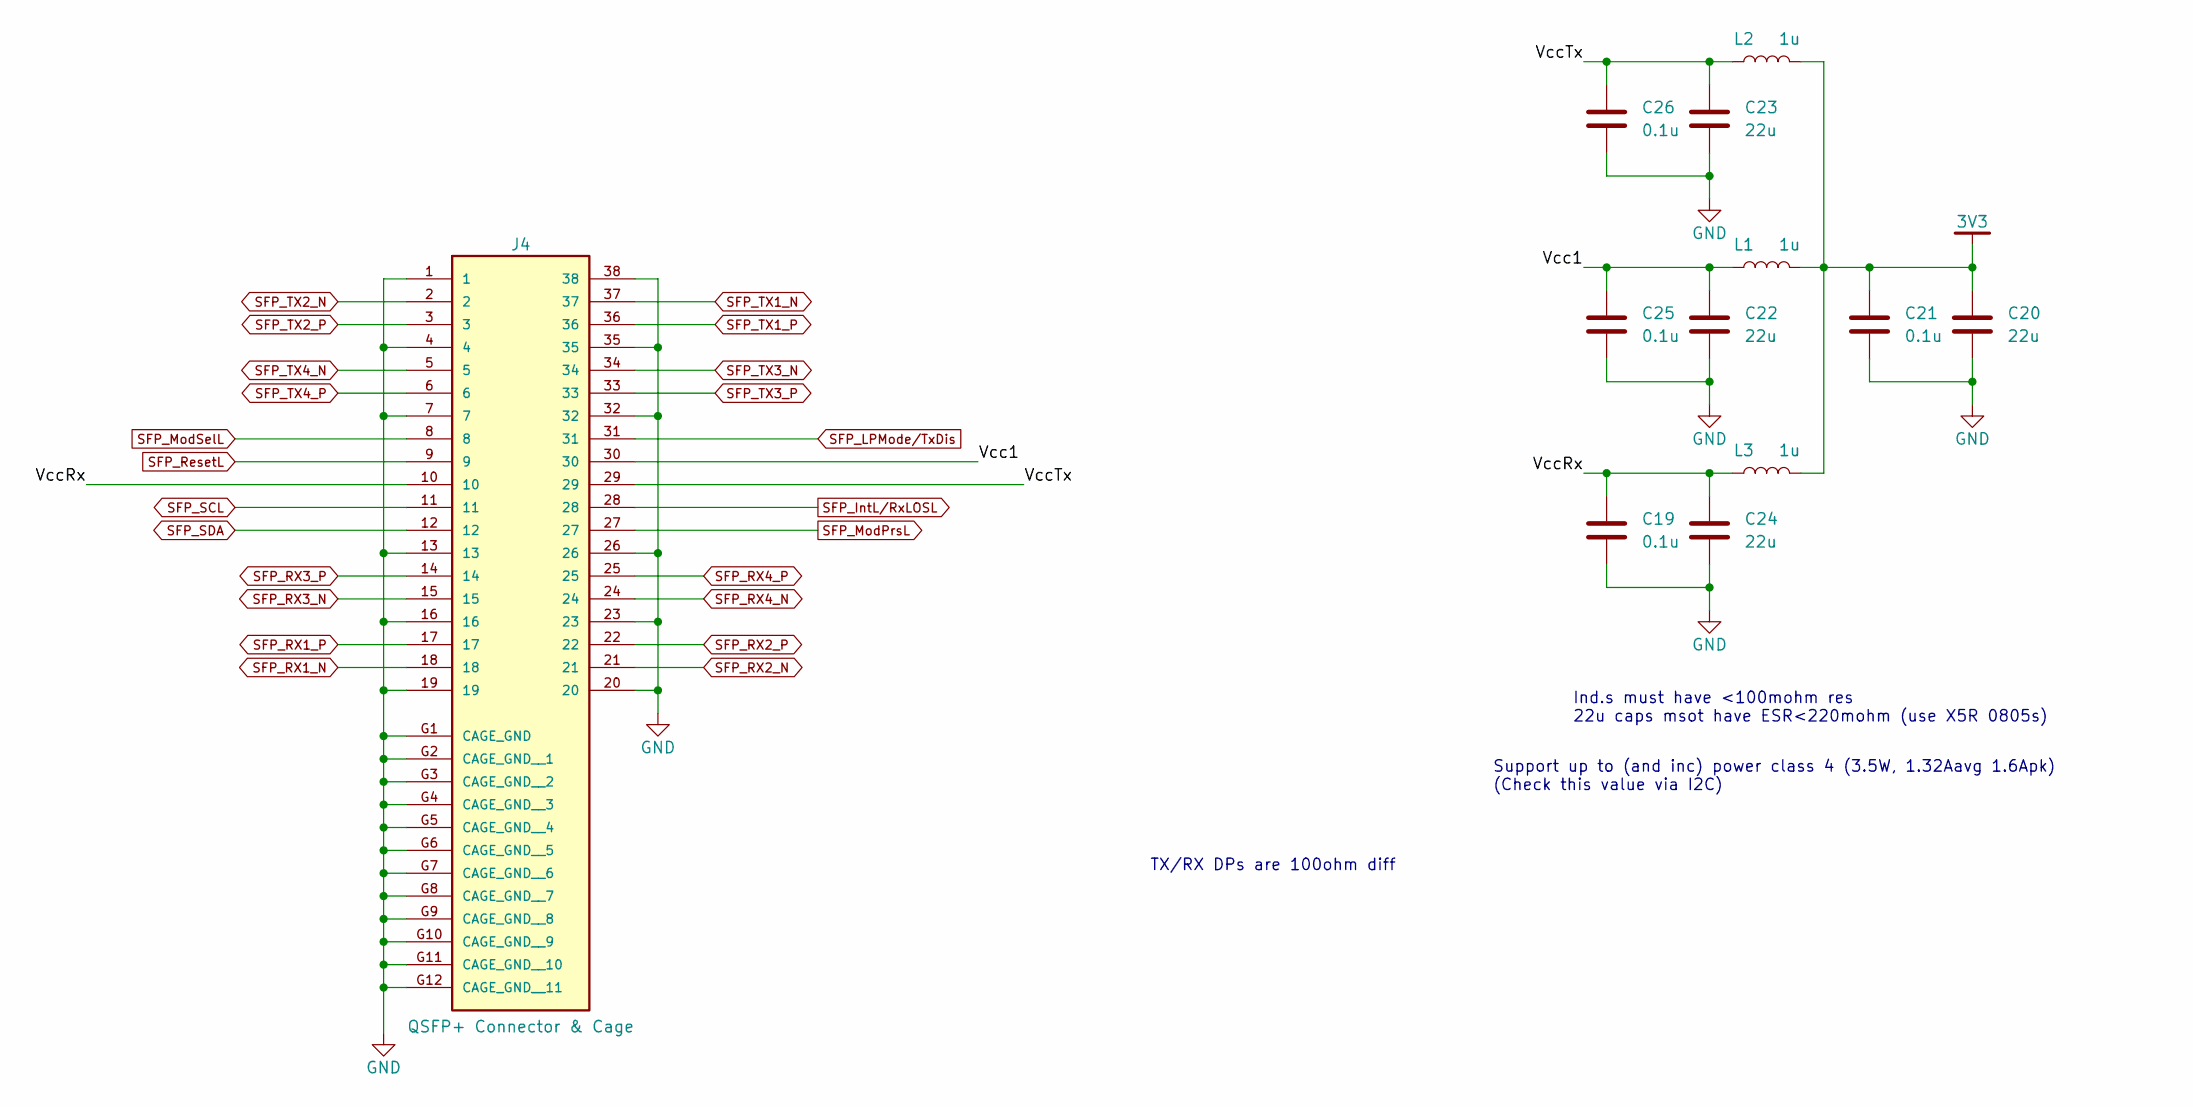
[picture p29: schematic QSFP2.kicad_sch]

Parts:
C19, C21, C25, C26: 0.1u
C20, C22, C23, C24: 22u
J4: QSFP+ Connector & Cage; AMPHENOL_U95T151100A; Part Number U95-T151-100A
L1, L2, L3: 1u

Connections:
3V3: C20.1, C21.1, L1.2, L2.2, L3.2
GND: C19.2, C20.2, C21.2, C22.2, C23.2, C24.2, C25.2, C26.2, J4.1, J4.4, J4.7, J4.13, J4.16, J4.19, J4.20, J4.23, J4.26, J4.32, J4.35, J4.38, J4.G1 (CAGE_GND), J4.G2 (CAGE_GND__1), J4.G3 (CAGE_GND__2), J4.G4 (CAGE_GND__3), J4.G5 (CAGE_GND__4), J4.G6 (CAGE_GND__5), J4.G7 (CAGE_GND__6), J4.G8 (CAGE_GND__7), J4.G9 (CAGE_GND__8), J4.G10 (CAGE_GND__9), J4.G11 (CAGE_GND__10), J4.G12 (CAGE_GND__11)
SFP_IntL/RxLOSL: J4.28
SFP_LPMode/TxDis: J4.31
SFP_ModPrsL: J4.27
SFP_ModSelL: J4.8
SFP_RX1_N: J4.18
SFP_RX1_P: J4.17
SFP_RX2_N: J4.21
SFP_RX2_P: J4.22
SFP_RX3_N: J4.15
SFP_RX3_P: J4.14
SFP_RX4_N: J4.24
SFP_RX4_P: J4.25
SFP_ResetL: J4.9
SFP_SCL: J4.11
SFP_SDA: J4.12
SFP_TX1_N: J4.37
SFP_TX1_P: J4.36
SFP_TX2_N: J4.2
SFP_TX2_P: J4.3
SFP_TX3_N: J4.34
SFP_TX3_P: J4.33
SFP_TX4_N: J4.5
SFP_TX4_P: J4.6
Vcc1: C22.1, C25.1, J4.30, L1.1
VccRx: C19.1, C24.1, J4.10, L3.1
VccTx: C23.1, C26.1, J4.29, L2.1

Notes on the sheet:
Ind.s must have <100mohm res 22u caps msot have ESR<220mohm (use X5R 0805s)
Support up to (and inc) power class 4 (3.5W, 1.32Aavg 1.6Apk) (Check this value via I2C)
TX/RX DPs are 100ohm diff
