Jordan-HT/Capstone/(commit log)

2023-12-19 Initial File Addition
    Added initial KiCad project files and some documentation.
    Slightly behind schedule.
    [01550900DR.stp, 0452007.MRL.stp, 1935161.step, 1V0_PMIC.kicad_sch, 1V2_PMIC.kicad_sch, 1V8_PMIC.kicad_sch, 3V3AUX_1V25REF_PMICs.kicad_sch, 3V3_PMIC.kicad_sch]
2023-12-24 Updated FPGA Footprint
    Added die-to-pad length offsets to all pins of the FFG676 package. These values were derived from the delay files provided in Vivado.
    + Other minor bugfixes
    [1V0_PMIC.kicad_sch, 1V2_PMIC.kicad_sch, 1V8_PMIC.kicad_sch, 3V3AUX_1V25REF_PMICs.kicad_sch, 3V3_PMIC.kicad_sch, Capstone_Project_Mainboard.kicad_sch, FGPA_Main_Power.kicad_sch, FPGA_Bank_0.kicad_sch]
2023-12-28 Core non-power parts defined
    Most major non-power components added to KiCad project
    [1V0_PMIC.kicad_sch, 1V2_PMIC.kicad_sch, 1V8_PMIC.kicad_sch, 3V3AUX_1V25REF_PMICs.kicad_sch, 3V3_PMIC.kicad_sch, 878321420.stp, 904-27-2-23-X-B-0.STEP, Capstone_Project_Mainboard.kicad_sch]
2024-01-06 Started Change to Altium
    Added an Altium Designer directory and project with some of the content from the KiCad project recreated.
    [01550900DR.stp, 0452007.MRL.stp, 1935161.step, 1V0_PMIC.kicad_sch, 1V2_PMIC.kicad_sch, 1V8_PMIC.kicad_sch, 3V3AUX_1V25REF_PMICs.kicad_sch, 3V3_PMIC.kicad_sch]
2024-01-18 Added HPCC & FPGA Framework
    [Capstone_Mainboard.PrjPcb, Capstone_Schematic_Library.SchLib, Configuration_JTAG.SchDoc, FPGA_FLASH.SchDoc, FPGA_GTXqs.SchDoc, FPGA_HPCC_A_BG33-34-35.SchDoc, FPGA_HPCC_B_BG13-15-16.SchDoc, FPGA_Power.SchDoc]
2024-01-24 Assigned FPGA pins for the HPCCs
    [Configuration_JTAG.SchDoc, FPGA_HPCC_B_BG13-15-16.SchDoc, HPCC_Connector_A.SchDoc, HPCC_Connector_B.SchDoc, QSFP_Cages_Connectors.SchDoc]
2024-01-25 Changed Stackup
    Changed stackup from JLC10181H-2313 to JLC122551H-2116 and added it into Altium
    [Capstone_Mainboard.PrjPcb, FPGA_GTXqs.SchDoc, Main_PCB.PcbDoc, PCB Impedance Calclations JLC12251H-2116.xlsx]
2024-01-30 Added Partial Constraints
    [Capstone_Mainboard.PrjPcb, Configuration_JTAG.SchDoc, FPGA_FLASH.SchDoc, FPGA_GTXqs.SchDoc, FPGA_HPCC_A_BG33-34-35.SchDoc, FPGA_HPCC_B_BG13-15-16.SchDoc, FPGA_Power.SchDoc, HPCC_Connector_A.SchDoc]
2024-01-30 Revert "Added Partial Constraints"
    This reverts commit fc329de1ce69882ee90a84450cf58d982e17827d.
    A critical bug caused the Altium project to become useless
    [Capstone_Mainboard.PrjPcb, Configuration_JTAG.SchDoc, FPGA_FLASH.SchDoc, FPGA_GTXqs.SchDoc, FPGA_HPCC_A_BG33-34-35.SchDoc, FPGA_HPCC_B_BG13-15-16.SchDoc, FPGA_Power.SchDoc, HPCC_Connector_A.SchDoc]
2024-01-31 Fixed Differential Pair Nets
    Reverted changed from a critical bug, renamed all differential pair nets, and manually added the differential pair objects via the PCB editor.
    [Capstone_Mainboard.PrjPcb, FPGA_GTXqs.SchDoc, FPGA_HPCC_A_BG33-34-35.SchDoc, FPGA_HPCC_B_BG13-15-16.SchDoc, HPCC_Connector_A.SchDoc, HPCC_Connector_B.SchDoc, I2C_Switch_I2C_EEPROM.SchDoc, Misc_Functions.SchDoc]
2024-02-03 Partial QSFP+ Routing
    Started QSFP+ routing and setup more rules
    [Configuration_JTAG.SchDoc, FPGA_GTXqs.SchDoc, FPGA_HPCC_A_BG33-34-35.SchDoc, FPGA_HPCC_B_BG13-15-16.SchDoc, FPGA_Power.SchDoc]
2024-02-05 Completed routing on first QSFP+ connector
2024-02-05 Added power for second QSFP+ connector
2024-02-06 Completed routing for the second QSFP+ connector
2024-02-10 Partial routing of second HPCC connector
2024-02-13 Reconfigured HPCCs and started cap placement
    [Capstone_Mainboard.PrjPcb, Configuration_JTAG.SchDoc, FPGA_Configuration_JTAG.SchDoc, FPGA_GTXqs.SchDoc, FPGA_HPCC_A_BG33-34-35.SchDoc, FPGA_HPCC_B_BG13-15-16.SchDoc]
2024-02-13 Started preparation to rework QSFP+ connectors
    Created better differential via prefabs and verified that layer 10 can be used without stub issues. Unfortunately, no other non-surface layers can be used.
2024-02-14 Rewired QSFP+ connectors
2024-02-14 Prepared for board house validation output
    Added new fill rule and placed GND fills on all layers.
2024-02-15 Added fills for caps under BGA
    [FPGA_GTXqs.SchDoc]
2024-03-02 Started prep for PDN and uC addition
    Added some parts to the local library and fixed numerous design errors (Not yet sent to PCB)
    [Capstone_Schematic_Library.SchLib, DRL0006A.stp, ECS-1612MV-120-CN-TR.step, FPGA_Configuration_JTAG.SchDoc, FPGA_GTXqs.SchDoc, FPGA_HPCC_A_BG33-34-35.SchDoc, FPGA_HPCC_B_BG13-15-16.SchDoc, FPGA_Power.SchDoc]
2024-03-05 Staging for PDN implementation
    Added footprints and corrected additional errors
    [Capstone_Schematic_Library.SchLib, FPGA_HPCC_A_BG33-34-35.SchDoc]
2024-03-05 Added additional parts to project library
    [Capstone_Schematic_Library.SchLib, Misc_Functions.SchDoc, QSFP_Cages_Connectors.SchDoc]
2024-03-05 Revised newly added symbols
    Removed unneeded pin names/numbers from some symbols
    [Capstone_Schematic_Library.SchLib]
2024-03-06 Added even more supporting devices
    [Capstone_Schematic_Library.SchLib]
2024-03-06 Added passives and homogenized part parameters
    [Capstone_Schematic_Library.SchLib]
2024-03-07 Applied schematic changes
    Applied final changes before SCH-PCB (re)merge
    [Capstone_Schematic_Library.SchLib, FPGA_Configuration_JTAG.SchDoc, FPGA_FLASH.SchDoc, FPGA_GTXqs.SchDoc, FPGA_HPCC_A_BG33-34-35.SchDoc, FPGA_HPCC_B_BG13-15-16.SchDoc, FPGA_Power.SchDoc, HPCC_Connector_A.SchDoc]
2024-03-08 Added more parts but failed to merge
    [Capstone_Schematic_Library.SchLib]
2024-03-09 Added more parts
    [Capstone_Schematic_Library.SchLib]
2024-03-09 Began Migration to New Altium Design
    Created a new Altium Designer project since all (re)merge attempts failed in the prior project.
    [Capstone_Mainboard_B.PrjPcb, Capstone_Schematic_Library.SchLib, Flash_FPGA.SchDoc, Overview_Sheet.SchDoc]
2024-03-10 Added High-Speed Connectors to New Altium Project
    [Capstone_Mainboard_B.PrjPcb, Flash_FPGA.SchDoc, HPCC_Connector_A.SchDoc, HPCC_Connector_B.SchDoc, I2C_Switch_EEPROM.SchDoc, Overview_Sheet.SchDoc, QSFP_Connectors.SchDoc]
2024-03-13 Added new power supplies
    Added 3V3AUX, 3V3, 2V5, 1V2 supplies to the project
    [Capstone_Mainboard_B.PrjPcb, Capstone_Schematic_Library.SchLib, Flash_FPGA.SchDoc, HPCC_Connector_A.SchDoc, HPCC_Connector_B.SchDoc, I2C_Switch_EEPROM.SchDoc, Overview_Sheet.SchDoc, PMIC_1V2_3V3AUX.SchDoc]
2024-03-14 Added remaining PMICs and partial RP2040 sheet
    [Capstone_Mainboard_B.PrjPcb, Capstone_Schematic_Library.SchLib, Flash_FPGA.SchDoc, I2C_Switch_EEPROM.SchDoc, I2C_Temperature_Sensors.SchDoc, Management_RP2040.SchDoc, Overview_Sheet.SchDoc, PMIC_1V0.SchDoc]
2024-03-16 Added supporting schematics
    [Capstone_Mainboard_B.PrjPcb, FGPA_Configuration.SchDoc, FPGA_GTXs.SchDoc, FPGA_HPCC_A_DPs.SchDoc, FPGA_HPCC_B_BG13-15-16.SchDoc, FPGA_HPCC_B_DPs.SchDoc, FPGA_Power.SchDoc, Management_RP2040.SchDoc]
2024-03-20 Updated Schematics
    [Capstone_Mainboard_B.PrjPcb, Capstone_Schematic_Library.SchLib, FGPA_Configuration.SchDoc, FPGA_GTXs.SchDoc, FPGA_HPCC_A_BG33-34-35.SchDoc, FPGA_HPCC_A_DPs.SchDoc, FPGA_HPCC_B_DPs.SchDoc, FPGA_Power.SchDoc]
2024-03-20 Split management microcontroller into two sheets
    [Capstone_Mainboard_B.PrjPcb, Management_RP2040.SchDoc, Management_RP2040_Support.SchDoc, Miscellaneous_Functions.SchDoc, Overview_Sheet.SchDoc]
2024-03-21 Schematic improvements and configuration bug fixes
    [Capstone_Schematic_Library.SchLib, FGPA_Configuration.SchDoc, FPGA_GTXs.SchDoc, FPGA_HPCC_A_DPs.SchDoc, FPGA_HPCC_B_DPs.SchDoc, I2C_Switch_EEPROM.SchDoc, Management_RP2040.SchDoc, Management_RP2040_Support.SchDoc]
2024-03-22 Updated textual information and graphics
    [FGPA_Configuration.SchDoc, FPGA_GTXs.SchDoc, FPGA_HPCC_A_DPs.SchDoc, FPGA_HPCC_B_DPs.SchDoc, FPGA_Power.SchDoc, Flash_FPGA.SchDoc, HPCC_Connector_A.SchDoc, HPCC_Connector_B.SchDoc]
2024-03-24 Reordered sheets
    [Capstone_Mainboard_B.PrjPcb, FGPA_Configuration.SchDoc, FPGA_GTXs.SchDoc, FPGA_HPCC_A_DPs.SchDoc, FPGA_HPCC_B_BG13-15-16.SchDoc, Flash_FPGA.SchDoc, HPCC_Connector_A.SchDoc, HPCC_Connector_B.SchDoc]
2024-03-25 Fixed Power Supply Compensation Networks
    Changed the nets for the compensation networks for the TPS62873-Q1-based supplies to follow the guidance in the datasheet. Testing of the out-of-spec configuration indicates acceptable performance of 20-40mVpp noise independent of loading. Transient/step responses are also acceptable on all supplies except for the 1.2V supply, which experiences 90mVpk over/undershoots and 25mv output sag at 1A.
    [Capstone_Mainboard_B.PrjPcb, FPGA_Power.SchDoc, HPCC_Connector_B.SchDoc, Management_RP2040.SchDoc, Miscellaneous_Functions.SchDoc, PMIC_1V0.SchDoc, PMIC_1V2_3V3AUX.SchDoc, PMIC_1V8.SchDoc]
2024-03-25 Removed Power Failure Detection Circuit
    Testing revealed that the power failure detector circuit triggers too late, and so it was removed from the final design.
    [FGPA_Configuration.SchDoc, HPCC_Connector_A.SchDoc, HPCC_Connector_B.SchDoc, I2C_Temperature_Sensors.SchDoc, Management_RP2040.SchDoc, Management_RP2040_Support.SchDoc, Overview_Sheet.SchDoc, Power_Input_Indicators.SchDoc]
2024-03-25 Annotated Schematic, Added PCB Stackup, and Added Impedance Profiles
    Created the PCB file and added the necessary setup as described in the title of the commit
    [Capstone_Mainboard_B.PrjPcb, FGPA_Configuration.SchDoc, FPGA_GTXs.SchDoc, FPGA_HPCC_A_DPs.SchDoc, FPGA_HPCC_B_DPs.SchDoc, FPGA_Power.SchDoc, Flash_FPGA.SchDoc, HPCC_Connector_A.SchDoc]
2024-03-25 Updated Title Block and PDF Output Parameters
    [Capstone_Mainboard_B.PrjPcb, Capstone_Schematic_Library.SchLib, FGPA_Configuration.SchDoc, FPGA_GTXs.SchDoc, FPGA_HPCC_A_DPs.SchDoc, FPGA_HPCC_B_DPs.SchDoc, FPGA_Power.SchDoc, Flash_FPGA.SchDoc]
2024-03-26 Adjusted GTX Power Supplies Control Voltage
    [FPGA_GTXs.SchDoc, FPGA_Power.SchDoc, Flash_FPGA.SchDoc, Miscellaneous_Functions.SchDoc, PMIC_GTXs.SchDoc]
2024-03-26 Removed 1.2V Switching Power Supply for GTXs
    The switch to linear supplies for the GTXs obsoleted the existing 1.2V switching supply, so it was removed.
    Additionally, the "POWER" netclass was added.
    [Capstone_Mainboard_B.PrjPcb, FGPA_Configuration.SchDoc, FPGA_GTXs.SchDoc, FPGA_HPCC_A_DPs.SchDoc, FPGA_HPCC_B_DPs.SchDoc, FPGA_Power.SchDoc, Flash_FPGA.SchDoc, HPCC_Connector_A.SchDoc]
2024-03-27 Added PCB Rules and Made Minor Footprint Changes
    [Miscellaneous_Functions.SchDoc]
2024-03-27 Added HPCC B Pair Fanout
    Also fixed the footprint for the TPS62873-Q1
2024-03-28 Routed HPCC B Differential Pairs
    [FGPA_Configuration.SchDoc, FPGA_GTXs.SchDoc, FPGA_HPCC_A_DPs.SchDoc, FPGA_HPCC_B_DPs.SchDoc, FPGA_Power.SchDoc]
2024-03-29 Finished DPs for HPCC B and Added Ground Via Fences for HPCCs
2024-03-31 Partially Routed QSFP Power and Added Via Cages
2024-03-31 Started FPGA PDN Layout
    [FPGA_Power.SchDoc, Management_RP2040.SchDoc]
2024-04-01 Pre-Routed Switching PMICs
    [Management_RP2040.SchDoc, PMIC_2V5.SchDoc]
2024-04-02 Updated PDN and Added Power Input Section
2024-04-03 Updated Power and I2C Layout
    [PMIC_3V3AUX_PWR-DEF.SchDoc]
2024-04-03 Updated Layout and Changed Board Outline
2024-04-04 Moved the Last Free-Floating Parts onto the PCB
2024-04-12 Routed non-power I2C nets
2024-04-12 Un-routed QSFP I2C nets, partially routed all other control signals
2024-04-13 Routed I2C for PMICs
2024-04-13 Fixed minor schematic issues and started power routing
    [FGPA_Configuration.SchDoc, Management_RP2040.SchDoc]
2024-04-13 Fixed power and keepout clearances and added outer fills
2024-04-13 Began placing power polygons on back of BGA
2024-04-14 Partially routed power planes
2024-04-14 Routed power plane sense nets
2024-04-15 Finished power pours
2024-04-16 Finished all power routing and placed silkscreen
2024-04-16 Fixed power sense bug and added more silkscreen
2024-04-16 Created test production files
    [Capstone_Mainboard_B.PrjPcb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]
2024-04-18 Began moving silkscreen off DPs and added teardrops
2024-04-20 Optimized silkscreen
2024-04-24 Changed silkscreen, optimized paste layer for 0.15mm stencil
2024-04-24 Fixed BGA and contact pad solder paste
2024-04-26 Updated Silkscreen and Added Sponsor Logo
    A-Tek Systems has graciously provided some PFPE fluid for soldering the PCB
2024-04-26 Updated Block Diagram
    [Overview_Sheet.SchDoc]
2024-04-27 Updated Review Fields
    [FGPA_Configuration.SchDoc, FPGA_GTXs.SchDoc, FPGA_HPCC_A_DPs.SchDoc, FPGA_HPCC_B_DPs.SchDoc, FPGA_Power.SchDoc, Flash_FPGA.SchDoc, HPCC_Connector_A.SchDoc, HPCC_Connector_B.SchDoc]
2024-04-30 Initial Production Version
    The factory has found that the outputs include DPs which are only 3.1mil spaced, suggesting that Altium lied in its DRC.
    [Capstone_Mainboard_B.PrjPcb, Capstone_Mainboard_B_BOM.xlsx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]
2024-04-30 Created New Hardware Arc Production Version
    A slightly modified design variant with hardware arc export
    [Capstone_Mainboard_B.PrjPcb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]
2024-05-04 Added first power control code sources
2024-05-29 Updated Schematic Color and Version
    [Capstone_Mainboard_B.PrjPcb, FGPA_Configuration.SchDoc, FPGA_GTXs.SchDoc, FPGA_HPCC_A_DPs.SchDoc, FPGA_HPCC_B_DPs.SchDoc, FPGA_Power.SchDoc, Flash_FPGA.SchDoc, HPCC_Connector_A.SchDoc]
